zzorn/Mendel90/dibond/render/printed/x_carriage_parts.png

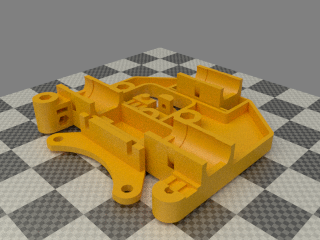
dibond/render/printed/x_carriage_parts.png
