zzorn/Mendel90/mendel/render/printed/wades_extruder.png

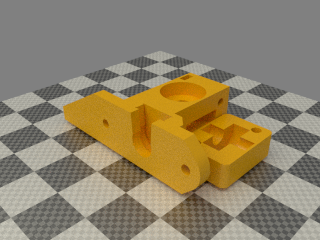
mendel/render/printed/wades_extruder.png
