zzorn/Mendel90/dibond/render/atx_long_bracket.png

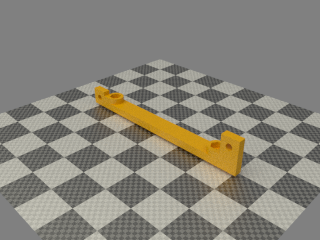
dibond/render/atx_long_bracket.png
