zzorn/Mendel90/dibond/render/atx_short_bracket.png

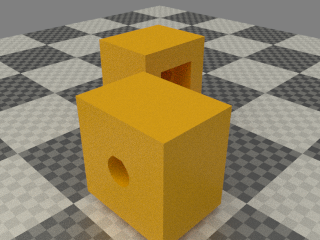
dibond/render/atx_short_bracket.png
