zzorn/Mendel90/dibond/render/d_motor_bracket.png

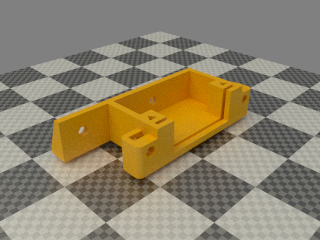
dibond/render/d_motor_bracket.png
