zzorn/Mendel90/dibond/render/d_motor_bracket_lid.png

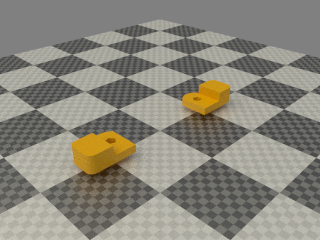
dibond/render/d_motor_bracket_lid.png
