zzorn/Mendel90/dibond/render/d_shell.png

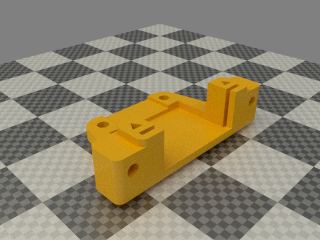
dibond/render/d_shell.png
