zzorn/Mendel90/dibond/render/d_shell_lid.png

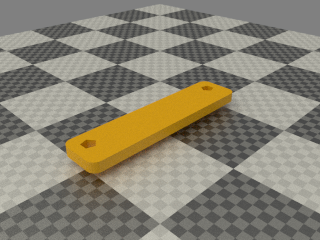
dibond/render/d_shell_lid.png
