zzorn/Mendel90/dibond/render/dust_filter.png

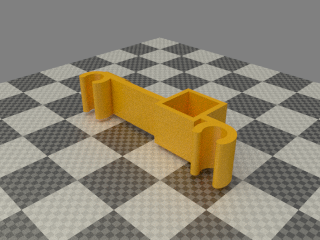
dibond/render/dust_filter.png
