zzorn/Mendel90/dibond/render/fan_guard.png

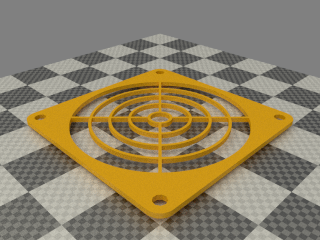
dibond/render/fan_guard.png
