zzorn/Mendel90/dibond/render/feed_tube_connector.png

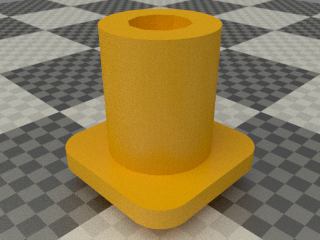
dibond/render/feed_tube_connector.png
