zzorn/Mendel90/dibond/render/fixing_block.png

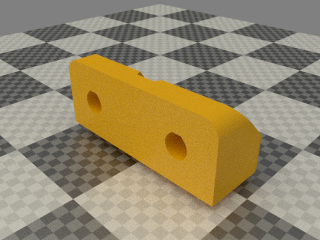
dibond/render/fixing_block.png
