zzorn/Mendel90/dibond/render/jhead_insertion_jig.png

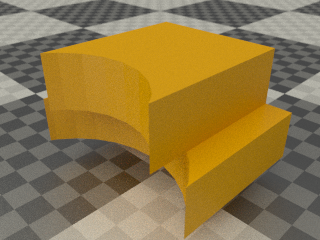
dibond/render/jhead_insertion_jig.png
