zzorn/Mendel90/dibond/render/pcb_spacer.png

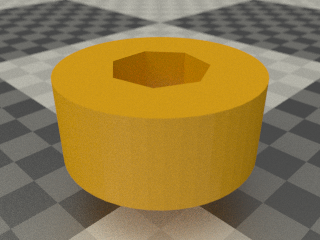
dibond/render/pcb_spacer.png
