zzorn/Mendel90/dibond/render/ribbon_clamp_14_33.png

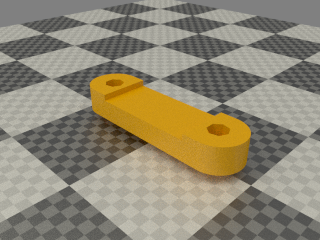
dibond/render/ribbon_clamp_14_33.png
