zzorn/Mendel90/dibond/render/ribbon_clamp_14_33NB.png

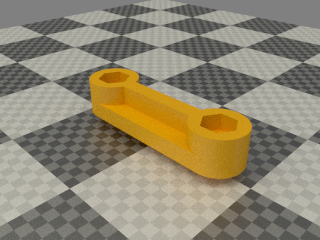
dibond/render/ribbon_clamp_14_33NB.png
