zzorn/Mendel90/dibond/render/ribbon_clamp_20_33.png

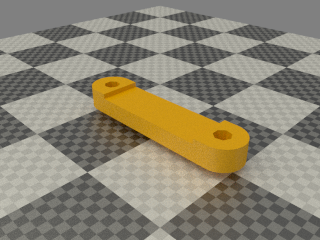
dibond/render/ribbon_clamp_20_33.png
