zzorn/Mendel90/dibond/render/ribbon_clamp_20_44N.png

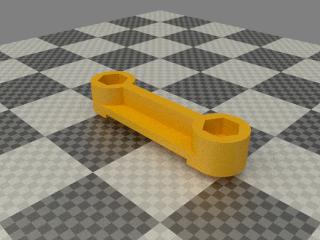
dibond/render/ribbon_clamp_20_44N.png
