zzorn/Mendel90/dibond/render/ribbon_clamp_26_44N.png

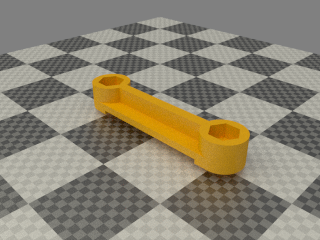
dibond/render/ribbon_clamp_26_44N.png
