zzorn/Mendel90/dibond/render/spool_bracket_female.png

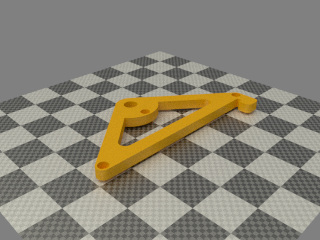
dibond/render/spool_bracket_female.png
