zzorn/Mendel90/dibond/render/spool_bracket_male.png

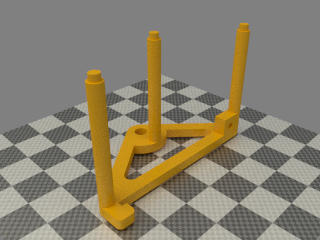
dibond/render/spool_bracket_male.png
