zzorn/Mendel90/dibond/render/tube_cap.png

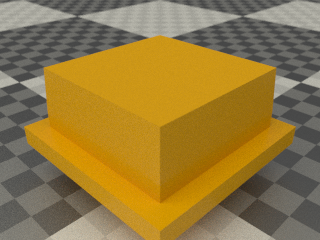
dibond/render/tube_cap.png
