zzorn/Mendel90/dibond/render/tube_jig.png

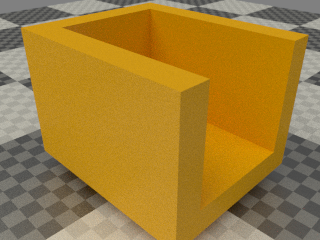
dibond/render/tube_jig.png
