zzorn/Mendel90/dibond/render/wades_big_gear.png

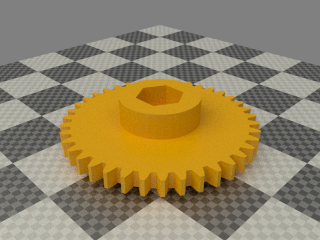
dibond/render/wades_big_gear.png
