zzorn/Mendel90/dibond/render/wades_block.png

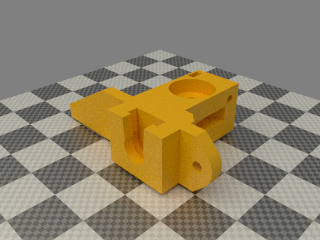
dibond/render/wades_block.png
