zzorn/Mendel90/dibond/render/wades_gear_spacer.png

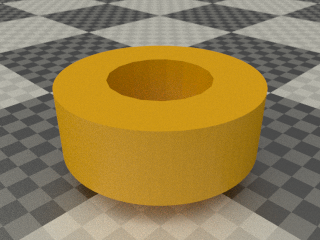
dibond/render/wades_gear_spacer.png
