zzorn/Mendel90/dibond/render/wades_idler_block.png

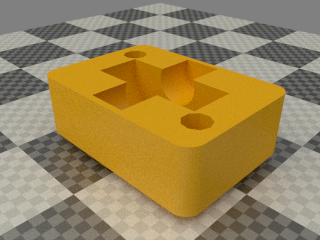
dibond/render/wades_idler_block.png
