zzorn/Mendel90/dibond/render/wades_small_gear.png

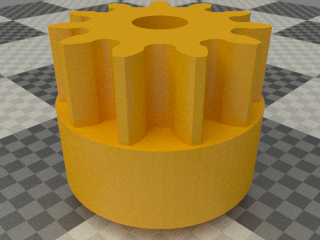
dibond/render/wades_small_gear.png
