zzorn/Mendel90/dibond/render/x_belt_clamp.png

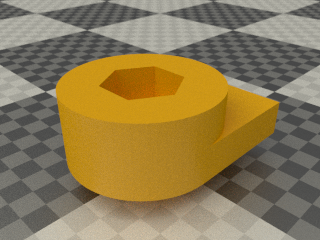
dibond/render/x_belt_clamp.png
