zzorn/Mendel90/dibond/render/x_belt_grip.png

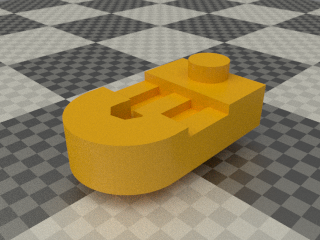
dibond/render/x_belt_grip.png
