zzorn/Mendel90/dibond/render/x_belt_tensioner.png

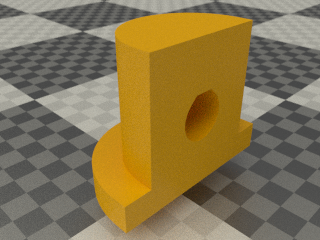
dibond/render/x_belt_tensioner.png
