zzorn/Mendel90/dibond/render/x_carriage_fan_bracket.png

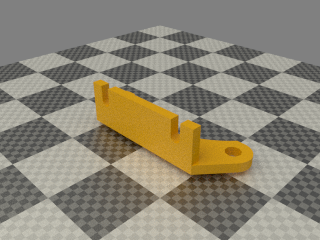
dibond/render/x_carriage_fan_bracket.png
