zzorn/Mendel90/dibond/render/x_carriage_fan_duct.png

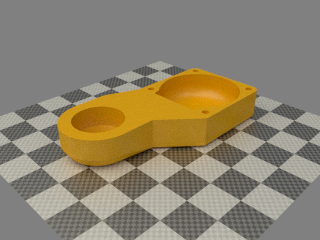
dibond/render/x_carriage_fan_duct.png
