zzorn/Mendel90/dibond/render/x_idler_bracket.png

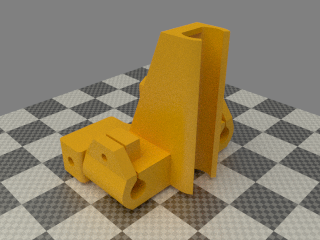
dibond/render/x_idler_bracket.png
