zzorn/Mendel90/dibond/render/x_motor_bracket.png

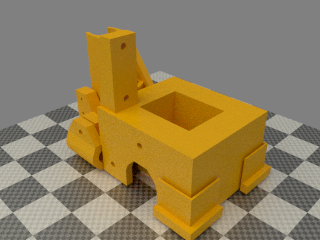
dibond/render/x_motor_bracket.png
