zzorn/Mendel90/dibond/render/y_bar_clamp.png

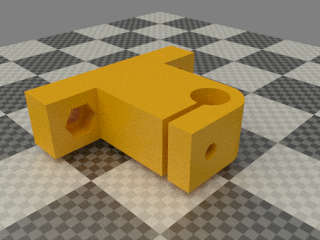
dibond/render/y_bar_clamp.png
