zzorn/Mendel90/dibond/render/y_bar_clamp_switch.png

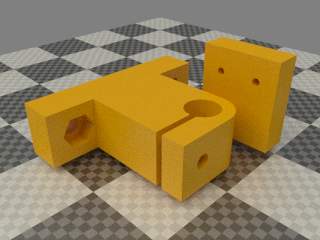
dibond/render/y_bar_clamp_switch.png
