zzorn/Mendel90/dibond/render/y_bearing_mount.png

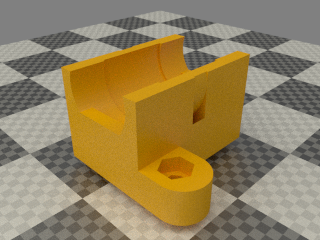
dibond/render/y_bearing_mount.png
