zzorn/Mendel90/dibond/render/y_belt_anchor.png

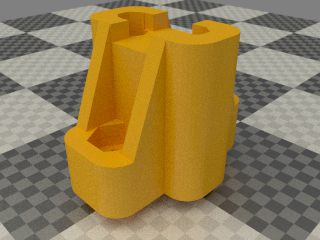
dibond/render/y_belt_anchor.png
