zzorn/Mendel90/dibond/render/y_belt_clip.png

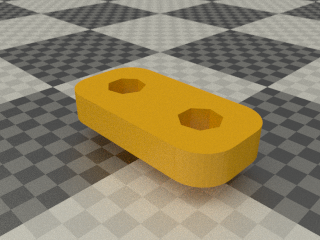
dibond/render/y_belt_clip.png
