zzorn/Mendel90/dibond/render/y_idler_bracket.png

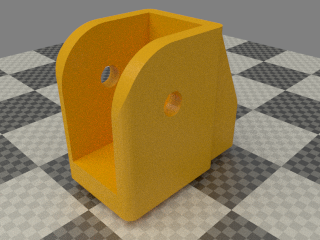
dibond/render/y_idler_bracket.png
