zzorn/Mendel90/dibond/render/y_motor_bracket.png

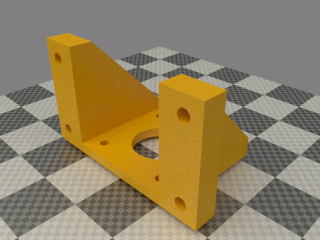
dibond/render/y_motor_bracket.png
