zzorn/Mendel90/dibond/render/z_coupling.png

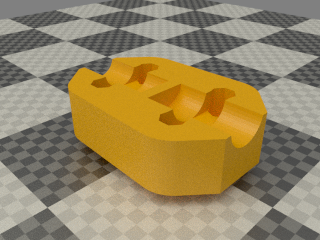
dibond/render/z_coupling.png
