zzorn/Mendel90/dibond/render/z_motor_bracket_lhs.png

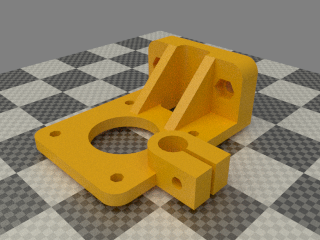
dibond/render/z_motor_bracket_lhs.png
