zzorn/Mendel90/dibond/render/z_motor_bracket_rhs.png

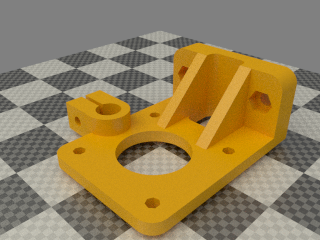
dibond/render/z_motor_bracket_rhs.png
