zzorn/Mendel90/dibond/render/z_screw_pointer.png

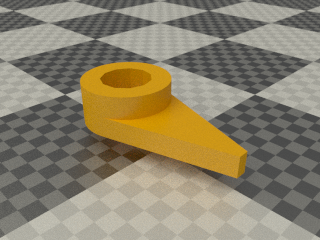
dibond/render/z_screw_pointer.png
