zzorn/Mendel90/mendel/render/atx_short_bracket.png

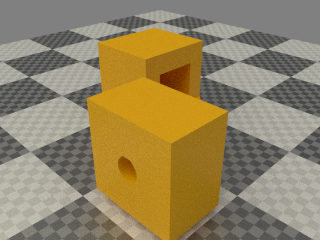
mendel/render/atx_short_bracket.png
