zzorn/Mendel90/mendel/render/pulley.png

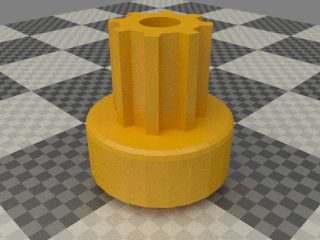
mendel/render/pulley.png
