zzorn/Mendel90/mendel/render/spool_bracket_female.png

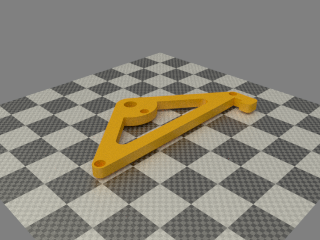
mendel/render/spool_bracket_female.png
