zzorn/Mendel90/mendel/render/spool_bracket_male.png

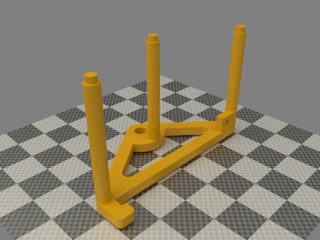
mendel/render/spool_bracket_male.png
