zzorn/Mendel90/mendel/render/y_bearing_mount.png

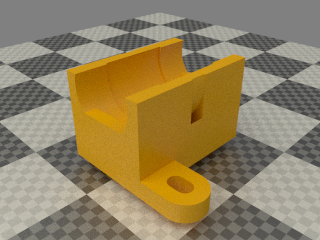
mendel/render/y_bearing_mount.png
