zzorn/Mendel90/mendel/render/y_idler_bracket.png

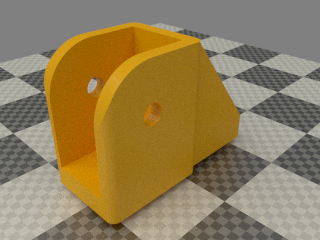
mendel/render/y_idler_bracket.png
