zzorn/Mendel90/sturdy/render/mains_inlet.png

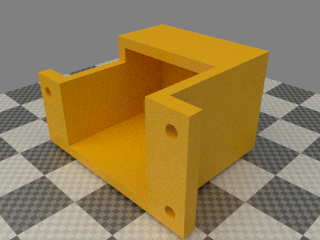
sturdy/render/mains_inlet.png
