zzorn/Mendel90/sturdy/render/spool_bracket_male.png

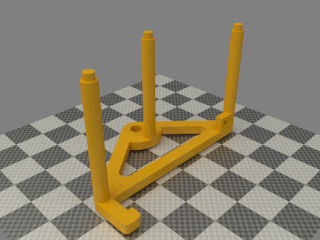
sturdy/render/spool_bracket_male.png
