zzorn/Mendel90/sturdy/render/x_carriage.png

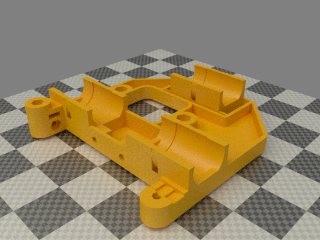
sturdy/render/x_carriage.png
