zzorn/Mendel90/sturdy/render/x_carriage_fan_duct.png

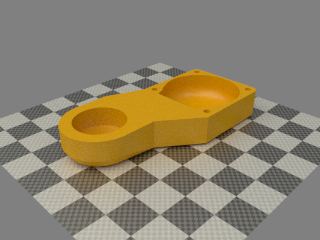
sturdy/render/x_carriage_fan_duct.png
