zzorn/Mendel90/sturdy/render/x_idler_bracket.png

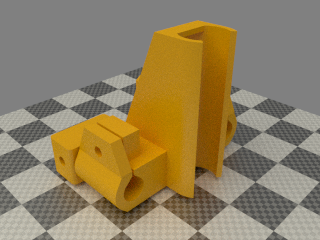
sturdy/render/x_idler_bracket.png
