zzorn/Mendel90/sturdy/render/y_bearing_mount.png

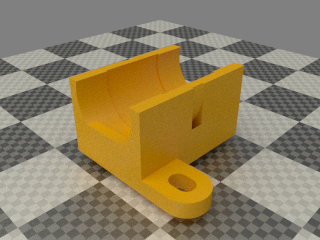
sturdy/render/y_bearing_mount.png
