zzorn/Mendel90/sturdy/render/z_bar_clamp.png

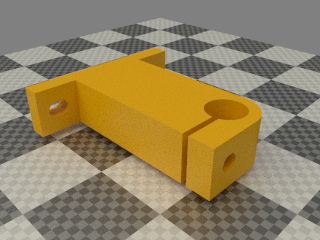
sturdy/render/z_bar_clamp.png
