zzorn/Mendel90/sturdy/render/z_motor_bracket_lhs.png

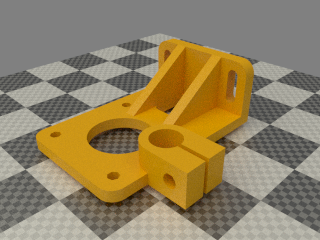
sturdy/render/z_motor_bracket_lhs.png
