zzorn/Mendel90/sturdy-a4/bom/bom.txt

Vitamins:
          E                                                      
          x                                                      
          t                                                      
          r                                                      
          u                                                      
          d                                                      
          e                                                      
          r                                                      
                                                                 
          c  E                          X                        
          o  x                                                   
          n  t                 S        c                        
    E     n  r                 p        a                        
    l     e  u                 o     X  r           Y            
    e     c  d           P     o        r                        
    c  E  t  e           r     l     c  i           c            
 B  t  x  i  r     H  M  i           a  a  X  X     a  Y  Y     Z
 e  r  t  o        o  a  n     h  X  r  g        Y  r        Z   
 d  o  r  n  m  F  t  c  t     o     r  e  i  m     r  i  m     m
    n  u     o  r     h        l  a  i     d  o  a  i  d  o  a  o
 f  i  d  p  t  a  e  i  b  P  d  x  a  f  l  t  x  a  l  t  x  t
 a  c  e  c  o  m  n  n  e  s  e  i  g  a  e  o  i  g  e  o  i  o
 n  s  r  b  r  e  d  e  d  u  r  s  e  n  r  r  s  e  r  r  s  r
  |  |  |  |  |  |  |  |  | 1|  |  |  |  |  |  |  |  |  |  |  |  |  1 THS15 Aluminium clad resistor 10R
  |  |  |  |  |  |  |  |  | 1|  |  |  |  |  |  |  |  |  |  |  |  |  1 THS15 Aluminium clad resistor 4R7
  |  |  |  |  |  |  |  | 6|  |  |  |  |  |  |  |  |  |  |  |  |  |  6 Aluminium foil tape 50mm x 220mm x 0.05mm
  |  |  |  |  |  |  |  |  | 1|  |  |  |  |  |  |  |  |  |  |  |  |  1 PSU e.g. ATX500
  |  | 3|  |  |  |  |  |  |  | 4|  |  |  |  |  |  |  |  |  |  |  |  7 Ball bearing 608 8mm x 22mm x 7mm
  |  |  |  |  |  |  |  |  |  |  |  |  |  | 2|  |  |  | 2|  |  |  |  4 Ball bearing 624 4mm x 13mm x 5mm
  |  |  |  |  |  |  |  | 4|  |  |  |  |  |  |  |  |  |  |  |  |  |  4 19mm bulldog clip
  |  |  |  |  |  |  |  | 1|  |  |  |  |  |  |  |  |  |  |  |  |  |  1 PCB bed 287mm x 200mm
  |  |  |  |  |  |  |  |  |  |  | 1|  |  |  |  |  |  |  |  |  |  |  1 Belt T5 x 6mm x 1055mm (PU & Kevlar)
  |  |  |  |  |  |  |  |  |  |  |  |  |  |  |  | 1|  |  |  |  |  |  1 Belt T5 x 6mm x 660mm (PU & Kevlar)
  |  |  |  |  |  |  |  | 1|  |  |  |  |  |  |  |  |  |  |  |  |  |  1 Corrugated cardboard 273mm x 210mm x 6mm
  |  |  |  |  |  |  |  | 4|  |  |  | 2|  |  |  |  |  |  |  |  |  |  6 M3 cap screw x 10mm
  | 4|  |  |  |  |  |  |  |  |  |  |  |  |  | 4|  | 8|  |  |  |  | 16 M3 cap screw x 16mm
  |  |  |  |  |  |  |  |  |  |  |  | 1|  |  | 2|  |  |  |  |  | 8| 11 M3 cap screw x 20mm
  |  |  |  |  |  |  |  |  |  |  |  | 2|  |  |  |  |  |  |  |  |  |  2 M3 cap screw x 25mm
  |  |  |  | 2|  |  |  |  |  |  |  |  |  |  |  |  |  |  |  |  |  |  2 M3 cap screw x 45mm
  |  |  |  |  |  |  |  |  |  |  |  |  |  |  |  |  | 6|  |  |  |  |  6 M4 cap screw x 16mm
  |  |  |  |  |  |  |  |  |  |  |  |  |  |  |  | 4| 2|  |  | 2| 2| 10 M4 cap screw x 20mm
 4|  |  |  |  |  |  |  |  |  |  |  |  |  |  |  |  |  |  |  |  |  |  4 M4 cap screw x 25mm
  |  |  |  |  |  |  |  |  |  |  |  |  | 4|  |  |  |  | 1|  |  |  |  5 M4 cap screw x 30mm
  |  |  |  |  |  |  |  |  |  |  |  |  |  | 1|  |  |  |  |  |  |  |  1 M4 cap screw x 45mm
  |  |  |  |  |  |  |  |  |  | 4|  |  |  |  |  |  |  |  |  |  |  |  4 M8 cap screw x 30mm
  |  |  |  |  |  |  |  |  |  |  |  |  |  |  |  |  | 1|  |  |  |  |  1 Dibond sheet 297mm x 210mm x 3mm
  |  |  |  | 1|  |  |  |  |  |  |  |  |  |  |  |  |  |  |  |  |  |  1 15 way D PCB mount plug
  |  |  |  |  |  |  |  |  |  |  |  |  |  |  | 1|  |  |  |  |  |  |  1 15 way D IDC socket
  |  |  |  |  |  |  |  |  |  |  |  |  | 1|  |  |  |  |  |  |  |  |  1 Fan 60mm x 15mm
  |  |  |  |  |  |  |  |  |  | 1|  |  |  |  |  |  |  |  |  |  |  |  1 Foam sponge 20mm x 20mm x 20mm
  |  |  |  |  |  |  |  |  |  |  |  |  |  |  | 1|  |  |  | 1|  |  |  2 M3 grub screw x 3mm
  |  |  |  | 1|  |  |  |  |  |  |  |  |  |  |  |  |  |  |  |  |  |  1 M3 grub screw x 6mm
  |  |  |  |  |  |  |  | 1|  |  |  |  |  |  |  |  |  |  |  |  |  |  1 Glass sheet 287mm x 188mm x 2mm
  |  |  |  |  |  | 1|  |  |  |  |  |  |  |  |  |  |  |  |  |  |  |  1 JHead MK4 hot end
  |  |  |  |  |  |  |  | 4|  |  |  |  |  |  |  |  |  |  |  |  |  |  4 Hex male / female pillar M3 x 20mm
  |  | 3|  |  |  |  |  |  |  |  |  |  |  |  |  |  |  |  |  |  |  |  3 M3 hex screw x 10mm
  |  |  |  |  |  |  |  |  |  |  |  |  |  |  | 2|  |  |  |  |  |  |  2 M3 hex screw x 16mm
  |  |  |  |  |  |  |  |  |  |  |  |  |  | 2| 2|  |  |  |  |  |  |  4 M4 hex screw x 16mm
  |  | 2|  |  |  |  |  |  |  |  |  |  |  |  |  |  |  |  |  |  |  |  2 M4 hex screw x 20mm
  |  | 2|  |  |  |  |  |  |  |  |  |  |  |  |  |  |  |  |  |  |  |  2 M4 hex screw x 50mm
  |  | 1|  |  |  |  |  |  |  |  |  |  |  |  |  |  |  |  |  |  |  |  1 M8 hex screw x 60mm, hobbed at 25
  |  |  |  |  |  |  |  |  |  |  |  | 3|  | 2| 2|  | 3|  |  |  |  | 10 LM10UU linear bearing
  |  |  |  |  | 2|  |  |  |  |  |  |  |  |  |  |  |  |  |  |  |  |  2 MDF sheet 153mm x 435mm x 12mm
  |  |  |  |  | 1|  |  |  |  |  |  |  |  |  |  |  |  |  |  |  |  |  1 MDF sheet 562mm x 419mm x 12mm
  |  |  |  |  | 1|  |  |  |  |  |  |  |  |  |  |  |  |  |  |  |  |  1 MDF sheet 562mm x 435mm x 12mm
  |  |  |  | 1|  |  |  |  |  |  |  |  |  |  | 1|  |  |  | 1|  | 2|  5 NEMA17 x 47.5mm stepper motor
  |  |  |  |  |  |  |  |  |  |  |  |  |  |  |  |  |  |  |  | 2|  |  2 Brass nut M8
  |  |  |  | 3|  |  |  |  |  |  |  | 1|  |  |  |  |  |  |  |  |  |  4 Nut M3
  |  | 2|  |  |  |  |  |  |  |  |  |  |  |  |  |  |  |  |  |  |  |  2 Nut M4
  |  | 2|  |  |  |  |  |  |  |  |  |  |  |  |  |  |  |  |  |  |  |  2 Nut M8
  |  |  |  |  |  |  |  |  |  |  |  | 4|  |  | 6|  | 8|  |  |  | 8| 26 Nyloc nut M3
 4|  |  |  |  |  |  |  |  |  |  |  |  | 4| 3| 2| 4| 8| 1|  | 2| 2| 30 Nyloc nut M4
  |  |  |  |  |  |  |  |  |  | 4|  |  |  |  |  |  |  |  |  |  |  |  4 Nyloc nut M8
  |  |  |  |  |  |  |  |  |  |  |  |  |  |  | 2|  |  |  |  |  |  |  2 Nitrile O-ring 2.5mm x 1.6mm
  |  |  | 1|  |  |  |  |  |  |  |  |  |  |  |  |  |  |  |  |  |  |  1 Extruder connection PCB
  |  |  |  |  |  |  |  |  |  | 1|  |  |  |  |  |  |  |  |  |  |  |  1 PLA sample 0.3mm ~20m
  |  |  |  |  |  |  |  |  |  |  |  |  |  |  | 1|  |  |  |  |  |  |  1 Polypropylene strip 484mm x 18mm x 0.5mm
  |  |  |  |  |  |  |  |  |  |  |  |  |  |  | 1|  |  |  |  |  |  |  1 Polypropylene strip 552mm x 25mm x 0.5mm
  |  |  |  |  |  |  |  | 1|  |  |  |  |  |  |  |  |  |  |  |  |  |  1 Polypropylene strip 273mm x 33mm x 0.5mm
  |  |  |  |  |  |  |  |  |  |  |  |  |  |  | 3|  |  |  | 4|  | 8| 15 M3 pan screw x 8mm
  |  |  |  |  |  |  |  |  | 2|  |  |  |  |  |  |  |  |  |  |  |  |  2 6-32 pan screw x 9.5mm
  |  |  |  | 2|  |  |  |  |  |  |  |  |  |  | 4| 2|  |  |  | 2|  | 10 No2 pan wood screw x 13mm
  |  |  |  |  |  |  |  |  | 4|  |  |  |  |  |  |  |  |  |  |  |  |  4 No2 pan wood screw x undefmm
  |  |  |  |  |39|  |  |  | 3| 2|  |  |  |  |  | 8|  | 1| 4| 4| 4| 65 No6 pan wood screw x 16mm
  |  |  |  |  |  |  |  |  |  |  |  |  |  |  | 1|  |  |  | 1|  |  |  2 T5 pulley 10 teeth
  |  |  |  |  |  |  |  |  |  |  |  |  |  |  | 1|  |  |  |  |  |  |  1 Ribbon cable 20 way 1398mm
  |  |  |  |  |  |  |  | 1|  |  |  |  |  |  |  |  |  |  |  |  |  |  1 Ribbon cable 26 way 383mm
  |  |  |  |  |  |  |  |  |  |  |  |  |  |  |  | 1|  |  |  |  |  |  1 Smooth rod 10mm x 280mm
  |  |  |  |  |  |  |  |  |  |  |  |  |  |  |  |  |  |  |  | 2|  |  2 Smooth rod 10mm x 386mm
  |  |  |  |  |  |  |  |  |  |  |  |  |  |  |  | 1|  |  |  |  |  |  1 Smooth rod 10mm x 415mm
  |  |  |  |  |  |  |  |  |  |  | 2|  |  |  |  |  |  |  |  |  |  |  2 Smooth rod 10mm x 476mm
  |  | 1|  |  |  |  |  |  |  |  |  |  |  |  |  |  |  |  |  |  |  |  1 Smooth rod 8mm x 22mm
  | 1|  |  |  |  |  |  |  |  |  |  |  |  |  |  |  |  |  |  |  |  |  1 Electronics e.g. Sanguinolou
  |  |  |  |  |  |  |  |  |  |  |  |  |  |  | 1| 1|  |  |  | 1|  |  3 Microswitch
  |  | 2|  |  |  |  |  |  |  |  |  |  |  |  |  |  |  |  |  |  |  |  2 Spring 7mm OD, 1mm gauge x 10mm long
  |  |  |  |  |  |  |  |  |  |  |  |  |  |  |  |  |  |  |  | 2|  |  2 Threaded rod M8 x 323mm
  |  |  |  |  |  |  |  |  | 1|  |  |  |  |  |  |  |  |  |  |  |  |  1 Heatshrink sleeving ID 10mm x 15mm
  |  |  |  |  |  | 2|  |  |  |  |  |  |  |  |  |  |  |  |  |  |  |  2 PTFE sleeving OD 1.2mm ID 0.71mm x 62mm
  |  |  |  |  |  | 2|  | 2|  |  |  |  |  |  |  |  |  |  |  |  |  |  4 Heatshrink sleeving ID 1.6mm x 15mm
  |  |  |  |  |  | 2|  |  |  |  |  |  |  |  |  |  |  |  |  |  |  |  2 PTFE sleeving OD 2.6mm ID 2mm x 45mm
  | 2|  |  |  |  | 2|  | 2| 3|  |  |  |  |  | 4|  |  |  |  |  |  | 13 Heatshrink sleeving ID 2.4mm x 15mm
  |  |  |  |  |  |  |  |  | 5|  |  |  |  |  |  |  |  |  |  |  |  |  5 Heatshrink sleeving ID 3.2mm x 15mm
  |  |  |  |  |  |  |  |  |  | 1|  |  |  |  |  |  |  |  |  |  |  |  1 PTFE tubing OD 4.6mm ID 3.84mm x 750mm
  |  |  |  |  |  |  |  |  |  |  |  |  |  |  |  |  |  |  |  |  | 2|  2 PVC aquarium tubing OD 6mm ID 4mm x 16mm
  |  |  |  |  |  |  |  |  | 2|  |  |  |  |  |  |  |  |  |  |  |  |  2 Heatshrink sleeving ID 6.4mm x 15mm
  |  |  |  |  |  |  |  | 2|  |  |  |  |  |  |  |  |  |  |  |  |  |  2 Heatshrink sleeving ID 6.4mm x 30mm
  |  |  |  |  |  | 1|  |  |  |  |  |  |  |  |  |  |  |  |  |  |  |  1 Heatshrink sleeving ID 6.4mm x 60mm
  |  |  | 4|  |  |  |  |  |  |  |  |  |  |  |  |  |  |  |  |  |  |  4 3 way terminal block
  |  |  |  |  |  |  |  | 1|  |  |  |  |  |  |  |  |  |  |  |  |  |  1 Epcos B57861S104F40 100K 1% thermistor
  |  |  |  | 2|  |  |  |  |  |  |  |  |  |  | 4| 2|  |  |  | 2|  | 10 Washer M2.5 x 5.9mm x 0.5mm
  | 4| 3|  | 2|  |  |  | 4|  |  |  | 4|  |  |11|  | 8|  | 4|  |16| 56 Washer M3 x 7mm x 0.5mm
 4|  |  |  |  |39|  |  |  | 5| 2|  |  | 4| 4| 2|12|14| 5| 4| 6| 6|107 Washer M4 x 9mm x 0.8mm
  |  |  |  |  |  |  |  |  |  |  |  |  |  | 2|  |  |  | 2|  |  |  |  4 Washer M5 x 20mm x 1.4mm
  |  |  |  |  |  |  |  |  |  | 8|  |  |  |  |  |  |  |  |  |  |  |  8 Washer M8 x 17mm x 1.6mm
  |  |  |  |  |  |  |  |  |  | 4|  |  |  |  |  |  |  |  |  |  |  |  4 Washer M8 x 30mm x 1.5mm
  |  |  |  |  |  |  |  |  |  |  | 2|  |  |  |  |  |  |  |  |  |  |  2 Wingnut M4
  |  |  |  |  |  | 2|  |  |  |  |  |  |  |  |  |  |  |  |  |  |  |  2 Red wire 16/0.2 length 170mm
  |  |  |  |  |  |  |  | 1|  |  |  |  |  |  |  |  |  |  |  |  |  |  1 Black wire 32/0.2 length 635mm
  |  |  |  |  |  |  |  | 1|  |  |  |  |  |  |  |  |  |  |  |  |  |  1 Red wire 32/0.2 length 620mm
  | 4| 3|  |  |  |  |  |  |  |  |  |  |  |  | 3|  |  |  | 4|  | 8| 22 Star washer M3 x 0.5mm
  |  |  |  |  |39|  |  |  | 5| 2|  |  |  |  |  | 8|  | 1| 4| 4| 4| 67 Star washer M4 x 0.8mm
  |  | 1|  |  |  |  |  |  |  |  |  |  |  |  |  |  |  |  |  |  |  |  1 Star washer M8 x 1.6mm
  |  |  |  |  |  | 1|  |  | 2|  |  |  |  |  |  |  |  |  |  |  |  |  3 Ziptie 100mm min length
  |  |  |  |  |  |  |  |  |  |  |  | 3|  |  |  |  | 3|  |  |  |  |  6 Ziptie 105mm min length

Printed:
  |  |  |  |  |  |  |  |  | 1|  |  |  |  |  |  |  |  |  |  |  |  |  1 atx_long_bracket.stl
  |  |  |  |  |  |  |  |  | 1|  |  |  |  |  |  |  |  |  |  |  |  |  1 atx_short_bracket.stl
  |  |  |  |  | 2|  |  |  |  |  |  |  |  |  |  |  |  |  |  |  |  |  2 cable_clip_AB.stl
  |  |  |  |  | 2|  |  |  |  |  |  |  |  |  |  |  |  |  |  |  |  |  2 cable_clip_AD.stl
  |  |  |  |  | 1|  |  |  |  |  |  |  |  |  |  |  |  |  |  |  |  |  1 cable_clip_CA.stl
  |  |  |  | 1|  |  |  |  |  |  |  |  |  |  |  |  |  |  |  |  |  |  1 d_motor_bracket.stl
  |  |  |  | 1|  |  |  |  |  |  |  |  |  |  |  |  |  |  |  |  |  |  1 d_motor_bracket_lid.stl
  |  |  |  |  |  |  |  |  |  |  |  |  |  |  | 1|  |  |  |  |  |  |  1 d_shell.stl
  |  |  |  |  |  |  |  |  |  |  |  |  |  |  | 1|  |  |  |  |  |  |  1 d_shell_lid.stl
  |  |  |  |  |  |  |  |  |  | 1|  |  |  |  |  |  |  |  |  |  |  |  1 dust_filter.stl
 1|  |  |  |  |  |  |  |  |  |  |  |  |  |  |  |  |  |  |  |  |  |  1 fan_guard.stl
  |  |  |  |  |  |  |  |  |  | 1|  |  |  |  |  |  |  |  |  |  |  |  1 feed_tube_connector.stl
  |  |  |  |  |10|  |  |  |  |  |  |  |  |  |  |  |  |  |  |  |  | 10 fixing_block.stl
  |  | 1|  |  |  |  |  |  |  |  |  |  |  |  |  |  |  |  |  |  |  |  1 jhead_insertion_jig.stl
  | 4|  |  |  |  |  |  |  |  |  |  |  |  |  |  |  |  |  |  |  |  |  4 pcb_spacer.stl
  |  |  |  |  |  |  |  |  |  |  |  |  |  |  | 1|  |  |  |  |  |  |  1 ribbon_clamp_14_33.stl
  |  |  |  |  |  |  |  |  |  |  |  |  |  |  | 1|  |  |  |  |  |  |  1 ribbon_clamp_14_33NB.stl
  |  |  |  |  |  |  |  |  |  |  |  |  |  |  | 1|  |  |  |  |  |  |  1 ribbon_clamp_20_33.stl
  |  |  |  |  | 1|  |  |  |  |  |  |  |  |  |  |  |  |  |  |  |  |  1 ribbon_clamp_20_40.stl
  |  |  |  |  | 1|  |  |  |  |  |  |  |  |  |  |  |  |  |  |  |  |  1 ribbon_clamp_26_40.stl
  |  |  |  |  |  |  |  |  |  |  |  |  |  |  |  |  | 1|  |  |  |  |  1 ribbon_clamp_26_44.stl
  |  |  |  |  |  |  |  |  |  |  |  |  |  |  |  |  | 1|  |  |  |  |  1 ribbon_clamp_26_44N.stl
  |  |  |  |  |  |  |  |  |  | 2|  |  |  |  |  |  |  |  |  |  |  |  2 spool_bracket_female.stl
  |  |  |  |  |  |  |  |  |  | 2|  |  |  |  |  |  |  |  |  |  |  |  2 spool_bracket_male.stl
  |  | 1|  |  |  |  |  |  |  |  |  |  |  |  |  |  |  |  |  |  |  |  1 wades_big_gear.stl
  |  | 1|  |  |  |  |  |  |  |  |  |  |  |  |  |  |  |  |  |  |  |  1 wades_block.stl
  |  | 1|  |  |  |  |  |  |  |  |  |  |  |  |  |  |  |  |  |  |  |  1 wades_gear_spacer.stl
  |  | 1|  |  |  |  |  |  |  |  |  |  |  |  |  |  |  |  |  |  |  |  1 wades_idler_block.stl
  |  |  |  | 1|  |  |  |  |  |  |  |  |  |  |  |  |  |  |  |  |  |  1 wades_small_gear.stl
  |  |  |  |  |  |  |  |  |  |  |  | 1|  |  |  |  |  |  |  |  |  |  1 x_belt_clamp.stl
  |  |  |  |  |  |  |  |  |  |  |  | 1|  |  |  |  |  |  |  |  |  |  1 x_belt_grip.stl
  |  |  |  |  |  |  |  |  |  |  |  | 1|  |  |  |  |  |  |  |  |  |  1 x_belt_tensioner.stl
  |  |  |  |  |  |  |  |  |  |  |  | 1|  |  |  |  |  |  |  |  |  |  1 x_carriage.stl
  |  |  |  |  |  |  |  |  |  |  |  |  | 1|  |  |  |  |  |  |  |  |  1 x_carriage_fan_bracket.stl
  |  |  |  |  |  |  |  |  |  |  |  |  | 1|  |  |  |  |  |  |  |  |  1 x_carriage_fan_duct.stl
  |  |  |  |  |  |  |  |  |  |  |  |  |  | 1|  |  |  |  |  |  |  |  1 x_idler_bracket.stl
  |  |  |  |  |  |  |  |  |  |  |  |  |  |  | 1|  |  |  |  |  |  |  1 x_motor_bracket.stl
  |  |  |  |  |  |  |  |  |  |  |  |  |  |  |  | 3|  |  |  |  |  |  3 y_bar_clamp.stl
  |  |  |  |  |  |  |  |  |  |  |  |  |  |  |  | 1|  |  |  |  |  |  1 y_bar_clamp_switch.stl
  |  |  |  |  |  |  |  |  |  |  |  |  |  |  |  |  | 2|  |  |  |  |  2 y_bearing_mount.stl
  |  |  |  |  |  |  |  |  |  |  |  |  |  |  |  |  | 1|  |  |  |  |  1 y_bearing_mount_switch.stl
  |  |  |  |  |  |  |  |  |  |  |  |  |  |  |  |  | 1|  |  |  |  |  1 y_belt_anchor.stl
  |  |  |  |  |  |  |  |  |  |  |  |  |  |  |  |  | 1|  |  |  |  |  1 y_belt_anchor_toothed.stl
  |  |  |  |  |  |  |  |  |  |  |  |  |  |  |  |  | 1|  |  |  |  |  1 y_belt_clip.stl
  |  |  |  |  |  |  |  |  |  |  |  |  |  |  |  |  | 1|  |  |  |  |  1 y_belt_clip_toothed.stl
  |  |  |  |  |  |  |  |  |  |  |  |  |  |  |  |  |  | 1|  |  |  |  1 y_idler_bracket.stl
  |  |  |  |  |  |  |  |  |  |  |  |  |  |  |  |  |  |  | 1|  |  |  1 y_motor_bracket.stl
  |  |  |  |  |  |  |  |  |  |  |  |  |  |  |  |  |  |  |  | 1|  |  1 z_bar_clamp.stl
  |  |  |  |  |  |  |  |  |  |  |  |  |  |  |  |  |  |  |  | 1|  |  1 z_bar_clamp_switch.stl
  |  |  |  |  |  |  |  |  |  |  |  |  |  |  |  |  |  |  |  |  | 4|  4 z_coupling.stl
  |  |  |  |  |  |  |  |  |  |  |  |  |  |  |  |  |  |  |  |  | 1|  1 z_motor_bracket_lhs.stl
  |  |  |  |  |  |  |  |  |  |  |  |  |  |  |  |  |  |  |  |  | 1|  1 z_motor_bracket_rhs.stl
  |  |  |  |  |  |  |  |  |  |  |  |  |  |  |  |  |  |  |  | 2|  |  2 z_screw_pointer.stl

Sub-assemblies:
  1 bed_fan_assembly
  1 electronics_assembly
  1 extruder_assembly
  1 extruder_connection_pcb_assembly
  1 extruder_motor_assembly
  1 frame_assembly
  1 hot_end_assembly
  1 machine_assembly
  1 print_bed_assembly
  1 psu_assembly
  1 spool_holder_assembly
  1 x_axis_assembly
  1 x_carriage_assembly
  1 x_carriage_fan_assembly
  1 x_idler_assembly
  1 x_motor_assembly
  1 y_axis_assembly
  1 y_carriage_assembly
  1 y_idler_assembly
  1 y_motor_assembly
  1 z_axis_assembly
  2 z_motor_assemblies
