zzorn/Mendel90/sturdy/render/printed/x_carriage_parts.png

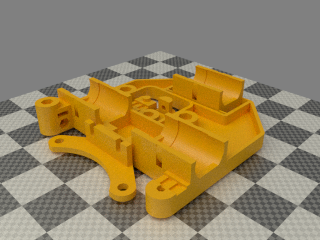
sturdy/render/printed/x_carriage_parts.png
