zzorn/Mendel90/sturdy/stls/mains_inlet.stl

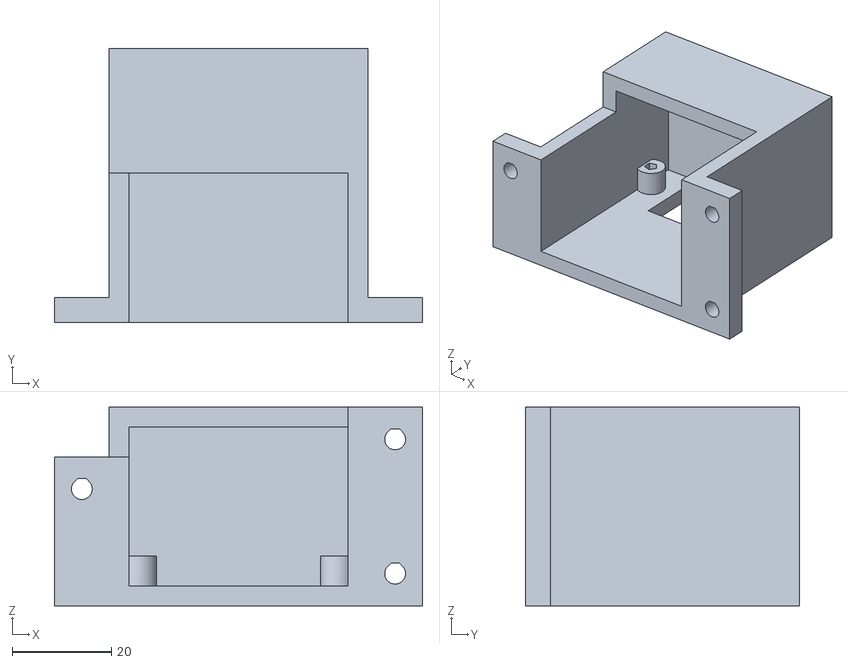
[picture p62: CAD file, 2012-12-09]
sturdy/stls/mains_inlet.stl
74.0 x 55.0 x 40.0
