zzorn/Mendel90/dibond/sheets/y_carriage.dxf

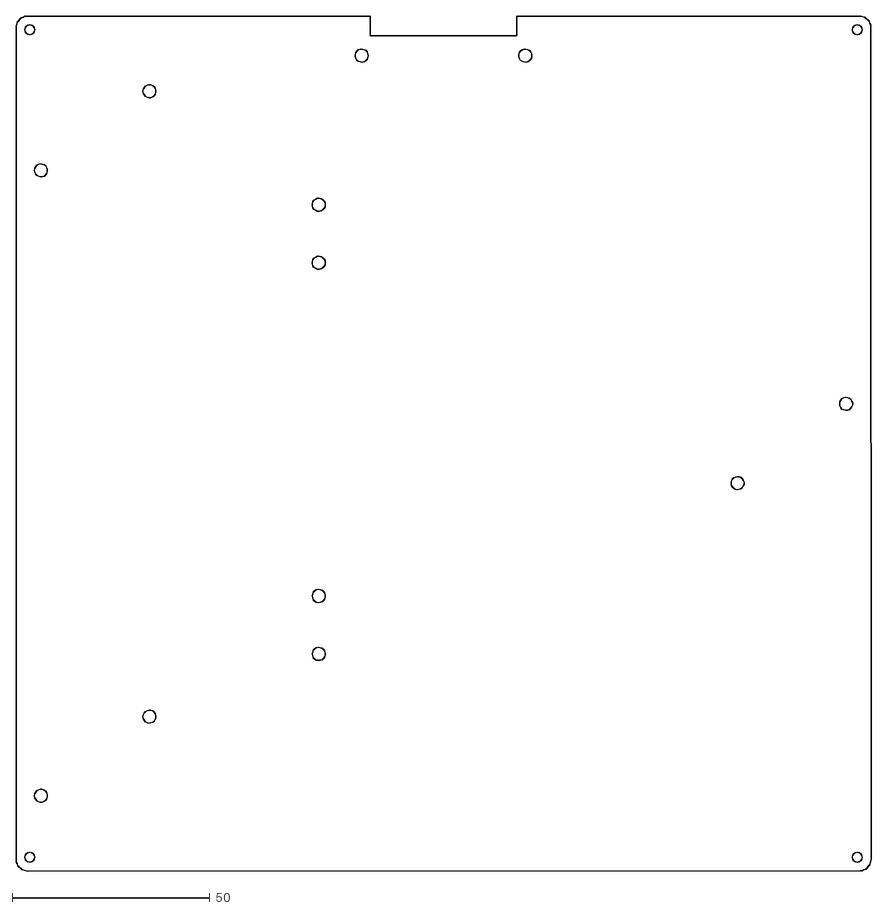
[picture p63: CAD file, 2012-12-09]
dibond/sheets/y_carriage.dxf
216.0 x 216.0
