zzorn/Mendel90/dibond/stls/printed/y_bearing_mounts.stl

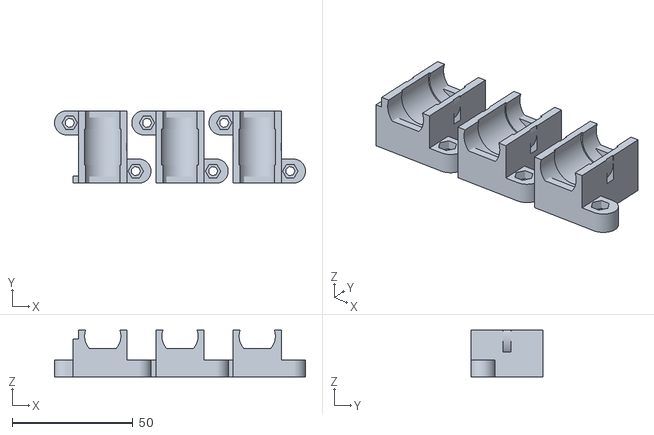
[picture p64: CAD file, 2012-12-09]
dibond/stls/printed/y_bearing_mounts.stl
104.0 x 30.0 x 19.3
