zzorn/Mendel90/dibond/stls/y_motor_bracket.stl

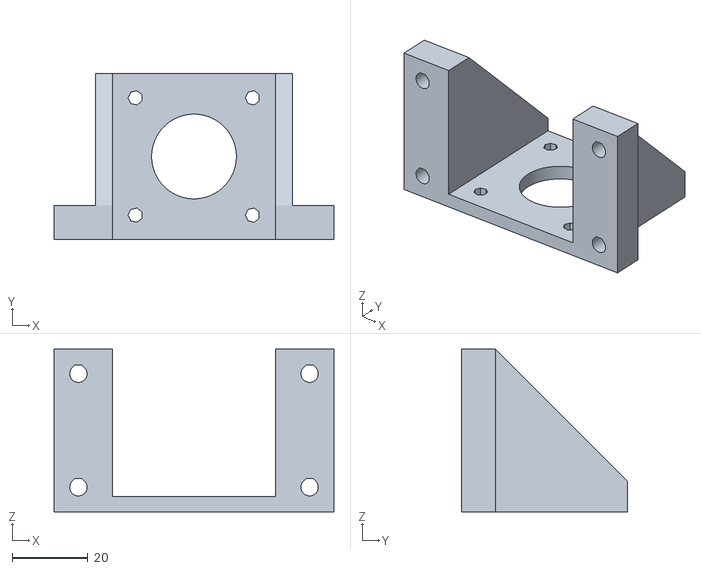
[picture p65: CAD file, 2012-12-09]
dibond/stls/y_motor_bracket.stl
74.0 x 44.0 x 43.0
