zzorn/Mendel90/mendel/sheets/frame_base.dxf

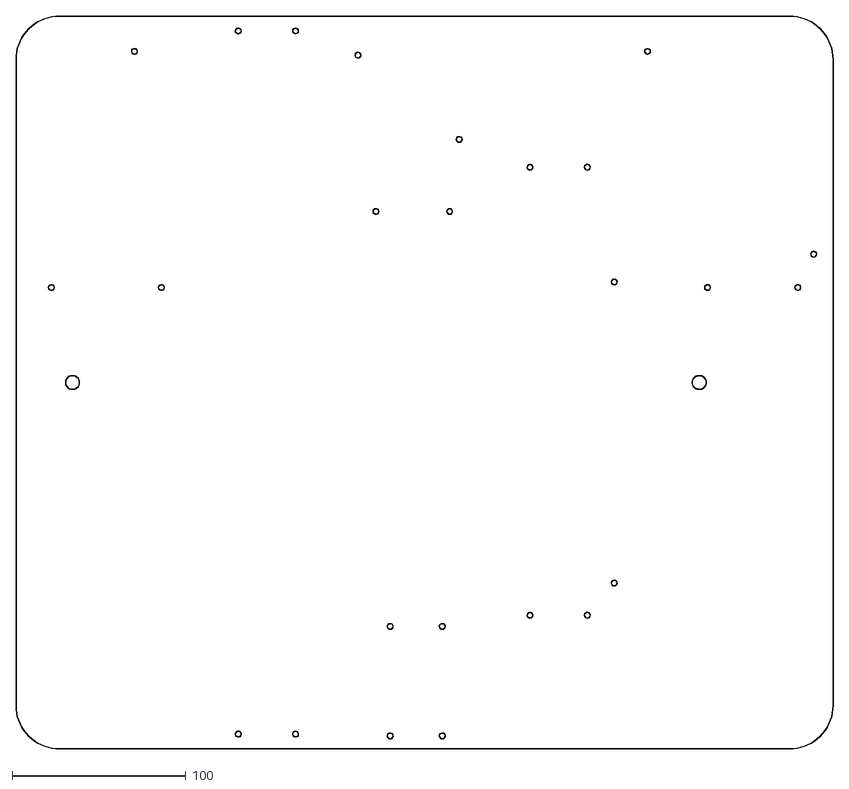
[picture p66: CAD file, 2012-12-09]
mendel/sheets/frame_base.dxf
470.5 x 422.0
