zzorn/Mendel90/mendel/stls/printed/x_carriage_parts.stl

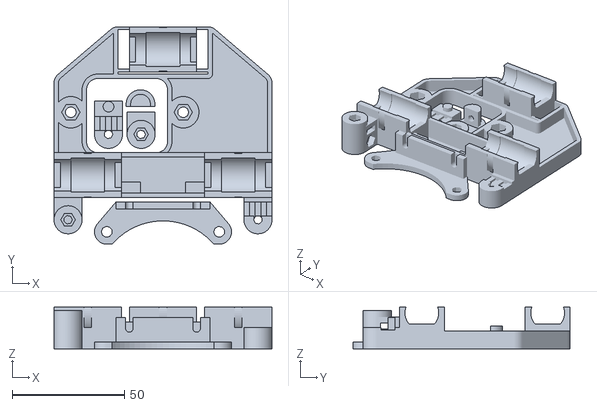
[picture p67: CAD file, 2012-12-09]
mendel/stls/printed/x_carriage_parts.stl
97.0 x 96.7 x 18.5
