zzorn/Mendel90/mendel/stls/ribbon_clamp_14_33NB.stl

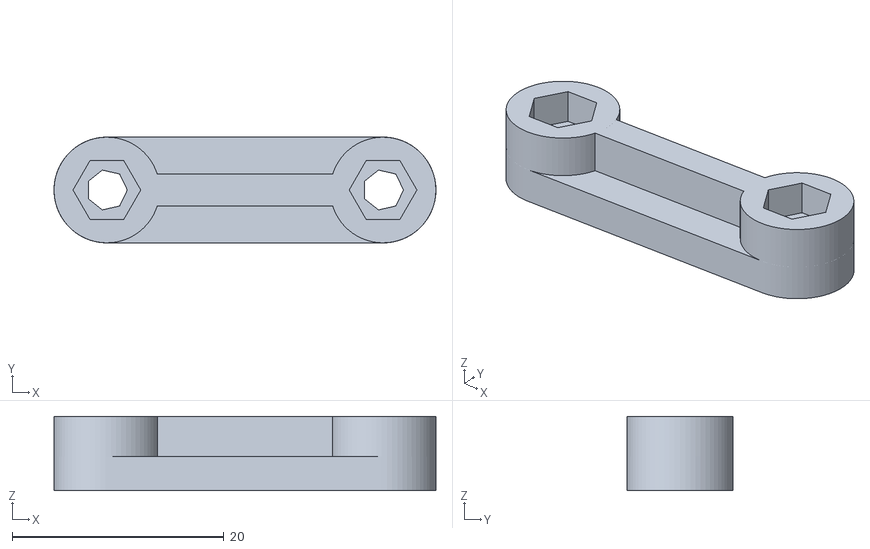
[picture p68: CAD file, 2012-12-09]
mendel/stls/ribbon_clamp_14_33NB.stl
36.1 x 10.00 x 7.01
