zzorn/Mendel90/sturdy-a4/sheets/y_carriage.dxf

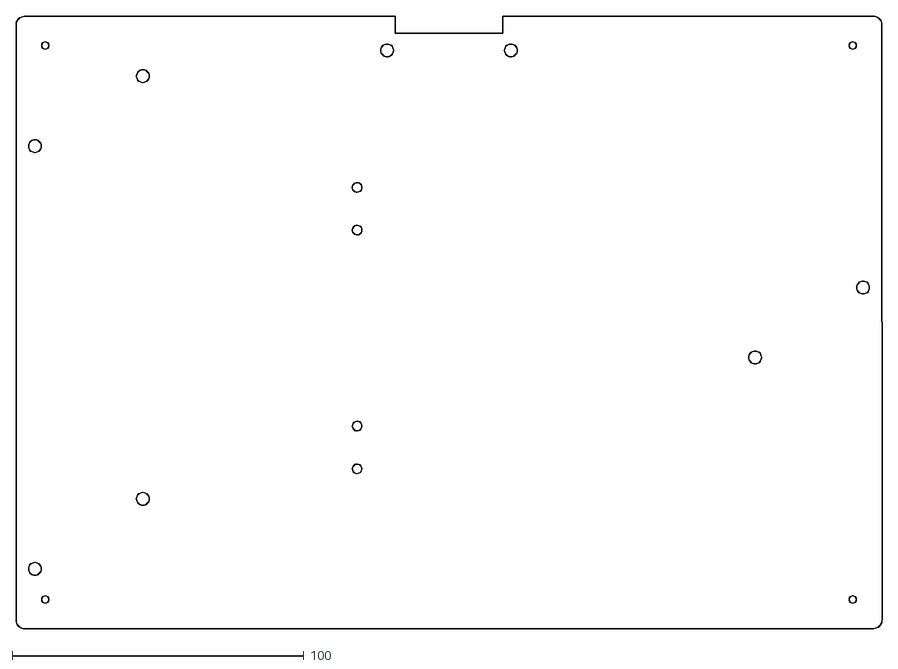
[picture p69: CAD file, 2012-12-09]
sturdy-a4/sheets/y_carriage.dxf
297.0 x 210.0
