zzorn/Mendel90/sturdy-a4/stls/printed/ribbon_clamps.stl

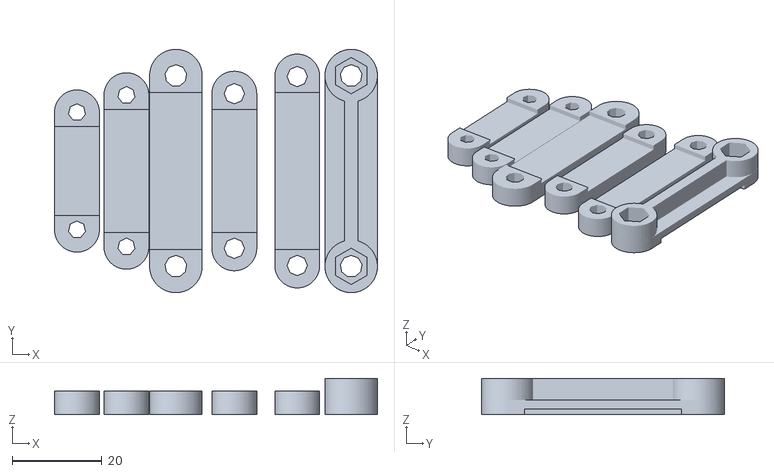
[picture p70: CAD file, 2012-12-09]
sturdy-a4/stls/printed/ribbon_clamps.stl
71.8 x 54.1 x 8.01
