zzorn/Mendel90/sturdy-a4/stls/ribbon_clamp_20_33.stl

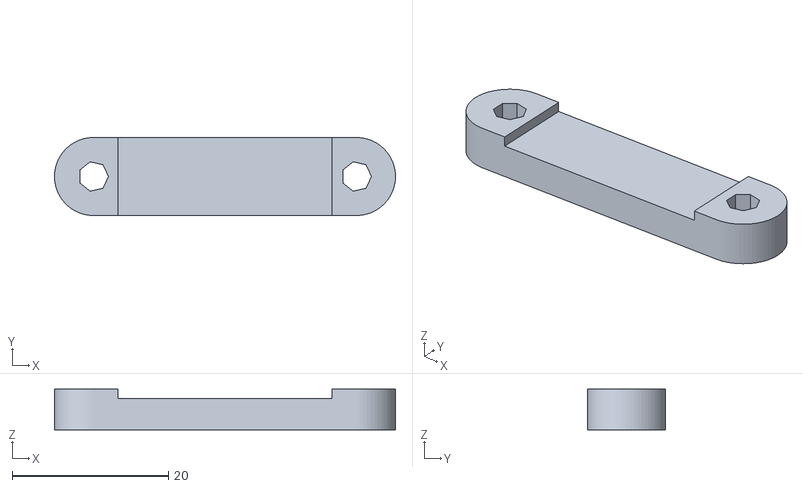
[picture p71: CAD file, 2012-12-09]
sturdy-a4/stls/ribbon_clamp_20_33.stl
43.7 x 10.00 x 5.20
