zzorn/Mendel90/sturdy/sheets/frame_gantry_and_y_carriage.dxf

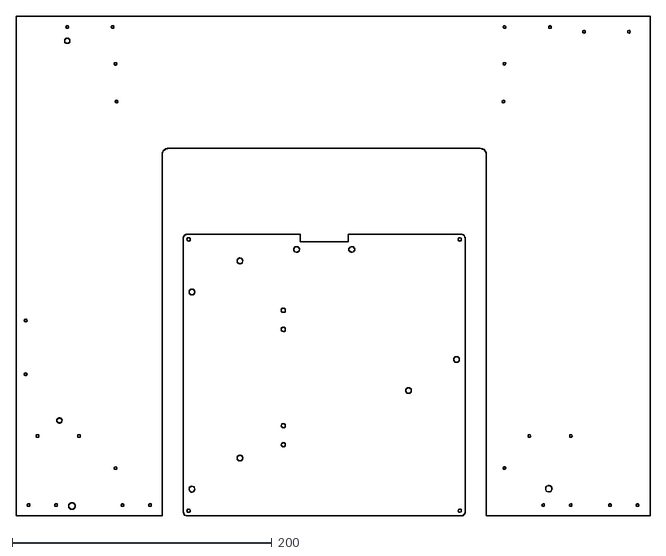
[picture p72: CAD file, 2012-12-09]
sturdy/sheets/frame_gantry_and_y_carriage.dxf
488.5 x 385.0
