zzorn/Mendel90/sturdy/stls/printed/atx_brackets.stl

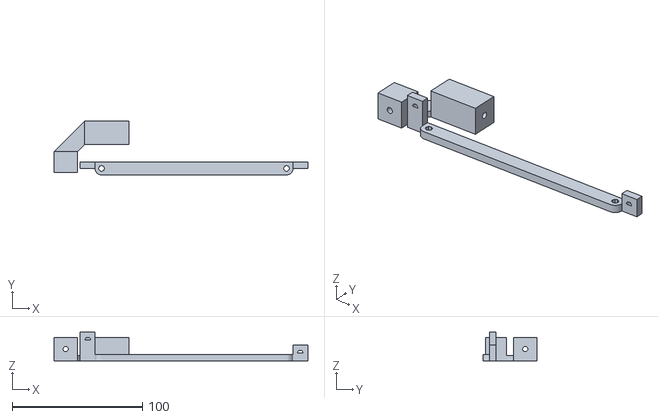
[picture p73: CAD file, 2012-12-09]
sturdy/stls/printed/atx_brackets.stl
195.0 x 41.4 x 22.0
