zzorn/Mendel90/sturdy/stls/x_motor_bracket.stl

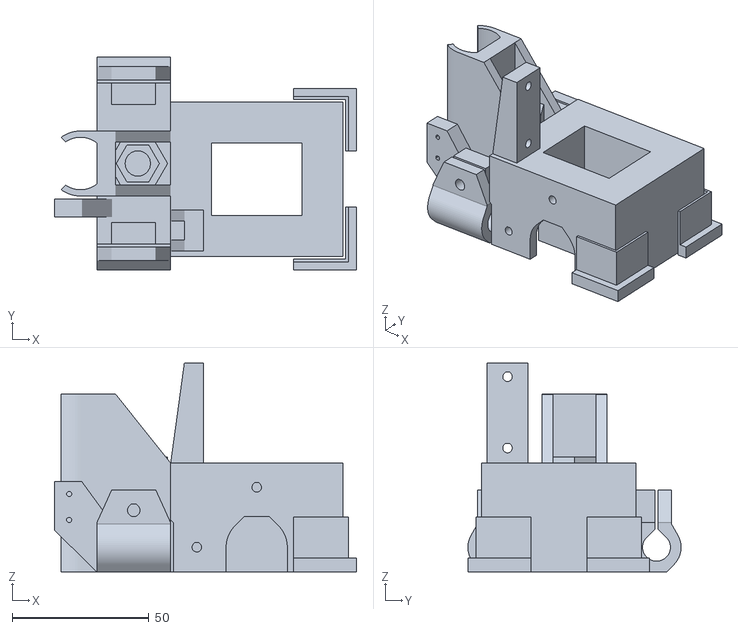
[picture p74: CAD file, 2012-12-09]
sturdy/stls/x_motor_bracket.stl
110.5 x 78.0 x 76.4
