zzorn/Mendel90/dibond/sheets/y_heatshield.dxf

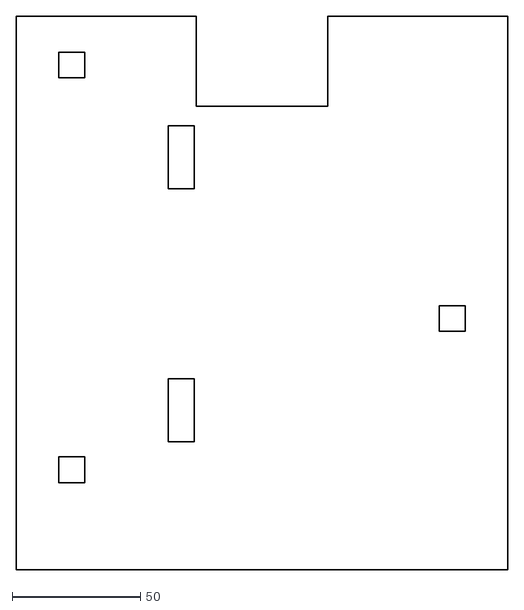
[picture p75: CAD file, 2012-12-09]
dibond/sheets/y_heatshield.dxf
192.0 x 216.0
