zzorn/Mendel90/dibond/stls/printed/d_motor_brackets.stl

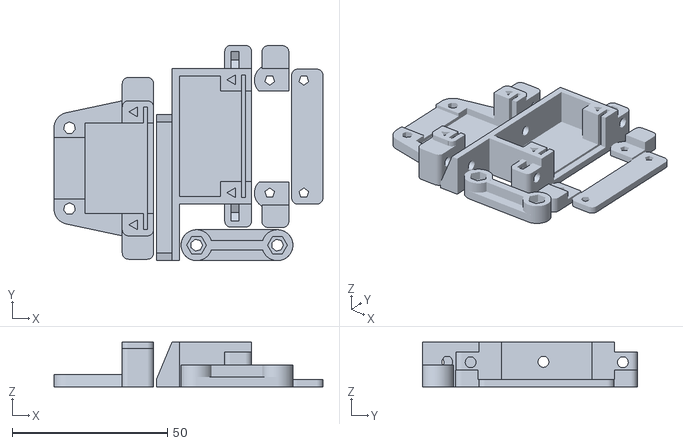
[picture p76: CAD file, 2012-12-09]
dibond/stls/printed/d_motor_brackets.stl
86.7 x 69.4 x 14.4
