zzorn/Mendel90/dibond/stls/spool_bracket_female.stl

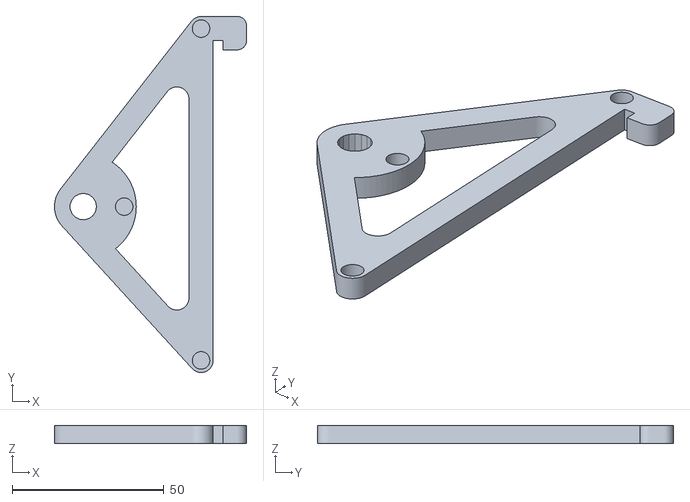
[picture p77: CAD file, 2012-12-09]
dibond/stls/spool_bracket_female.stl
63.4 x 117.5 x 6.00
