zzorn/Mendel90/mendel/sheets/frame_gantry.dxf

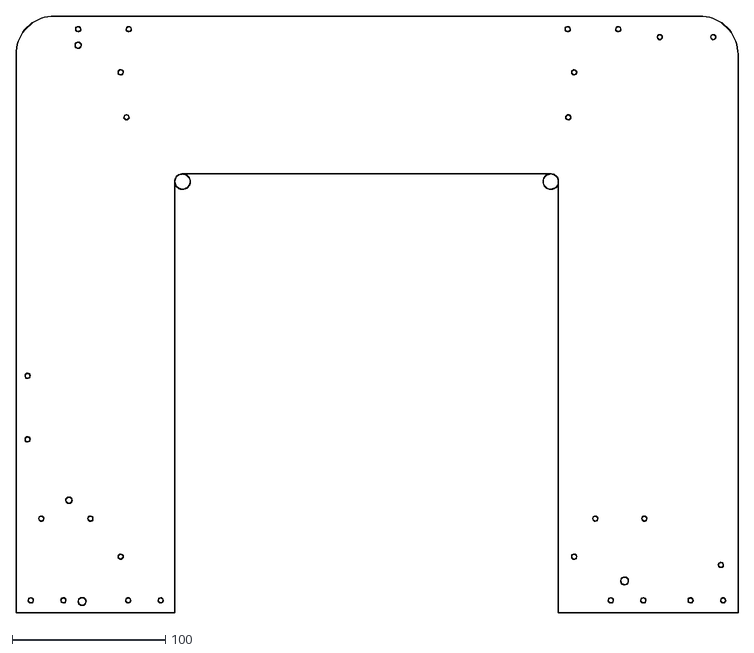
[picture p78: CAD file, 2012-12-09]
mendel/sheets/frame_gantry.dxf
470.5 x 389.0
