zzorn/Mendel90/mendel/stls/d_shell.stl

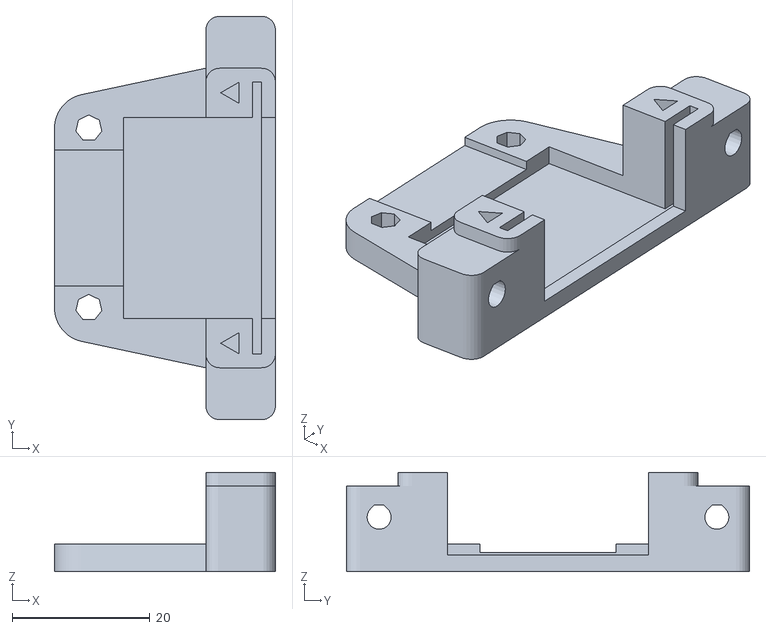
[picture p79: CAD file, 2012-12-09]
mendel/stls/d_shell.stl
32.1 x 58.6 x 14.4
