zzorn/Mendel90/mendel/stls/printed/spool_holder_brackets.stl

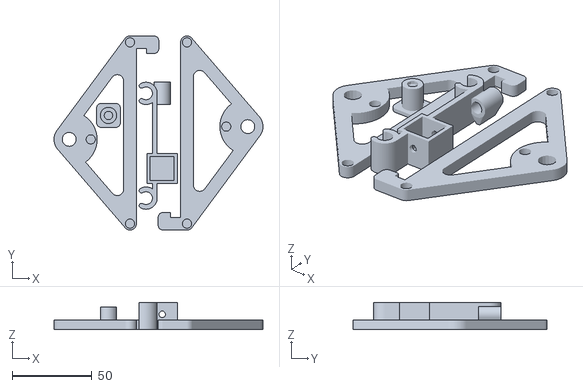
[picture p80: CAD file, 2012-12-09]
mendel/stls/printed/spool_holder_brackets.stl
130.8 x 121.5 x 17.0
