zzorn/Mendel90/sturdy-a4/sheets/y_heatshield.dxf

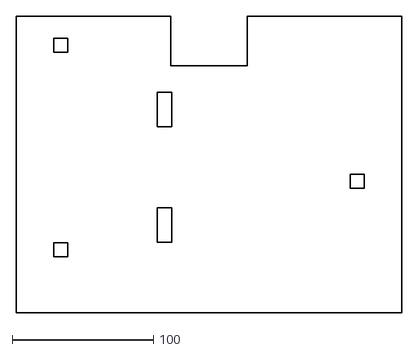
[picture p81: CAD file, 2012-12-09]
sturdy-a4/sheets/y_heatshield.dxf
273.0 x 210.0
