zzorn/Mendel90/sturdy-a4/stls/printed/cal.stl

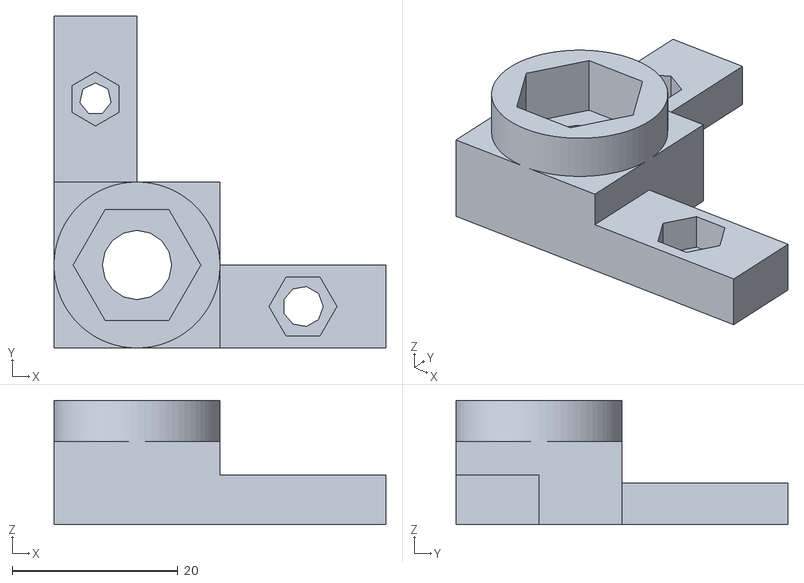
[picture p82: CAD file, 2012-12-09]
sturdy-a4/stls/printed/cal.stl
40.0 x 40.0 x 15.0
