zzorn/Mendel90/sturdy-a4/stls/ribbon_clamp_26_44N.stl

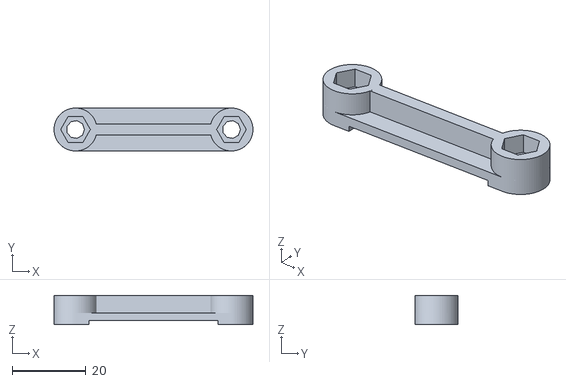
[picture p83: CAD file, 2012-12-09]
sturdy-a4/stls/ribbon_clamp_26_44N.stl
54.1 x 11.7 x 8.01
