zzorn/Mendel90/sturdy/sheets/frame_gantry.dxf

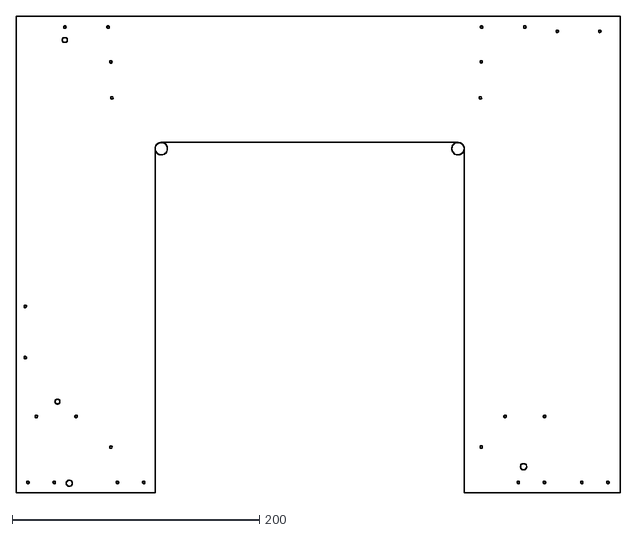
[picture p84: CAD file, 2012-12-09]
sturdy/sheets/frame_gantry.dxf
488.5 x 385.0
