zzorn/Mendel90/sturdy/stls/feed_tube_connector.stl

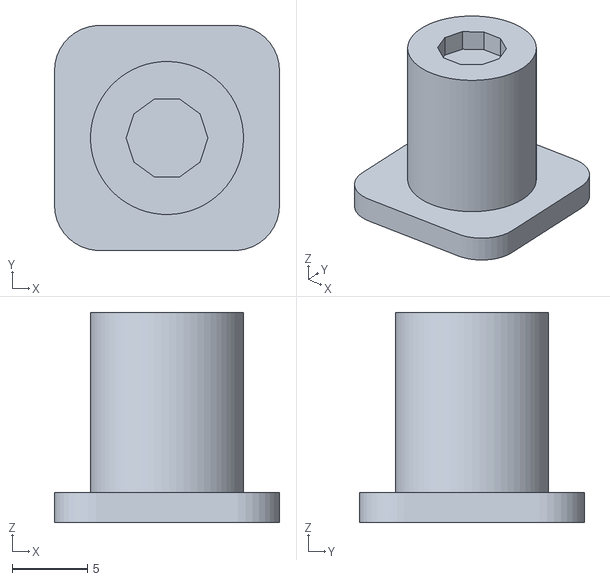
[picture p85: CAD file, 2012-12-09]
sturdy/stls/feed_tube_connector.stl
15.0 x 15.0 x 14.0
