zzorn/Mendel90/dibond/sheets/frame_right.dxf

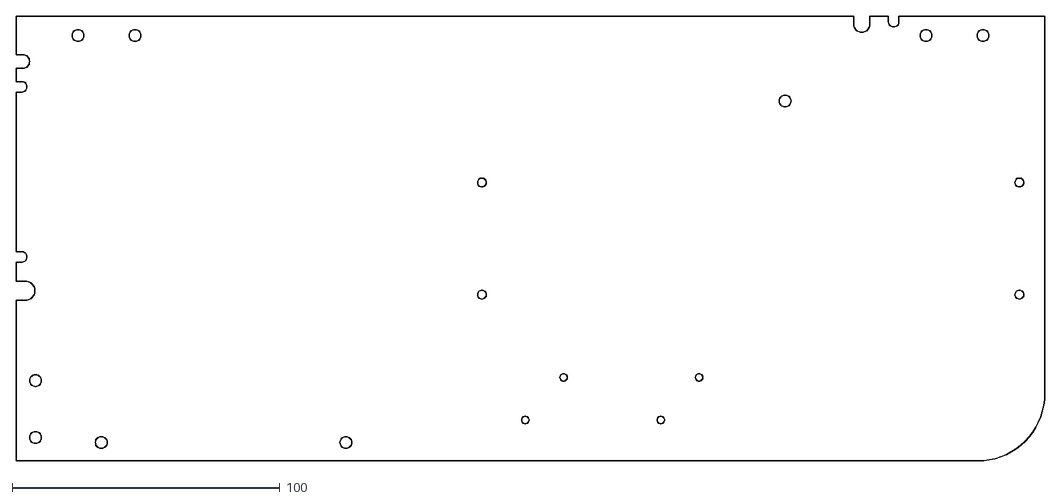
[picture p86: CAD file, 2012-12-09]
dibond/sheets/frame_right.dxf
384.0 x 166.0
