zzorn/Mendel90/dibond/stls/ribbon_clamp_26_33.stl

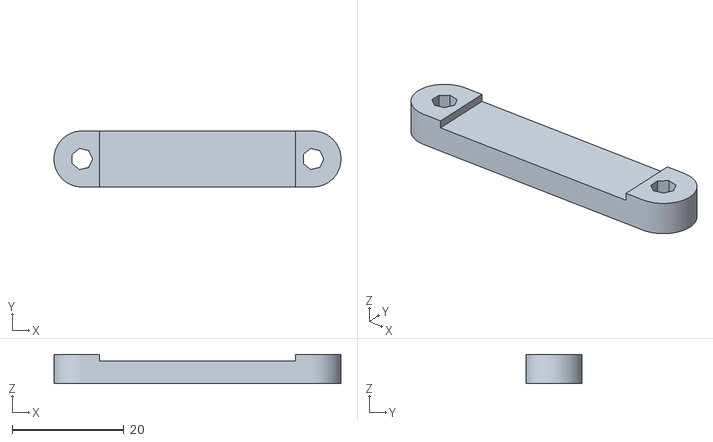
[picture p87: CAD file, 2012-12-09]
dibond/stls/ribbon_clamp_26_33.stl
51.3 x 10.00 x 5.20
