zzorn/Mendel90/mendel/sheets/frame_left.dxf

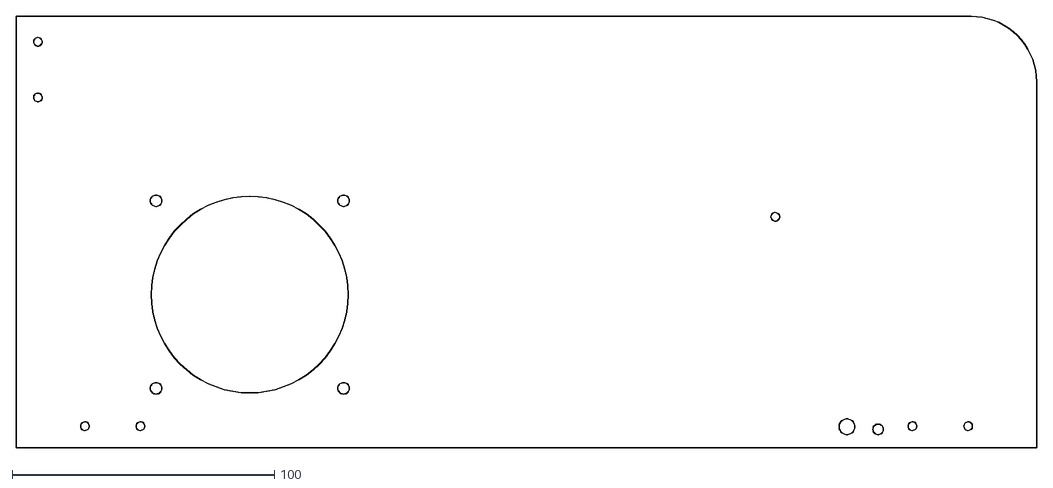
[picture p88: CAD file, 2012-12-09]
mendel/sheets/frame_left.dxf
389.0 x 164.5
