zzorn/Mendel90/mendel/stls/printed/z_motor_brackets.stl

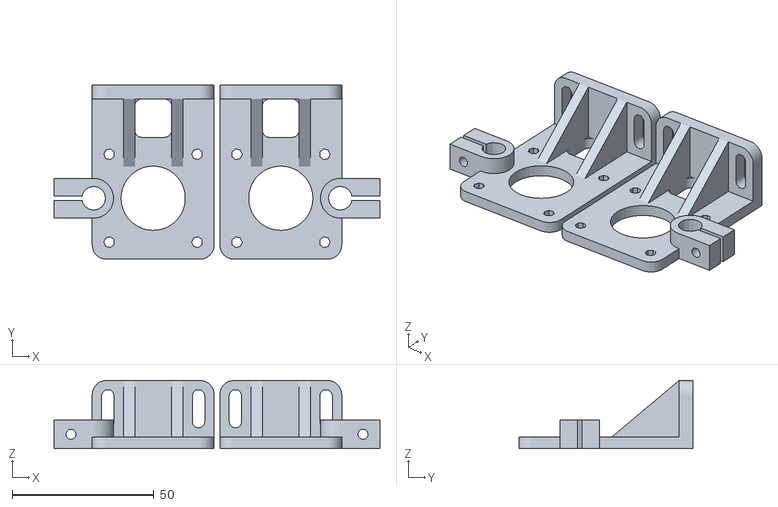
[picture p89: CAD file, 2012-12-09]
mendel/stls/printed/z_motor_brackets.stl
115.0 x 61.5 x 24.0
