zzorn/Mendel90/sturdy-a4/sheets/frame_stays.dxf

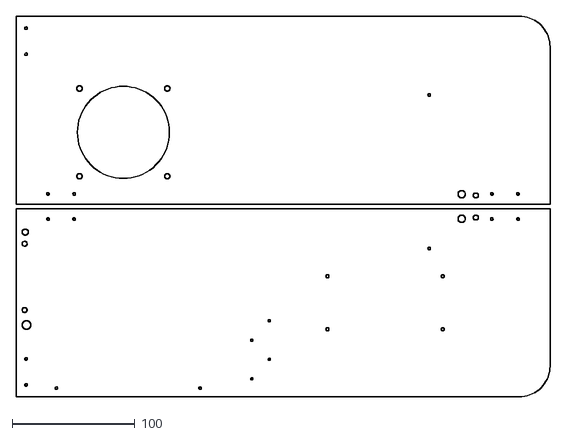
[picture p91: CAD file, 2012-12-09]
sturdy-a4/sheets/frame_stays.dxf
435.0 x 310.0
