zzorn/Mendel90/sturdy-a4/stls/printed/wades_extruder.stl

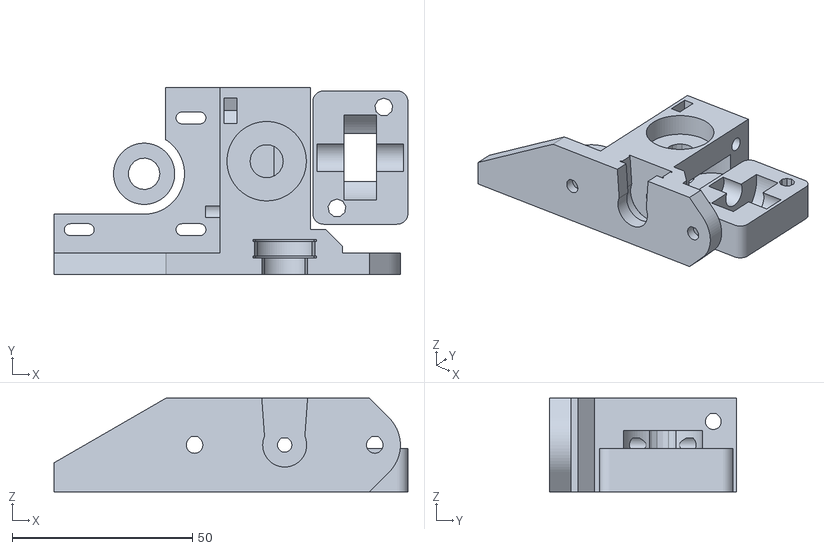
[picture p92: CAD file, 2012-12-09]
sturdy-a4/stls/printed/wades_extruder.stl
98.2 x 52.0 x 26.0
