zzorn/Mendel90/sturdy/sheets/frame_base.dxf

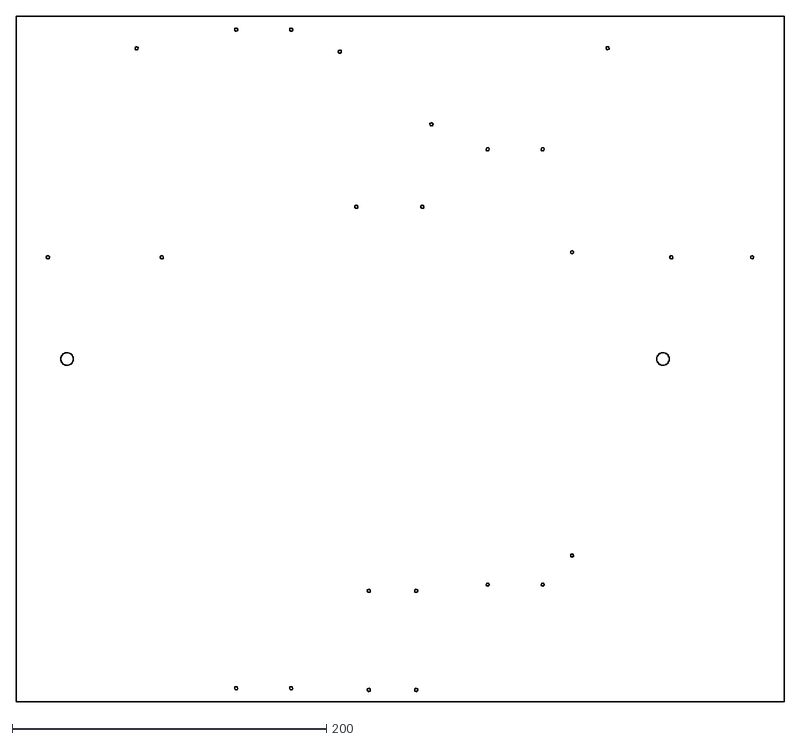
[picture p93: CAD file, 2012-12-09]
sturdy/sheets/frame_base.dxf
488.5 x 436.0
