zzorn/Mendel90/sturdy/stls/printed/jhead_insertion_jig.stl

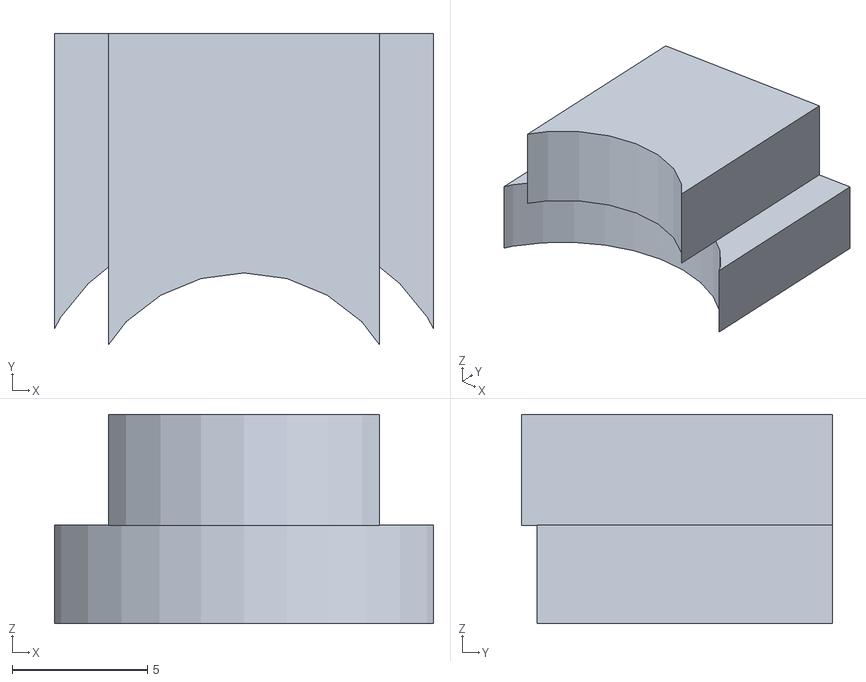
[picture p94: CAD file, 2012-12-09]
sturdy/stls/printed/jhead_insertion_jig.stl
14.0 x 11.5 x 7.73
