zzorn/Mendel90/sturdy/stls/x_belt_grip.stl

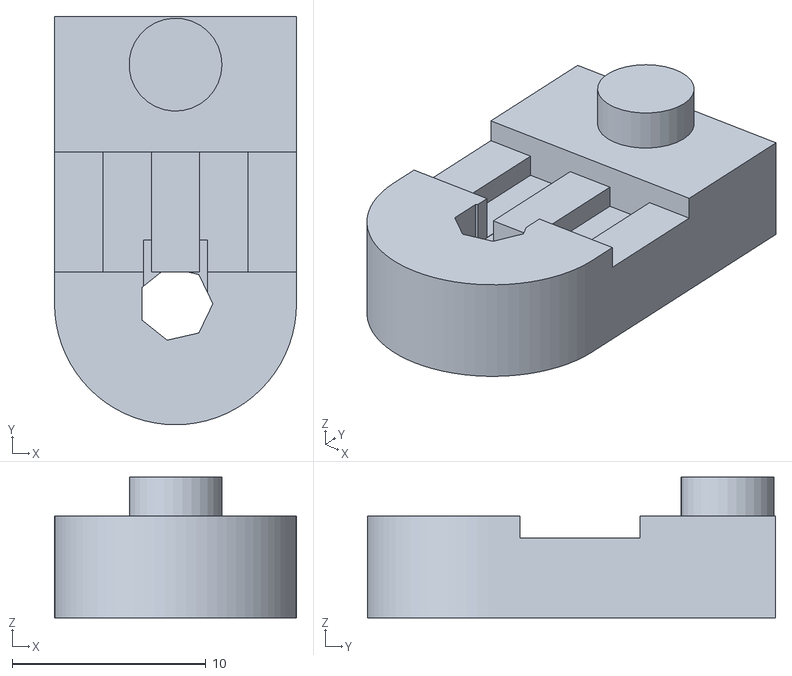
[picture p95: CAD file, 2012-12-09]
sturdy/stls/x_belt_grip.stl
12.5 x 21.1 x 7.26
