zzorn/Mendel90/dibond/sheets/frame_gantry_and_y_carriage.dxf

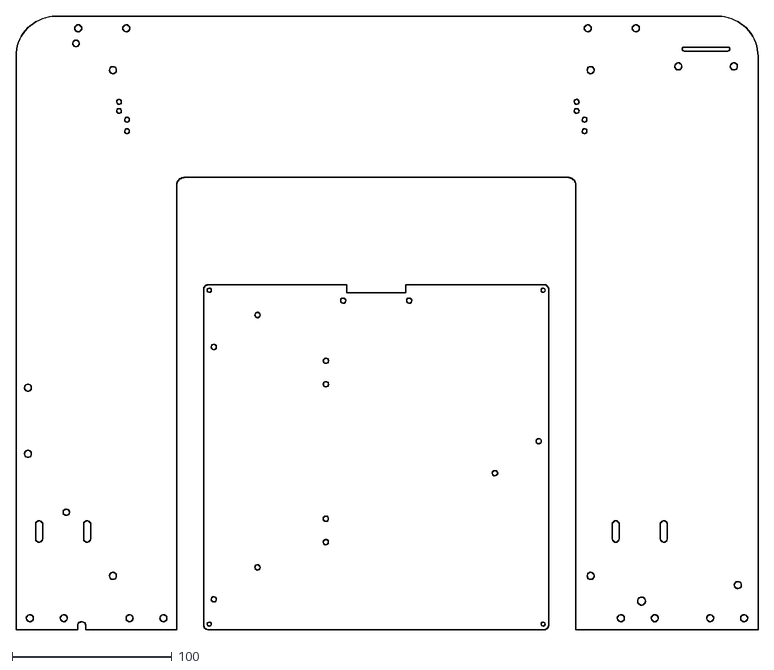
[picture p96: CAD file, 2012-12-09]
dibond/sheets/frame_gantry_and_y_carriage.dxf
464.5 x 384.0
