zzorn/Mendel90/dibond/stls/printed/atx_brackets.stl

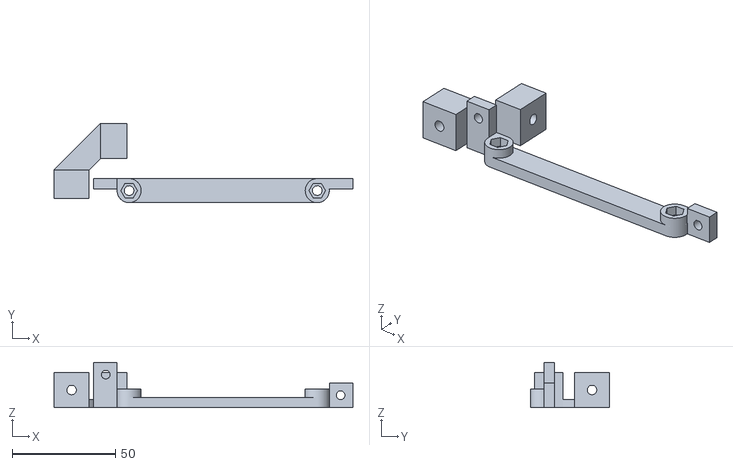
[picture p97: CAD file, 2012-12-09]
dibond/stls/printed/atx_brackets.stl
145.1 x 38.5 x 22.0
