zzorn/Mendel90/dibond/stls/y_bearing_mount.stl

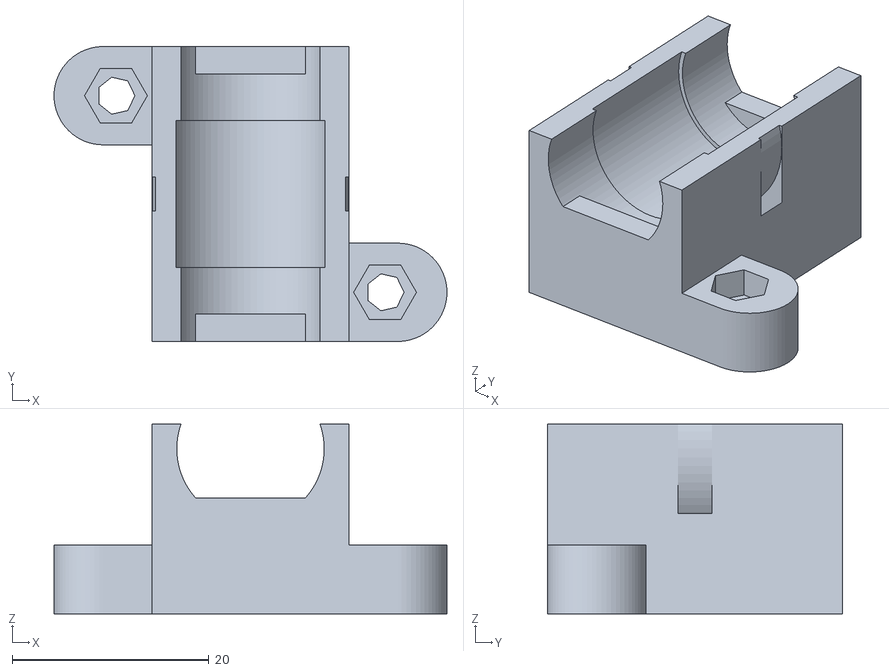
[picture p98: CAD file, 2012-12-09]
dibond/stls/y_bearing_mount.stl
40.0 x 30.0 x 19.3
