zzorn/Mendel90/mendel/sheets/y_heatshield.dxf

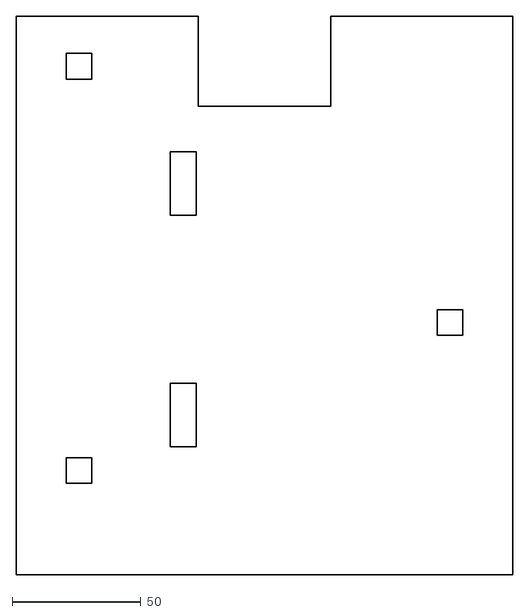
[picture p99: CAD file, 2012-12-09]
mendel/sheets/y_heatshield.dxf
193.0 x 217.0
