zzorn/Mendel90/mendel/stls/printed/x_idler_bracket.stl

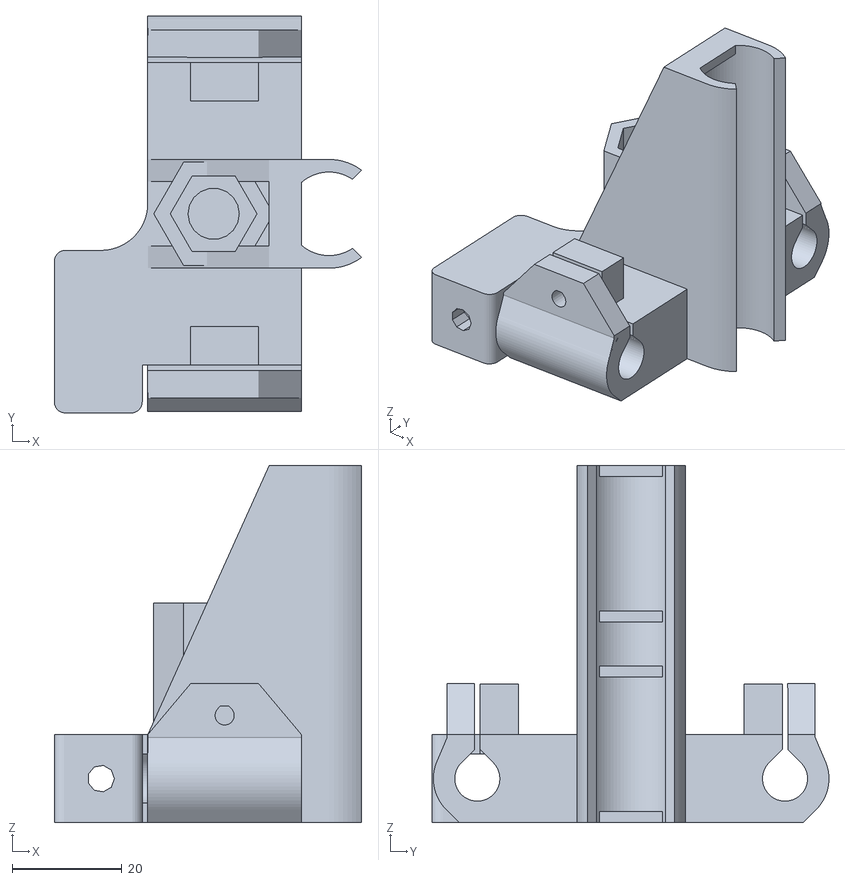
[picture p100: CAD file, 2012-12-09]
mendel/stls/printed/x_idler_bracket.stl
55.9 x 72.2 x 65.0
