zzorn/Mendel90/sturdy-a4/sheets/frame_gantry_and_y_carriage.dxf

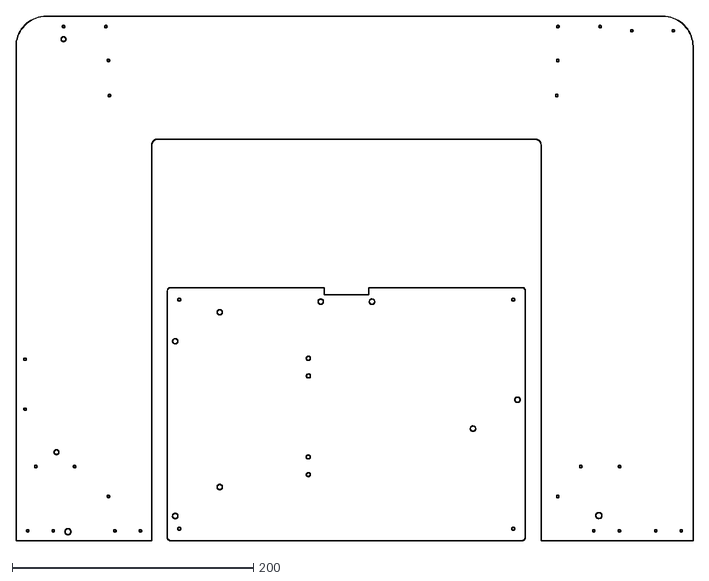
[picture p101: CAD file, 2012-12-09]
sturdy-a4/sheets/frame_gantry_and_y_carriage.dxf
561.5 x 435.0
