zzorn/Mendel90/sturdy-a4/stls/printed/y_bearing_mounts.stl

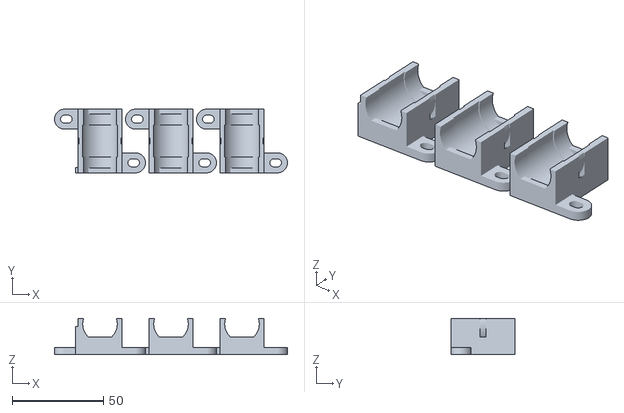
[picture p102: CAD file, 2012-12-09]
sturdy-a4/stls/printed/y_bearing_mounts.stl
128.0 x 35.0 x 20.0
