zzorn/Mendel90/sturdy-a4/stls/y_bar_clamp.stl

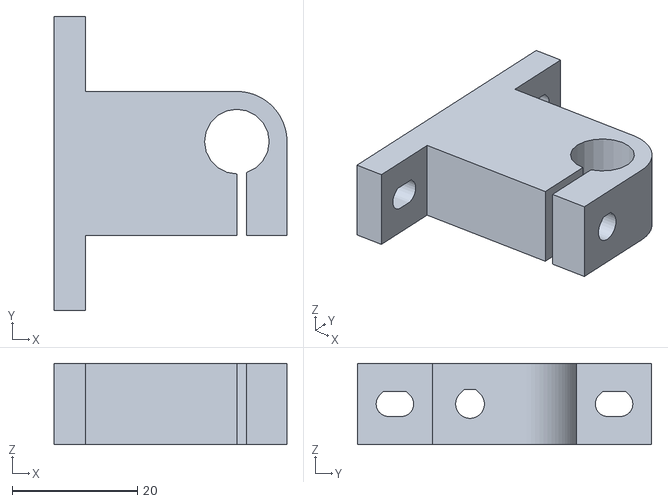
[picture p103: CAD file, 2012-12-09]
sturdy-a4/stls/y_bar_clamp.stl
37.2 x 47.0 x 13.0
