zzorn/Mendel90/sturdy/sheets/y_heatshield.dxf

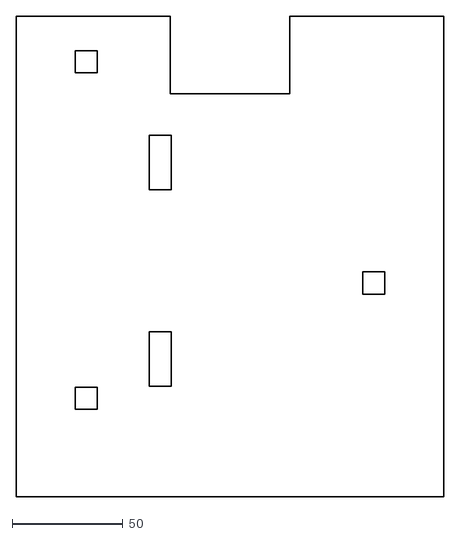
[picture p104: CAD file, 2012-12-09]
sturdy/sheets/y_heatshield.dxf
193.0 x 217.0
