zzorn/Mendel90/sturdy/stls/printed/pcb_spacer.stl

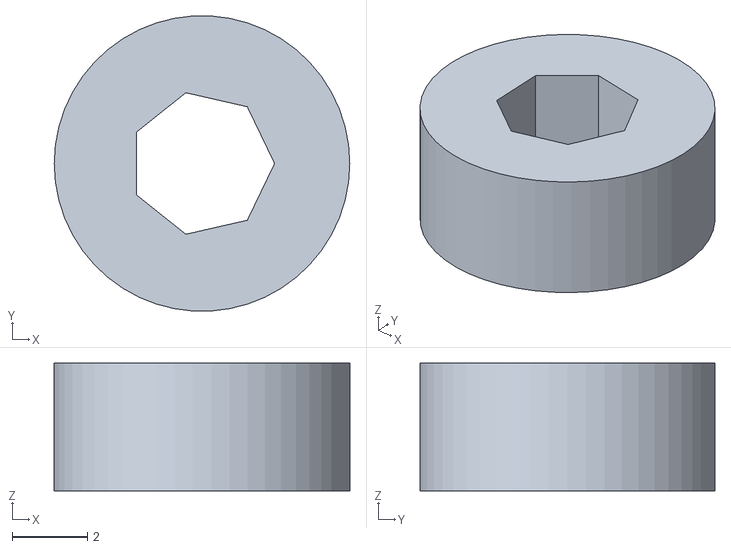
[picture p105: CAD file, 2012-12-09]
sturdy/stls/printed/pcb_spacer.stl
7.86 x 7.85 x 3.40
