zzorn/Mendel90/sturdy/stls/pulley.stl

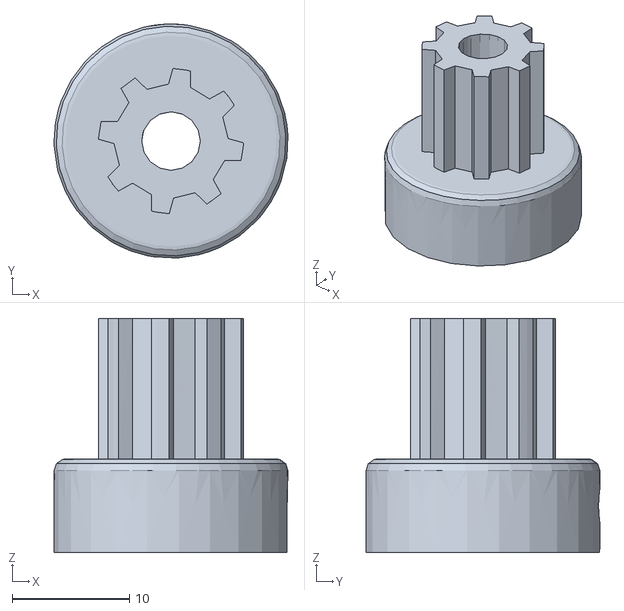
[picture p106: CAD file, 2012-12-09]
sturdy/stls/pulley.stl
20.0 x 20.0 x 20.0
