zzorn/Mendel90/dibond/sheets/frame_stays.dxf

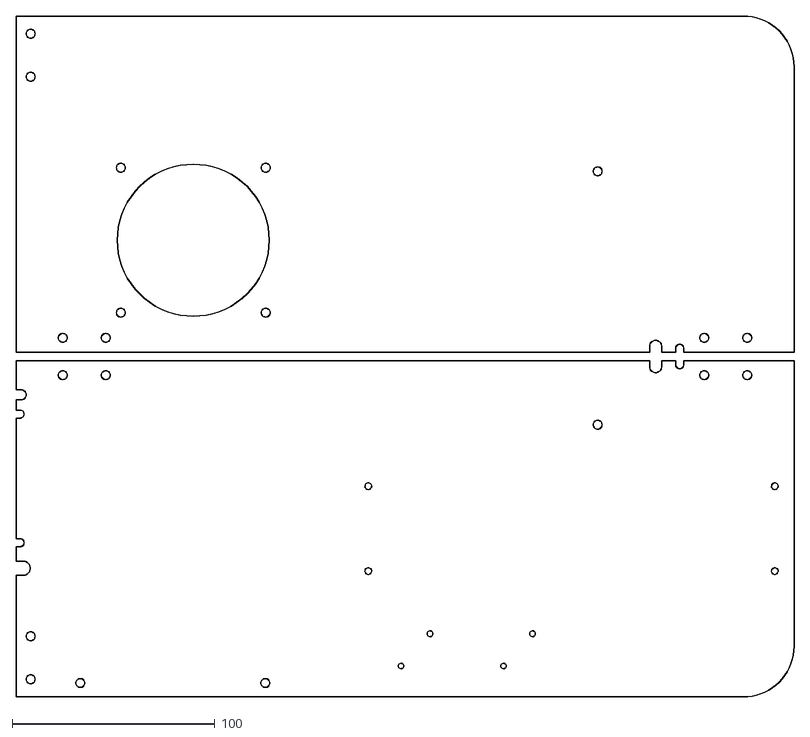
[picture p107: CAD file, 2012-12-09]
dibond/sheets/frame_stays.dxf
384.0 x 336.0
