zzorn/Mendel90/dibond/stls/printed/ribbon_clamps.stl

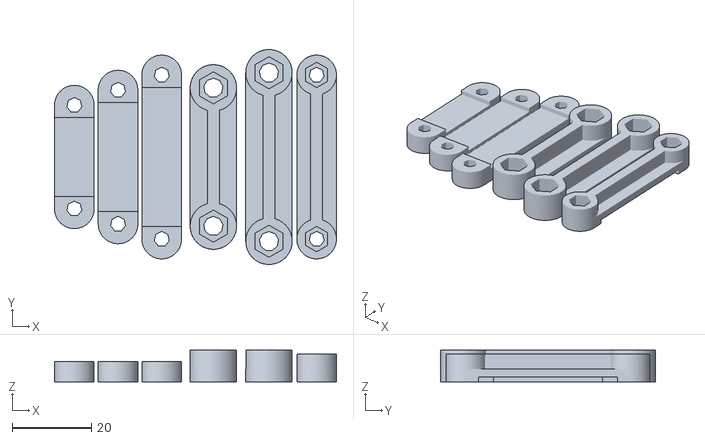
[picture p108: CAD file, 2012-12-09]
dibond/stls/printed/ribbon_clamps.stl
71.0 x 54.1 x 8.01
