zzorn/Mendel90/dibond/stls/spool_bracket_male.stl

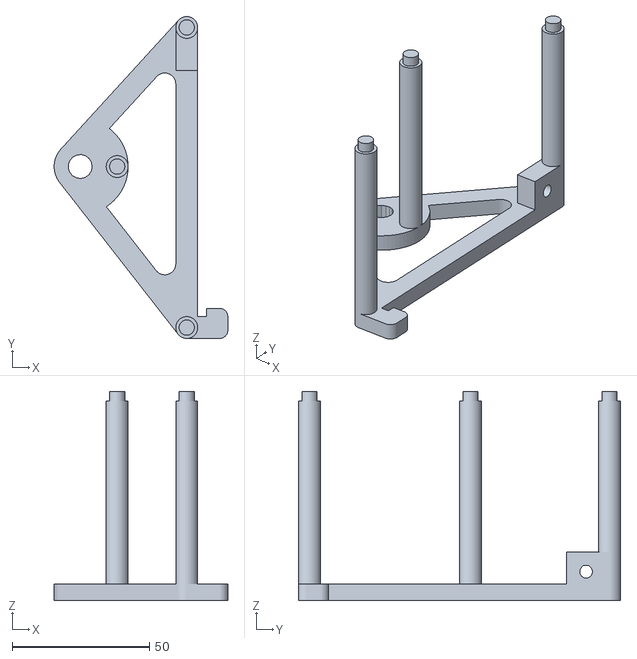
[picture p109: CAD file, 2012-12-09]
dibond/stls/spool_bracket_male.stl
63.4 x 117.5 x 76.4
