zzorn/Mendel90/mendel/sheets/frame_stays.dxf

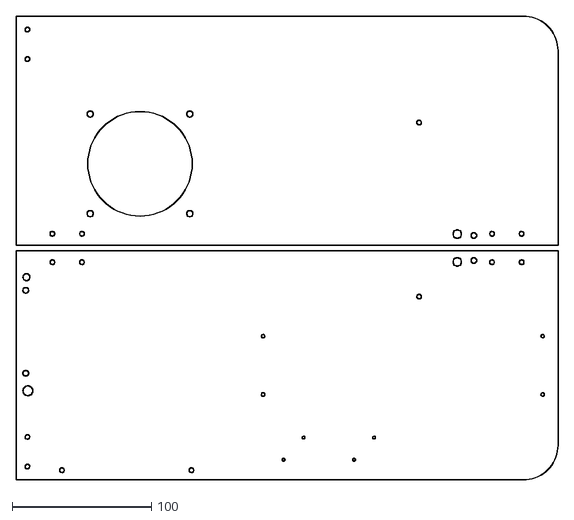
[picture p110: CAD file, 2012-12-09]
mendel/sheets/frame_stays.dxf
389.0 x 333.0
