zzorn/Mendel90/mendel/stls/atx_short_bracket.stl

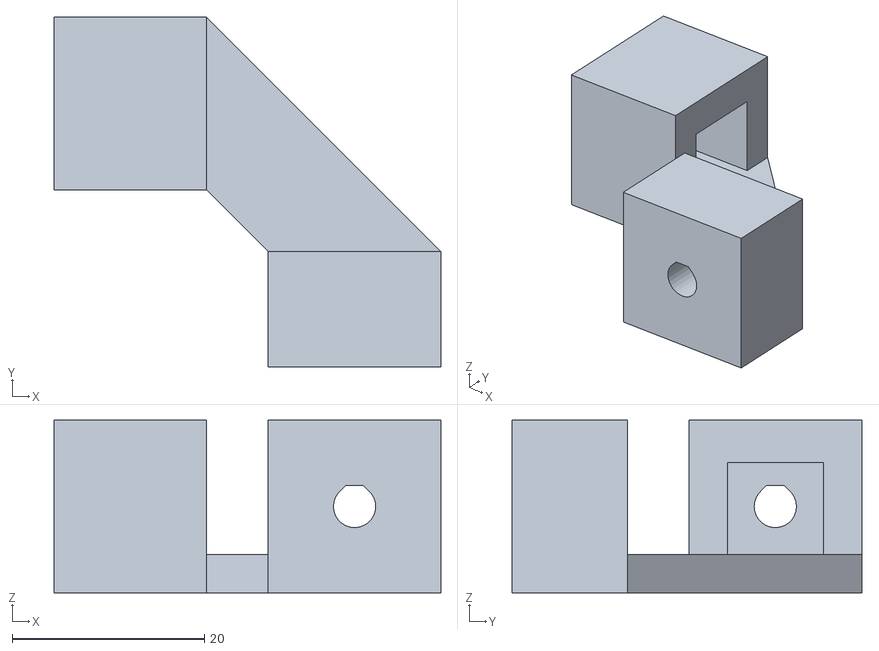
[picture p111: CAD file, 2012-12-09]
mendel/stls/atx_short_bracket.stl
40.3 x 36.4 x 18.0
