zzorn/Mendel90/mendel/stls/printed/y_idler_bracket.stl

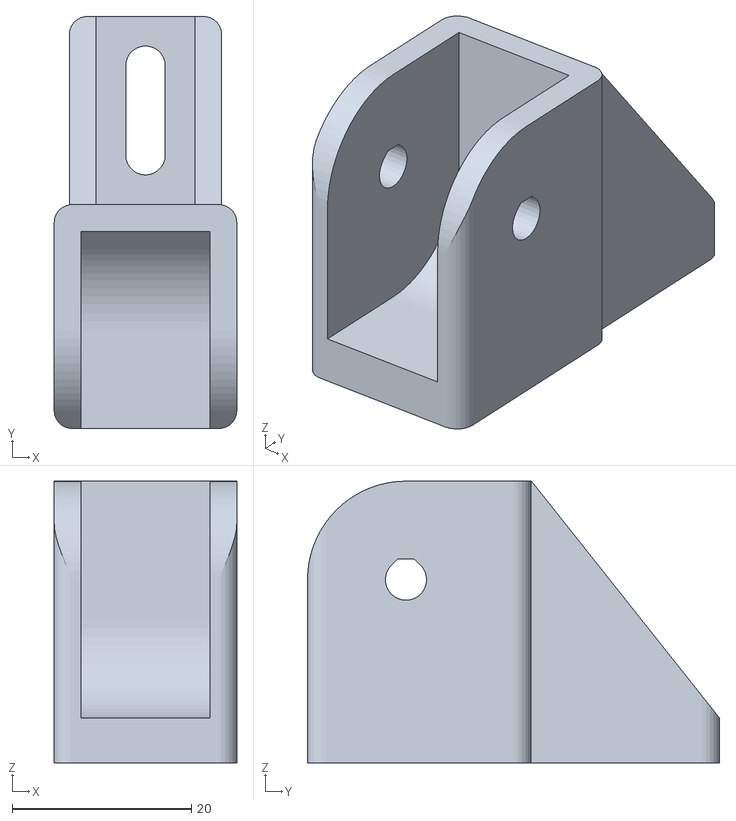
[picture p112: CAD file, 2012-12-09]
mendel/stls/printed/y_idler_bracket.stl
20.4 x 46.0 x 31.4
