zzorn/Mendel90/sturdy-a4/sheets/frame_gantry.dxf

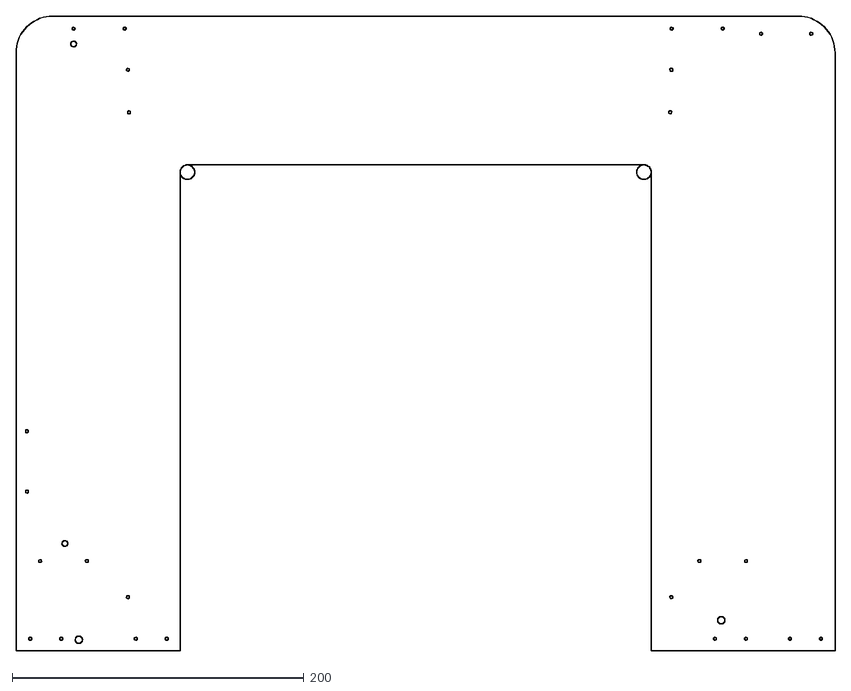
[picture p113: CAD file, 2012-12-09]
sturdy-a4/sheets/frame_gantry.dxf
561.5 x 435.0
