zzorn/Mendel90/sturdy-a4/stls/z_motor_bracket_rhs.stl

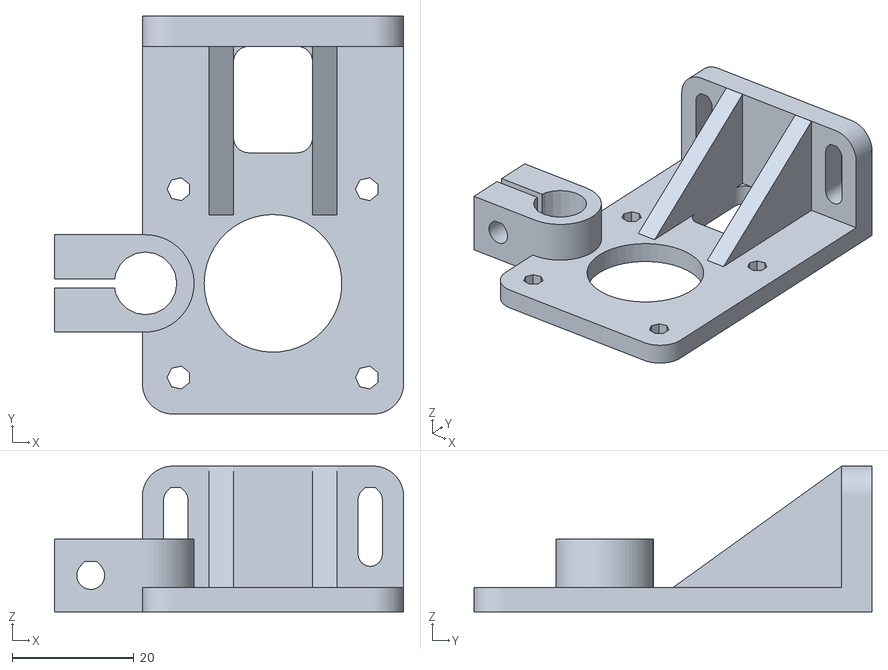
[picture p114: CAD file, 2012-12-09]
sturdy-a4/stls/z_motor_bracket_rhs.stl
57.5 x 65.5 x 24.0
