zzorn/Mendel90/sturdy/sheets/y_carriage.dxf

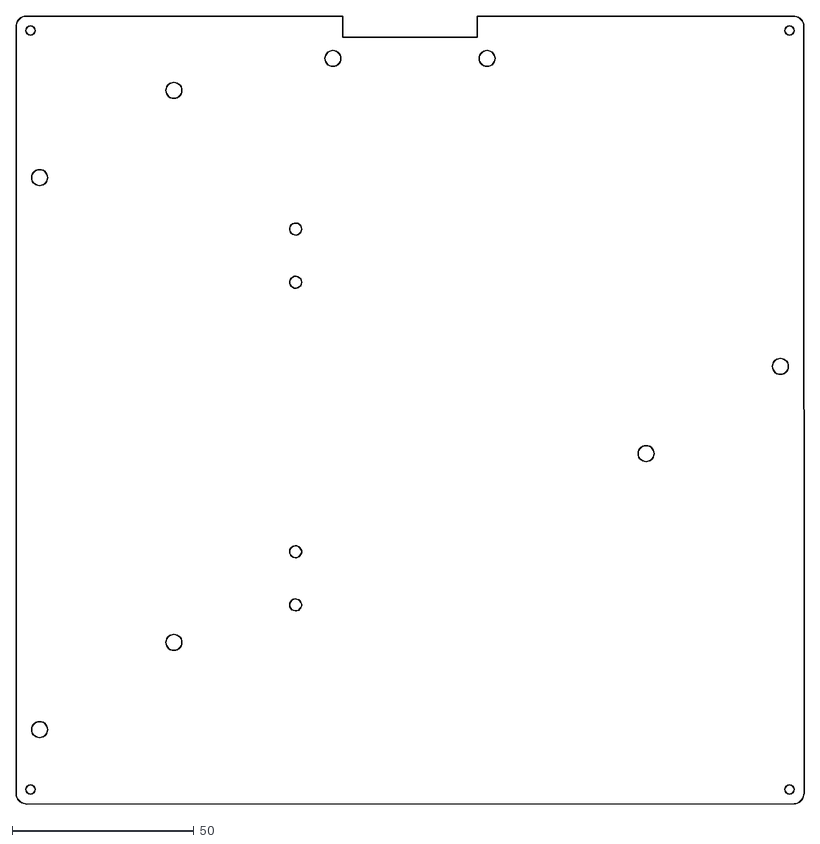
[picture p115: CAD file, 2012-12-09]
sturdy/sheets/y_carriage.dxf
217.0 x 217.0
