zzorn/Mendel90/sturdy/stls/printed/x_carriage_fan_duct.stl

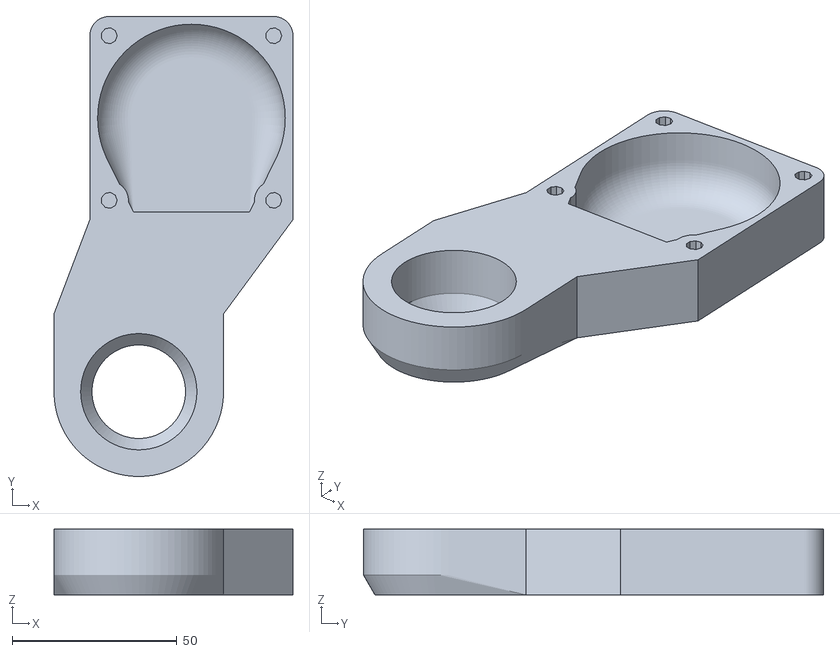
[picture p116: CAD file, 2012-12-09]
sturdy/stls/printed/x_carriage_fan_duct.stl
72.6 x 139.7 x 20.0
