zzorn/Mendel90/dibond/sheets/frame_left.dxf

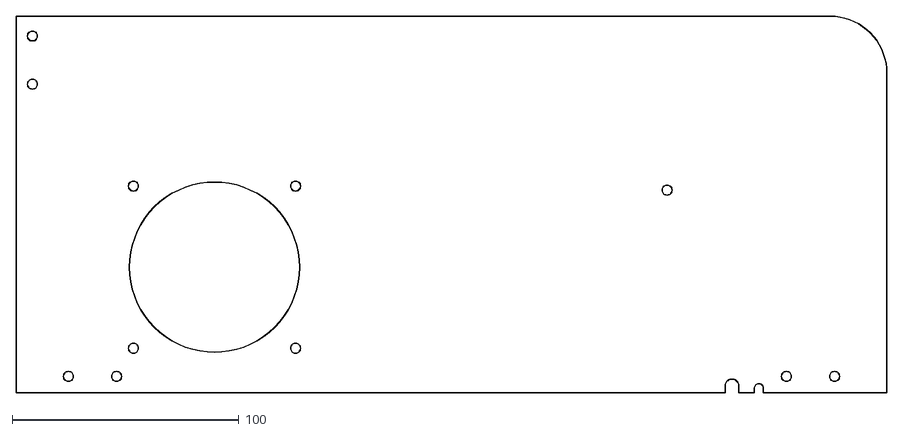
[picture p118: CAD file, 2012-12-09]
dibond/sheets/frame_left.dxf
384.0 x 166.0
