zzorn/Mendel90/dibond/stls/printed/x_carriage_fan_duct.stl

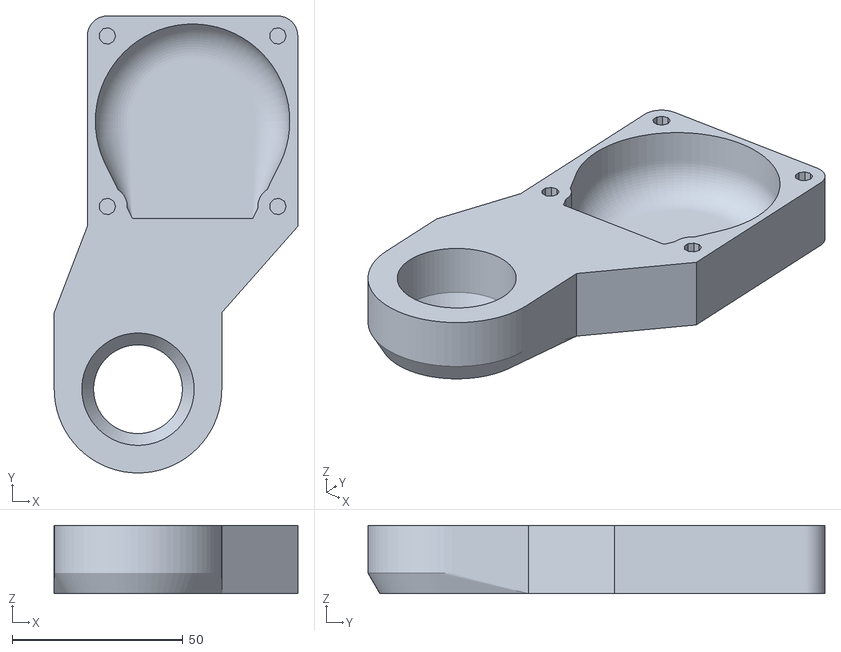
[picture p119: CAD file, 2012-12-09]
dibond/stls/printed/x_carriage_fan_duct.stl
71.4 x 134.0 x 20.0
