zzorn/Mendel90/dibond/stls/z_motor_bracket_rhs.stl

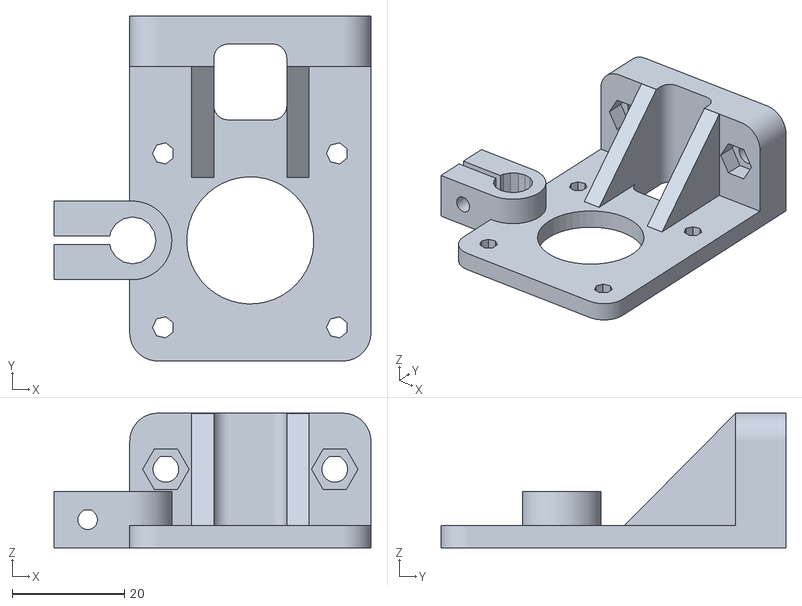
[picture p120: CAD file, 2012-12-09]
dibond/stls/z_motor_bracket_rhs.stl
56.5 x 61.5 x 24.0
