zzorn/Mendel90/mendel/sheets/frame_right.dxf

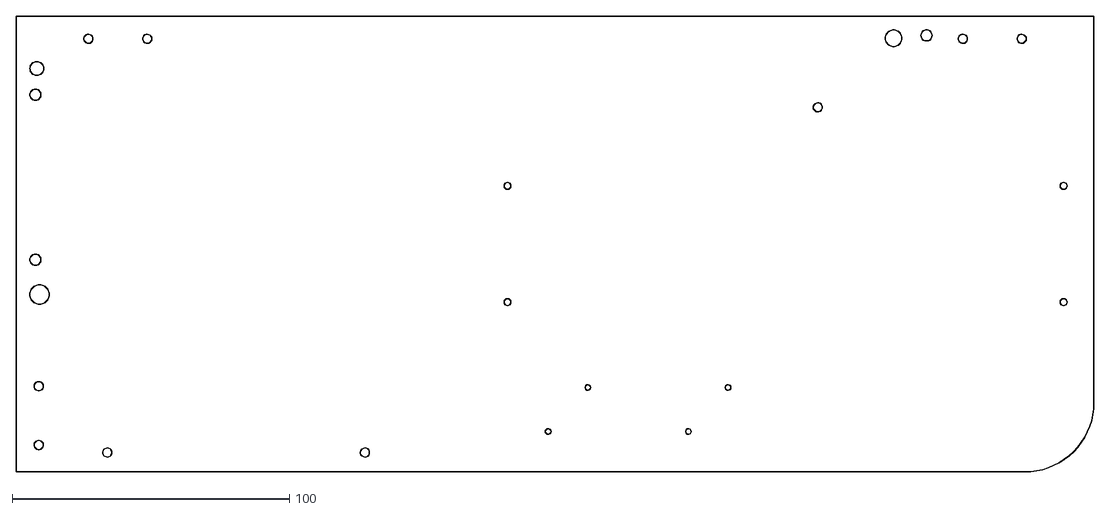
[picture p121: CAD file, 2012-12-09]
mendel/sheets/frame_right.dxf
389.0 x 164.5
