zzorn/Mendel90/mendel/stls/printed/fixing_blocks.stl

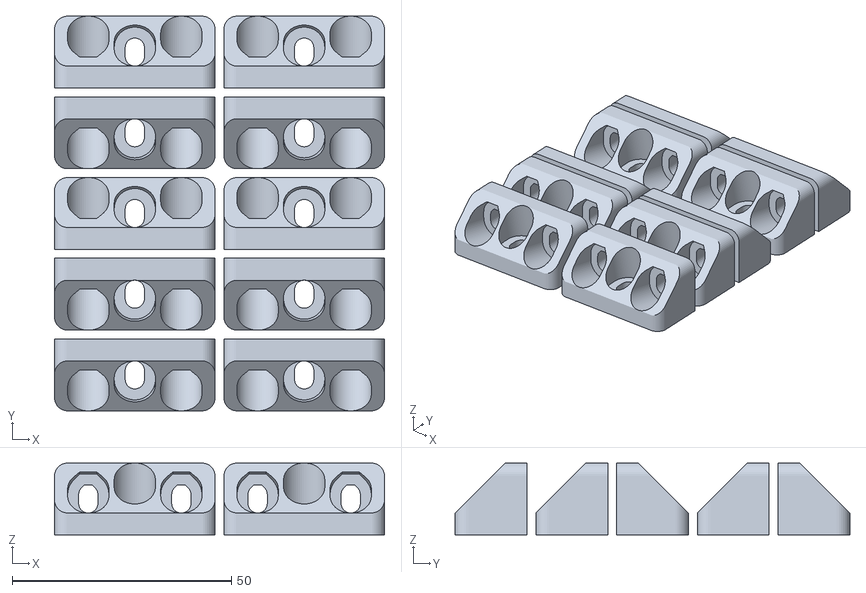
[picture p122: CAD file, 2012-12-09]
mendel/stls/printed/fixing_blocks.stl
75.2 x 90.0 x 16.4
