zzorn/Mendel90/mendel/stls/y_belt_anchor.stl

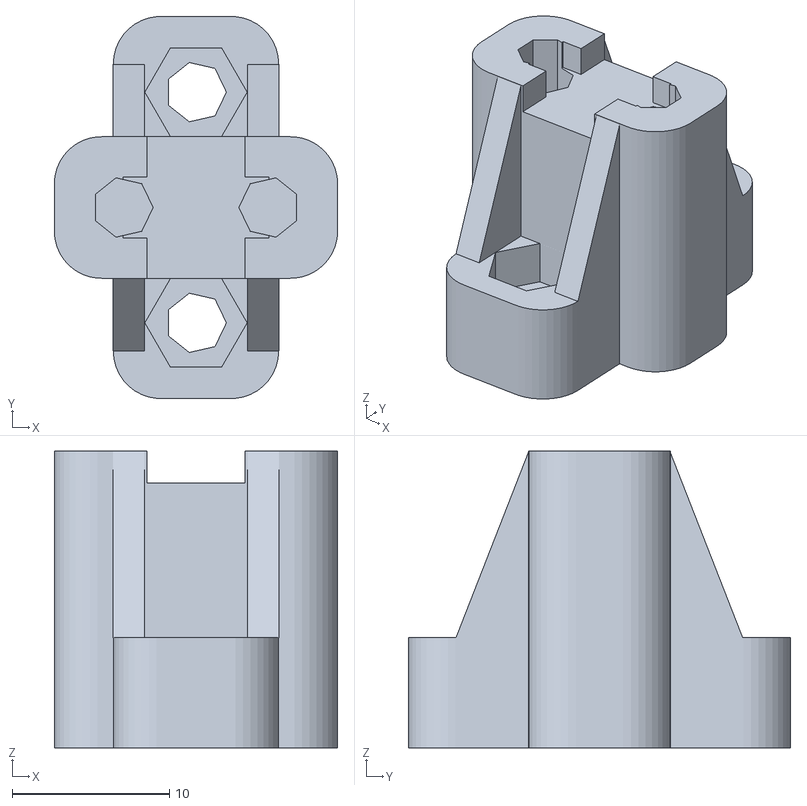
[picture p123: CAD file, 2012-12-09]
mendel/stls/y_belt_anchor.stl
18.0 x 24.3 x 18.9
