zzorn/Mendel90/sturdy-a4/sheets/frame_right.dxf

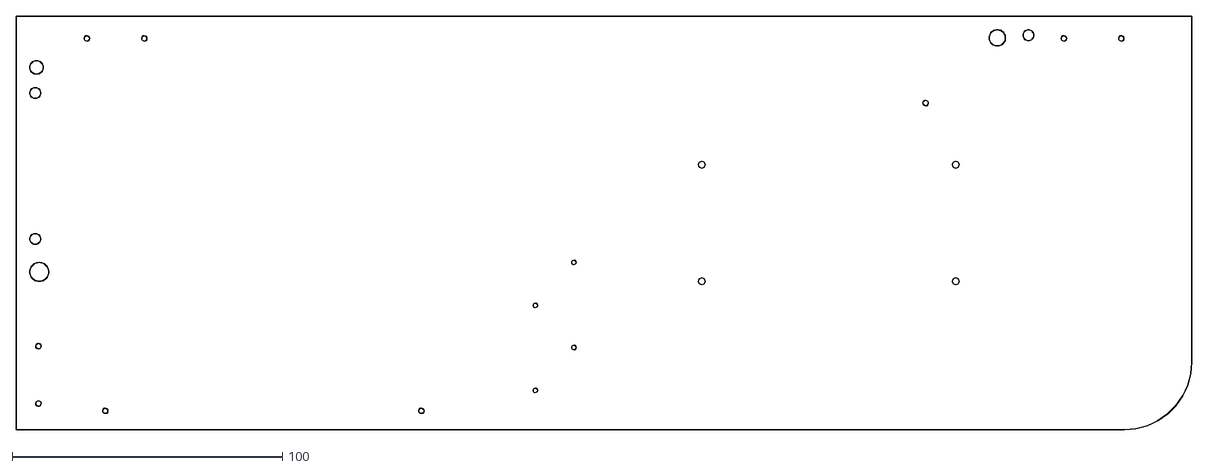
[picture p124: CAD file, 2012-12-09]
sturdy-a4/sheets/frame_right.dxf
435.0 x 153.0
