zzorn/Mendel90/sturdy/sheets/frame_left.dxf

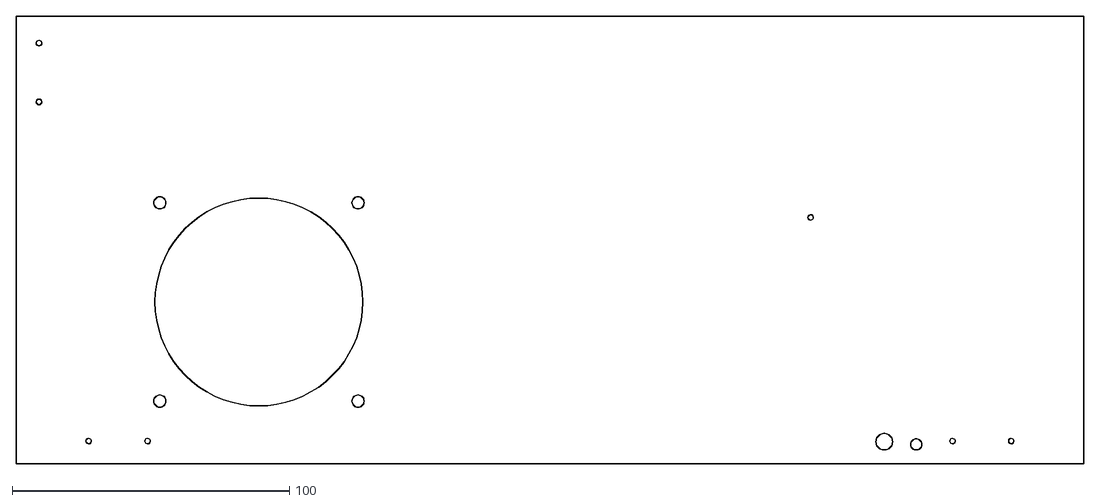
[picture p125: CAD file, 2012-12-09]
sturdy/sheets/frame_left.dxf
385.0 x 161.5
