zzorn/Mendel90/dibond/sheets/frame_gantry.dxf

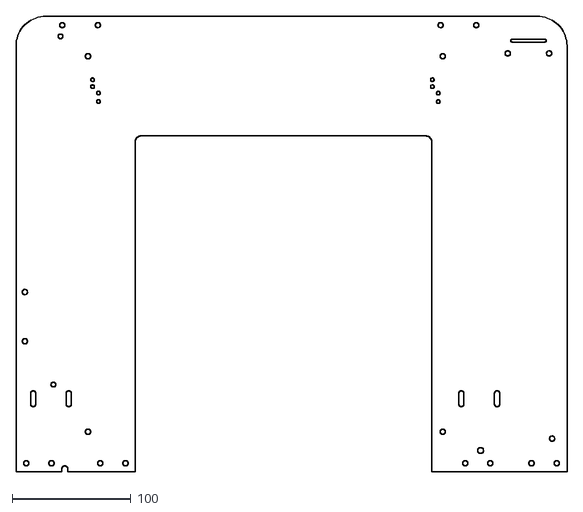
[picture p126: CAD file, 2012-12-09]
dibond/sheets/frame_gantry.dxf
464.5 x 384.0
