zzorn/Mendel90/dibond/stls/printed/tube_cap.stl

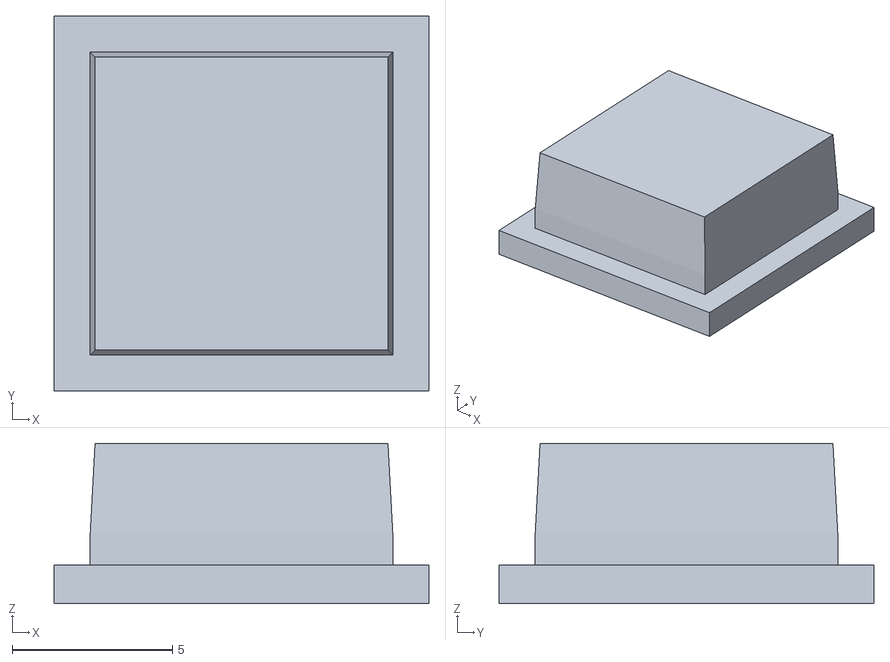
[picture p127: CAD file, 2012-12-09]
dibond/stls/printed/tube_cap.stl
11.7 x 11.7 x 5.00
