zzorn/Mendel90/dibond/stls/x_idler_bracket.stl

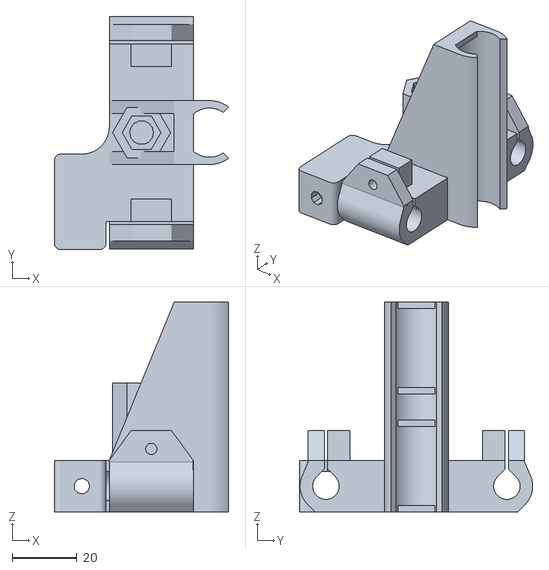
[picture p128: CAD file, 2012-12-09]
dibond/stls/x_idler_bracket.stl
53.9 x 72.2 x 65.0
