zzorn/Mendel90/mendel/sheets/frame_gantry_and_y_carriage.dxf

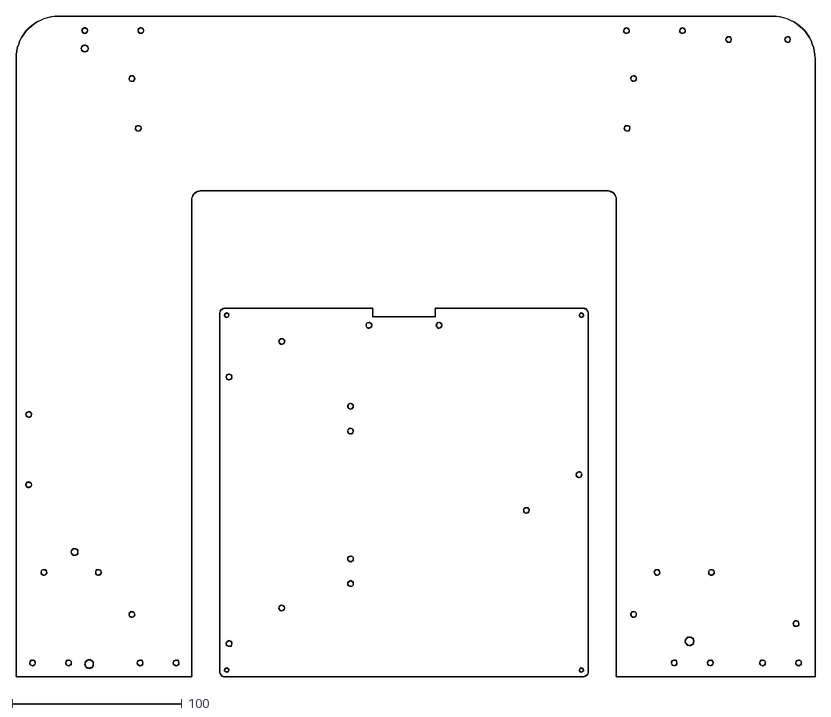
[picture p129: CAD file, 2012-12-09]
mendel/sheets/frame_gantry_and_y_carriage.dxf
470.5 x 389.0
