zzorn/Mendel90/mendel/stls/printed/fan_guard.stl

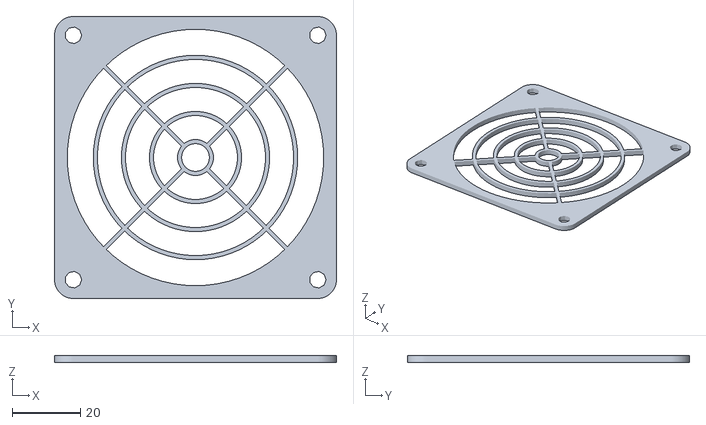
[picture p130: CAD file, 2012-12-09]
mendel/stls/printed/fan_guard.stl
82.5 x 82.5 x 2.00
