zzorn/Mendel90/sturdy-a4/sheets/frame_left.dxf

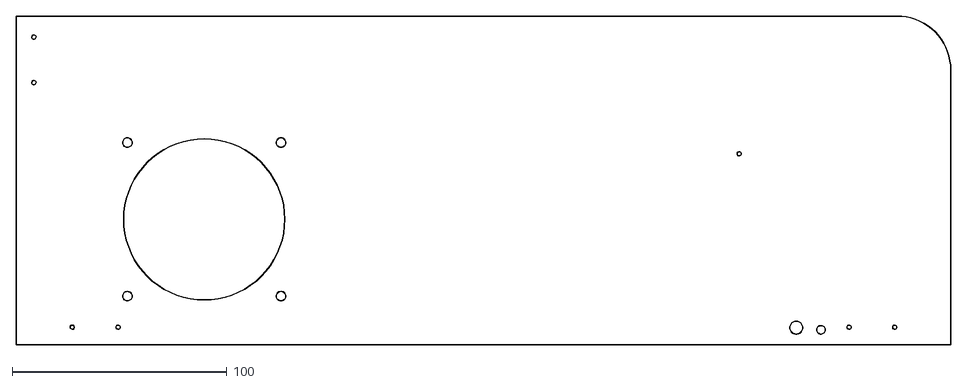
[picture p131: CAD file, 2012-12-09]
sturdy-a4/sheets/frame_left.dxf
435.0 x 153.0
