zzorn/Mendel90/sturdy-a4/stls/printed/x_idler_bracket.stl

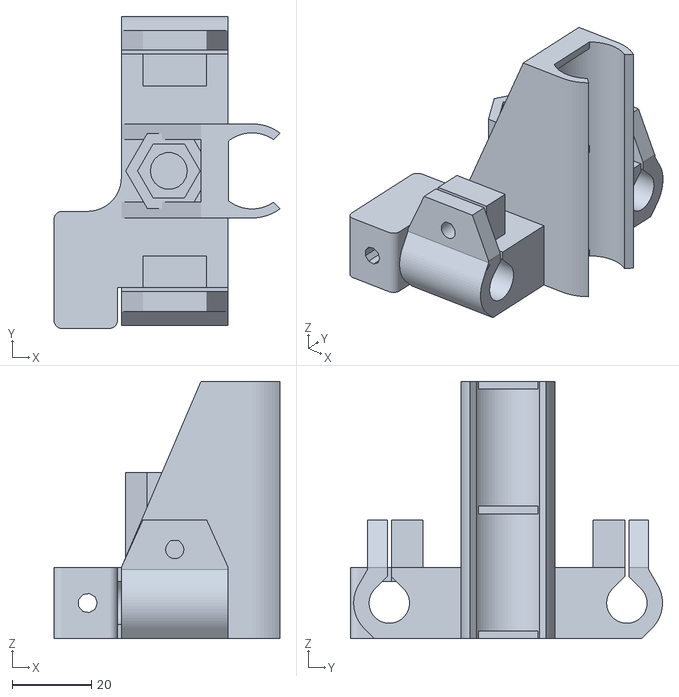
[picture p132: CAD file, 2012-12-09]
sturdy-a4/stls/printed/x_idler_bracket.stl
57.1 x 78.8 x 65.0
