zzorn/Mendel90/sturdy/sheets/frame_right.dxf

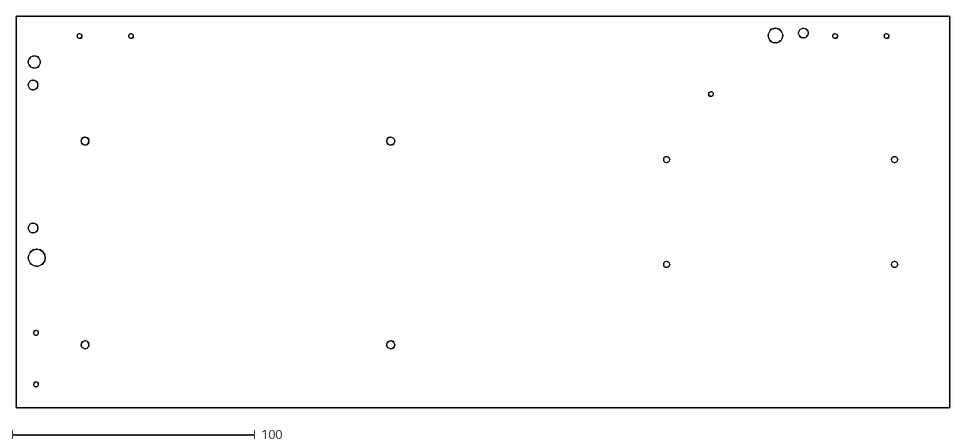
[picture p133: CAD file, 2012-12-09]
sturdy/sheets/frame_right.dxf
385.0 x 161.5
