zzorn/Mendel90/sturdy/stls/y_idler_bracket.stl

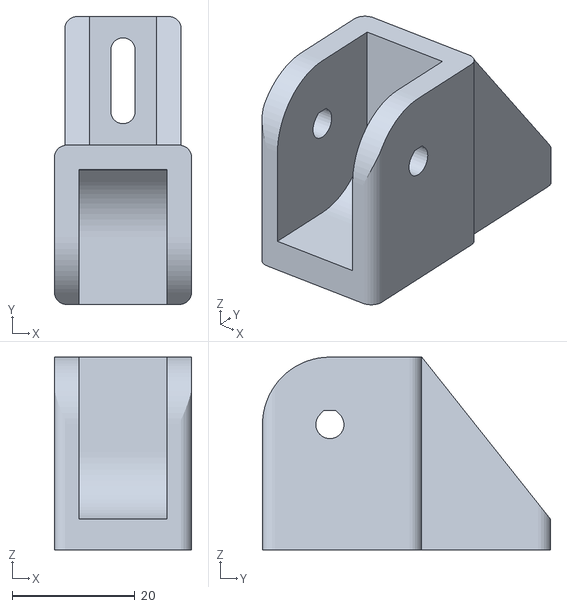
[picture p134: CAD file, 2012-12-09]
sturdy/stls/y_idler_bracket.stl
22.4 x 47.0 x 31.4
