zzorn/Mendel90/dibond/sheets/frame_base.dxf

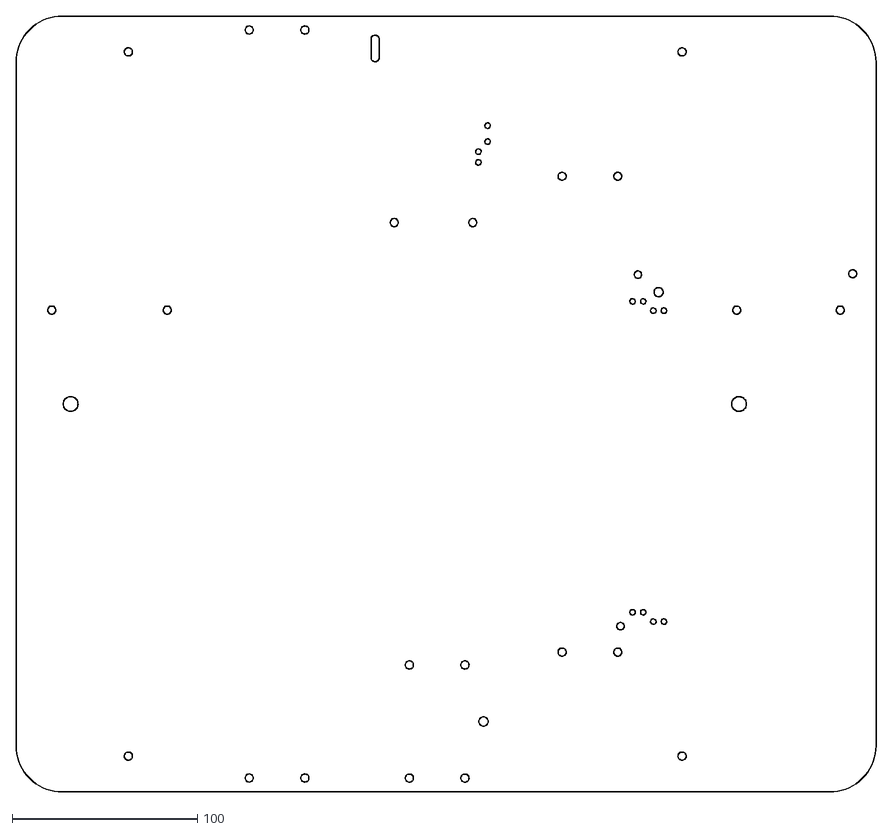
[picture p135: CAD file, 2012-12-09]
dibond/sheets/frame_base.dxf
464.5 x 419.0
