zzorn/Mendel90/dibond/stls/printed/wades_small_gear.stl

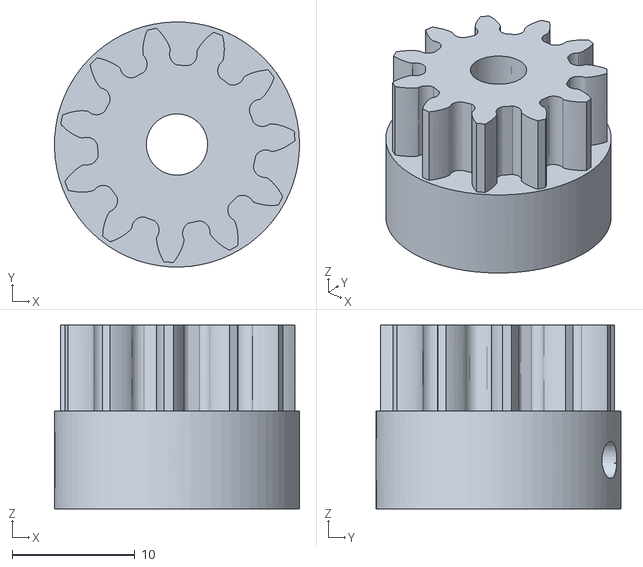
[picture p136: CAD file, 2012-12-09]
dibond/stls/printed/wades_small_gear.stl
20.0 x 20.0 x 15.0
