zzorn/Mendel90/mendel/sheets/y_carriage.dxf

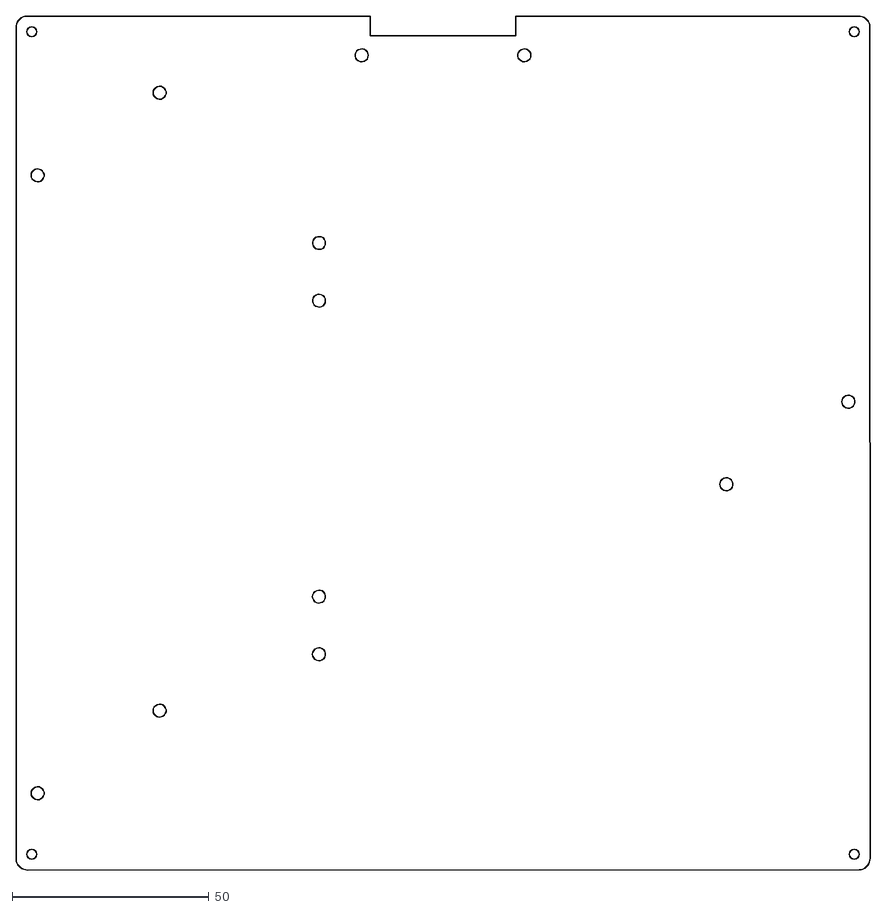
[picture p137: CAD file, 2012-12-09]
mendel/sheets/y_carriage.dxf
217.0 x 217.0
