zzorn/Mendel90/mendel/stls/printed/x_motor_bracket.stl

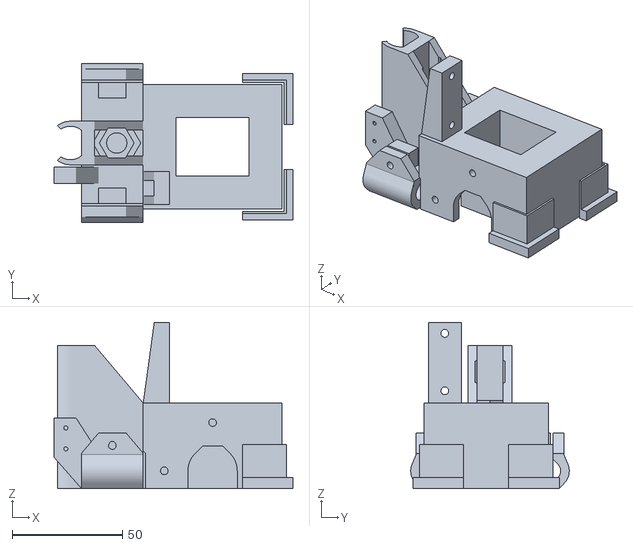
[picture p138: CAD file, 2012-12-09]
mendel/stls/printed/x_motor_bracket.stl
108.5 x 72.0 x 75.4
