zzorn/Mendel90/sturdy-a4/sheets/frame_base.dxf

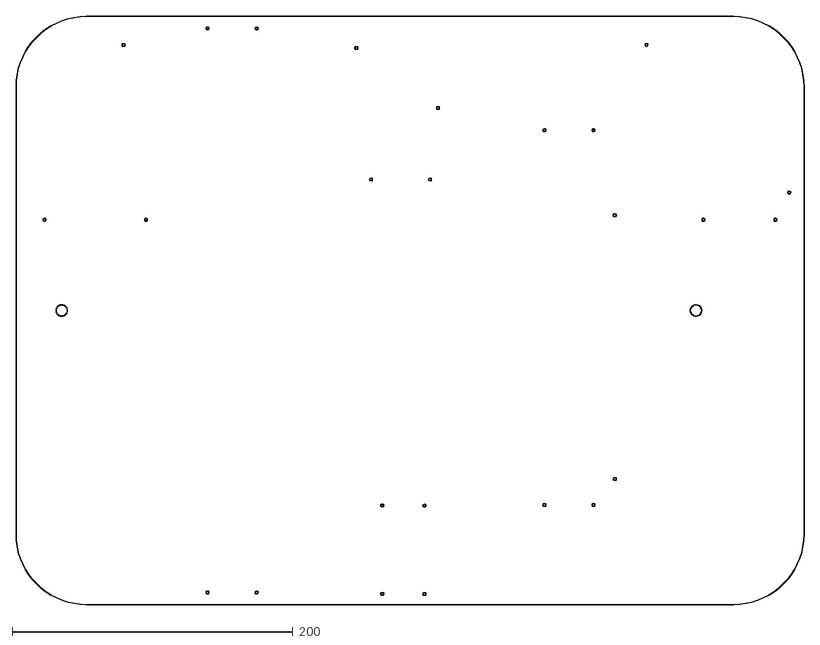
[picture p140: CAD file, 2012-12-09]
sturdy-a4/sheets/frame_base.dxf
561.5 x 419.0
