zzorn/Mendel90/sturdy/sheets/frame_stays.dxf

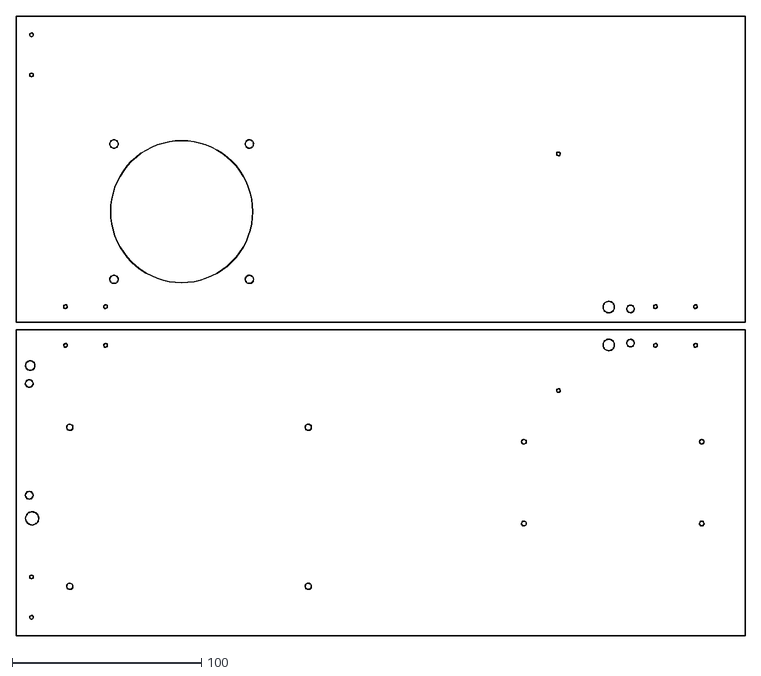
[picture p141: CAD file, 2012-12-09]
sturdy/sheets/frame_stays.dxf
385.0 x 327.0
