zzorn/Mendel90/dibond/stls/printed/fixing_blocks.stl

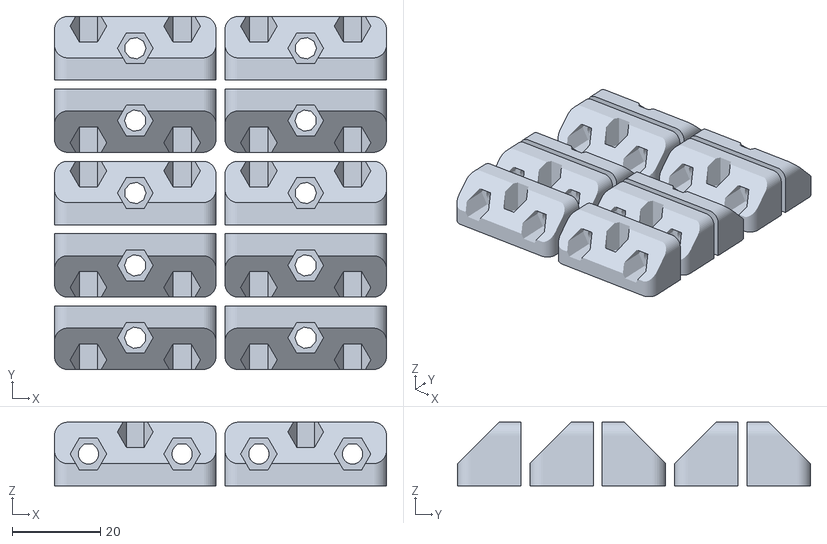
[picture p142: CAD file, 2012-12-09]
dibond/stls/printed/fixing_blocks.stl
75.2 x 80.0 x 14.4
