zzorn/Mendel90/dibond/stls/y_idler_bracket.stl

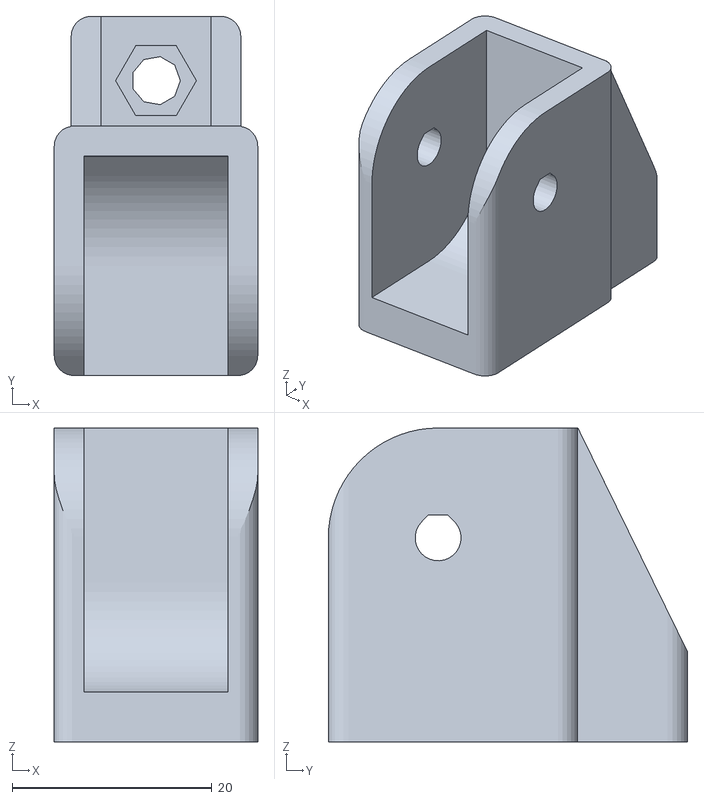
[picture p143: CAD file, 2012-12-09]
dibond/stls/y_idler_bracket.stl
20.4 x 36.0 x 31.4
