zzorn/Mendel90/mendel/stls/fixing_block.stl

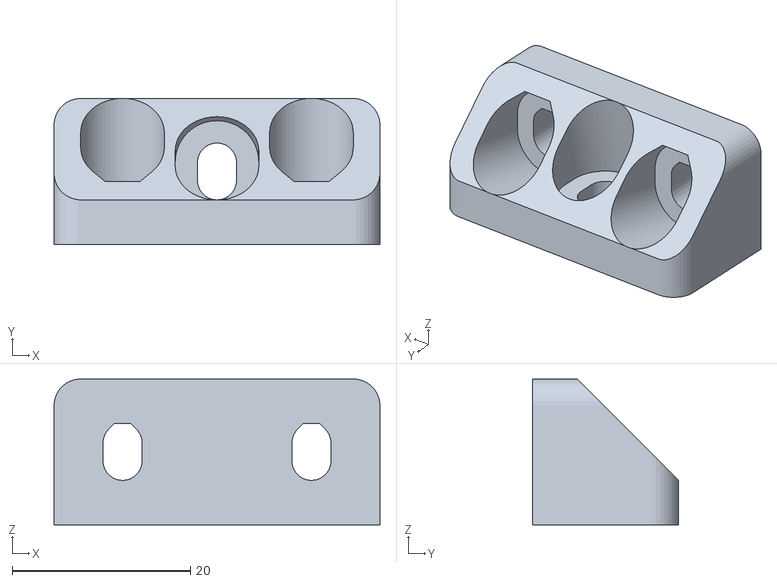
[picture p144: CAD file, 2012-12-09]
mendel/stls/fixing_block.stl
36.6 x 16.4 x 16.4
