zzorn/Mendel90/sturdy-a4/stls/z_coupling.stl

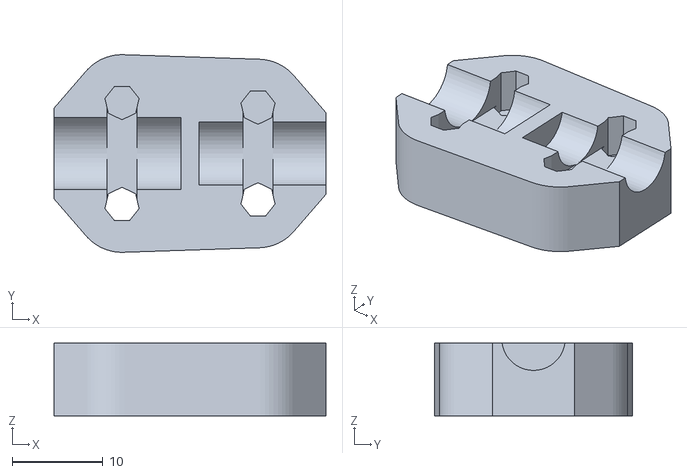
[picture p145: CAD file, 2012-12-09]
sturdy-a4/stls/z_coupling.stl
30.0 x 21.8 x 8.00
