zzorn/Mendel90/sturdy/stls/x_belt_tensioner.stl

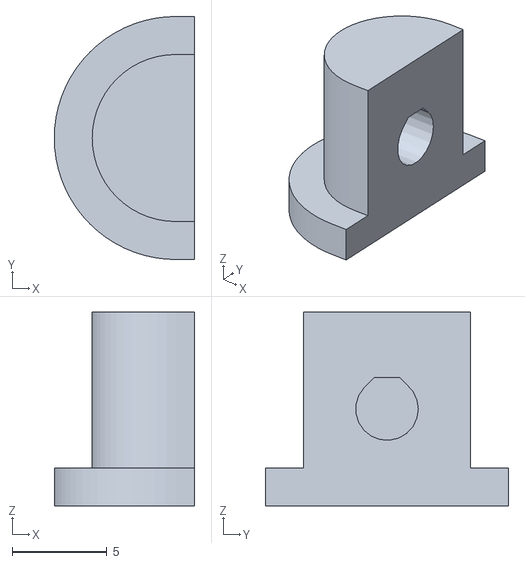
[picture p146: CAD file, 2012-12-09]
sturdy/stls/x_belt_tensioner.stl
7.40 x 12.8 x 10.2
