zzorn/Mendel90/dibond/stls/printed/wades_extruder.stl

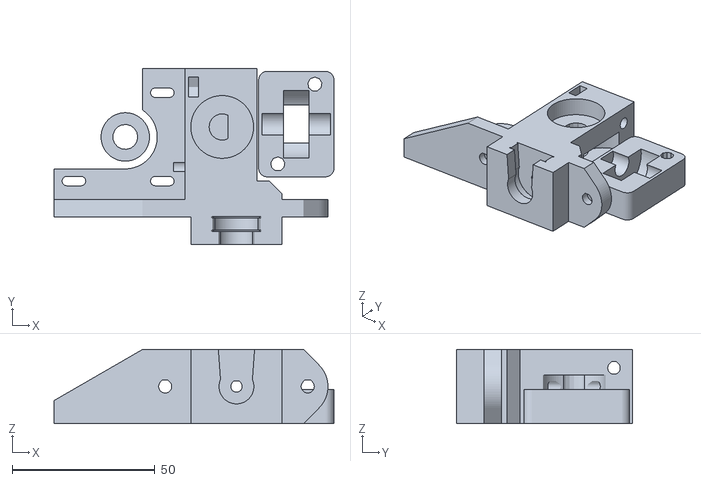
[picture p147: CAD file, 2012-12-09]
dibond/stls/printed/wades_extruder.stl
98.2 x 61.7 x 26.0
