zzorn/Mendel90/mendel/stls/ribbon_clamp_20_44.stl

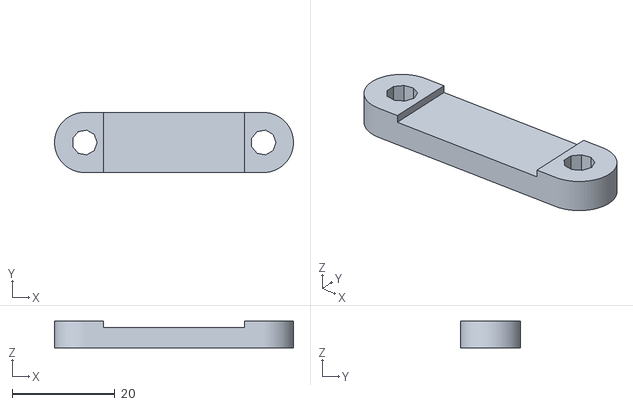
[picture p148: CAD file, 2012-12-09]
mendel/stls/ribbon_clamp_20_44.stl
46.5 x 11.7 x 5.20
