zzorn/Mendel90/sturdy-a4/stls/printed/spool_holder_brackets.stl

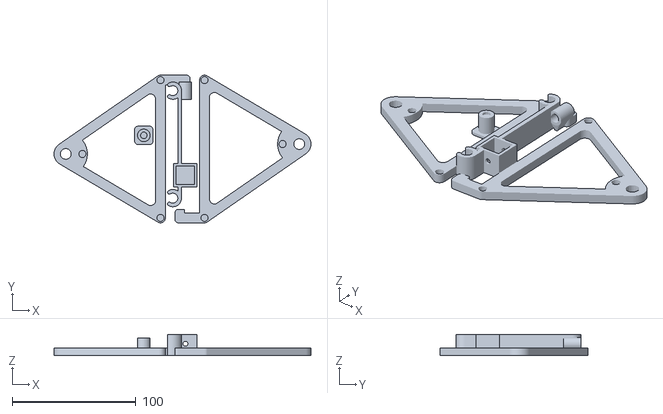
[picture p149: CAD file, 2012-12-09]
sturdy-a4/stls/printed/spool_holder_brackets.stl
207.9 x 119.5 x 17.0
