zzorn/Mendel90/sturdy/stls/y_belt_clip_toothed.stl

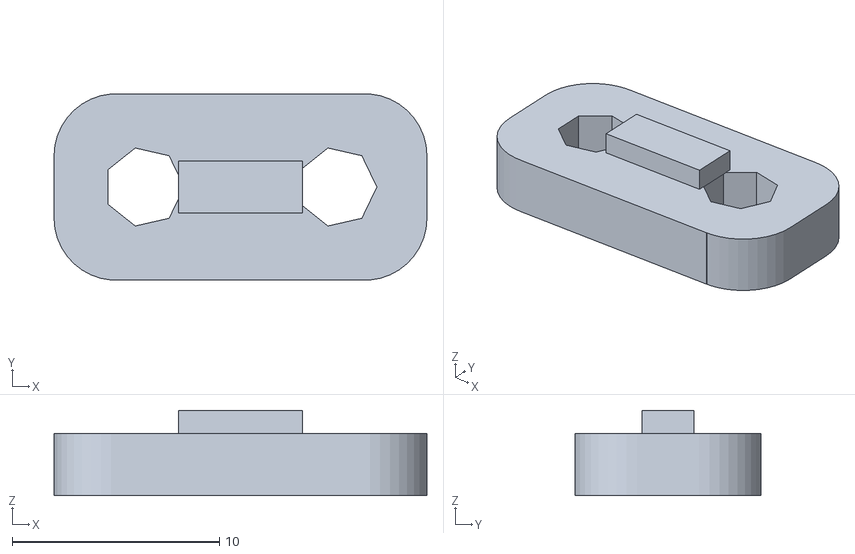
[picture p150: CAD file, 2012-12-09]
sturdy/stls/y_belt_clip_toothed.stl
18.0 x 9.00 x 4.12
