zzorn/Mendel90/mendel/stls/printed/ribbon_clamps.stl

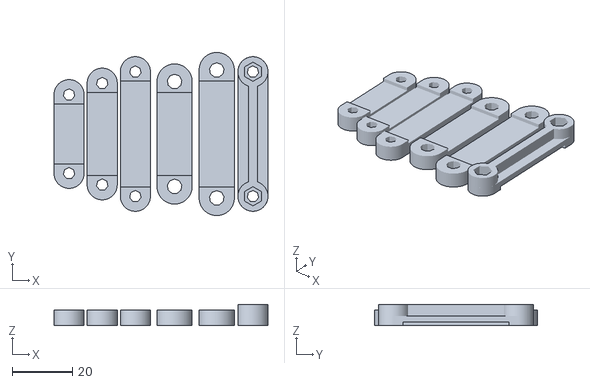
[picture p151: CAD file, 2012-12-09]
mendel/stls/printed/ribbon_clamps.stl
71.0 x 54.1 x 7.01
