zzorn/Mendel90/mendel/stls/y_bearing_mount_switch.stl

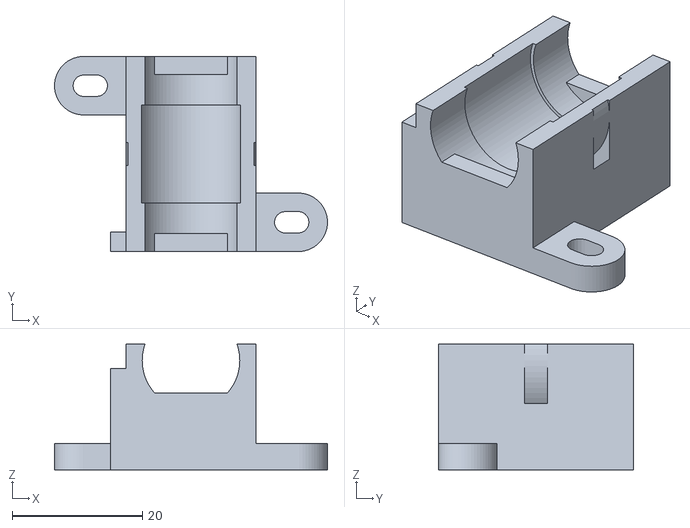
[picture p152: CAD file, 2012-12-09]
mendel/stls/y_bearing_mount_switch.stl
42.0 x 30.0 x 19.3
