zzorn/Mendel90/sturdy-a4/stls/printed/bar_clamps.stl

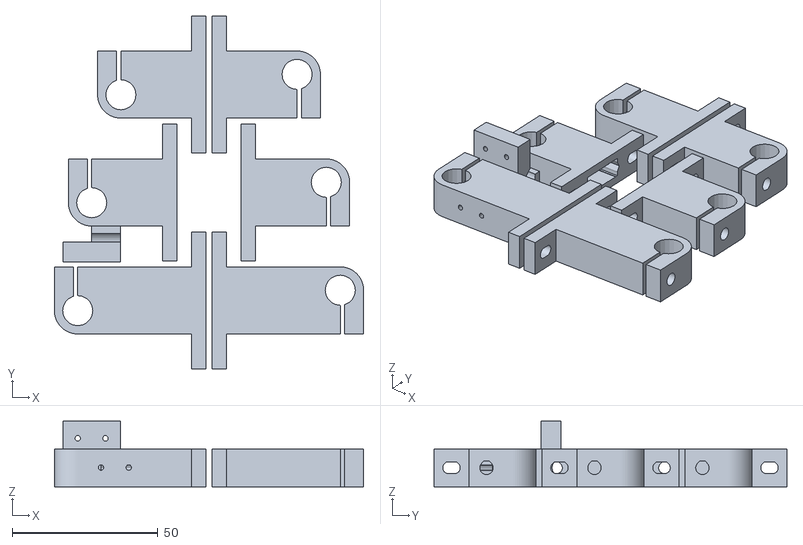
[picture p153: CAD file, 2012-12-09]
sturdy-a4/stls/printed/bar_clamps.stl
106.0 x 121.0 x 22.5
