zzorn/Mendel90/sturdy-a4/stls/y_bearing_mount_switch.stl

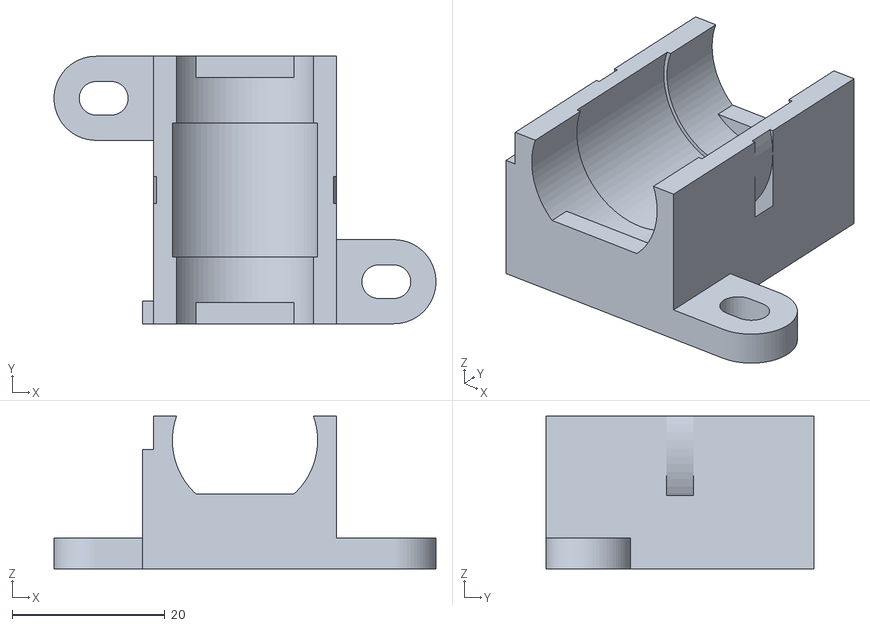
[picture p154: CAD file, 2012-12-09]
sturdy-a4/stls/y_bearing_mount_switch.stl
50.0 x 35.0 x 20.0
