zzorn/Mendel90/dibond/stls/atx_short_bracket.stl

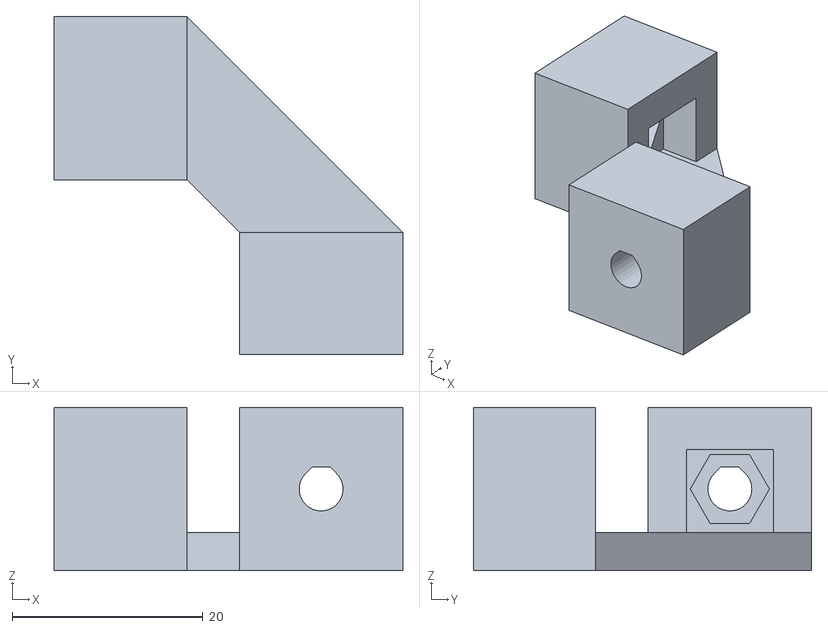
[picture p155: CAD file, 2012-12-09]
dibond/stls/atx_short_bracket.stl
36.5 x 35.4 x 17.1
