zzorn/Mendel90/dibond/stls/printed/z_coupling.stl

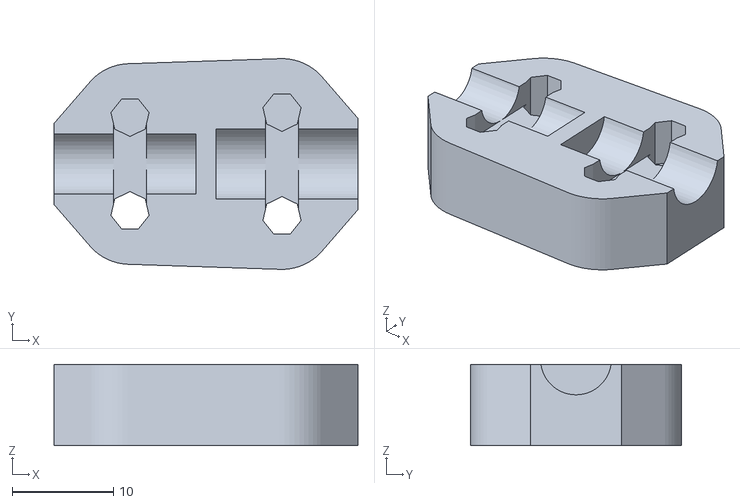
[picture p156: CAD file, 2012-12-09]
dibond/stls/printed/z_coupling.stl
30.0 x 20.8 x 8.00
