zzorn/Mendel90/mendel/stls/printed/y_motor_bracket.stl

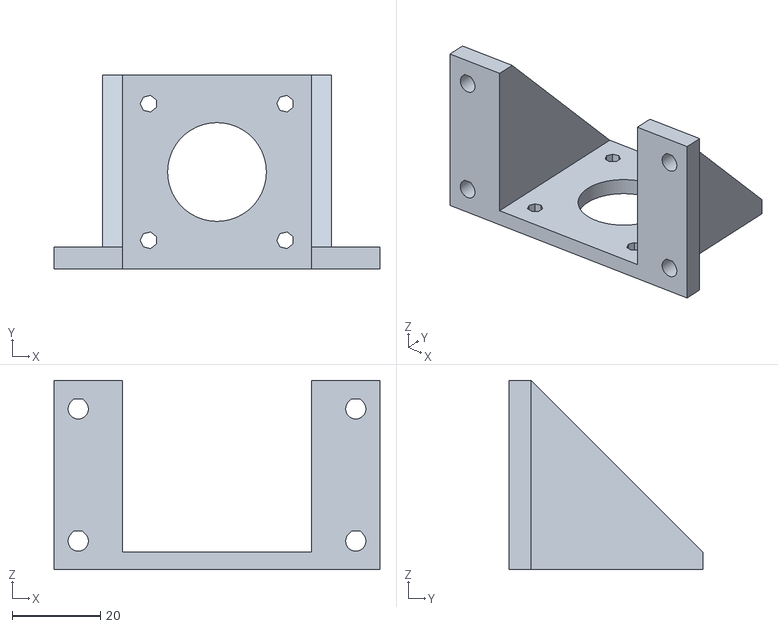
[picture p157: CAD file, 2012-12-09]
mendel/stls/printed/y_motor_bracket.stl
74.0 x 44.0 x 43.0
