zzorn/Mendel90/mendel/stls/ribbon_clamp_14_33.stl

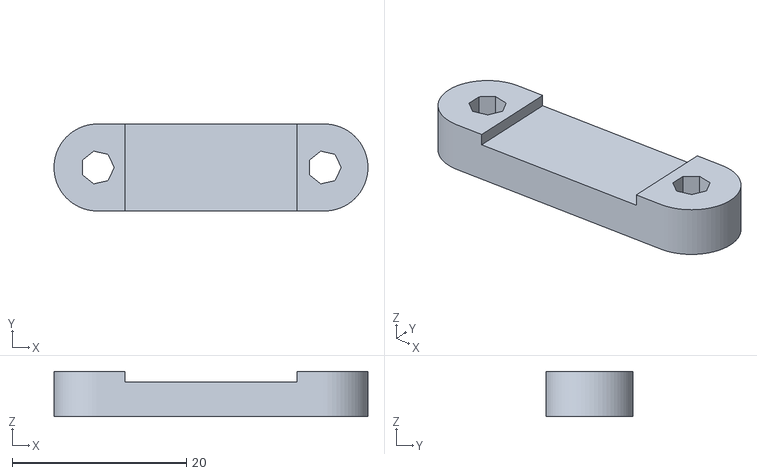
[picture p158: CAD file, 2012-12-09]
mendel/stls/ribbon_clamp_14_33.stl
36.1 x 10.00 x 5.20
