zzorn/Mendel90/sturdy/stls/printed/y_belt_anchors.stl

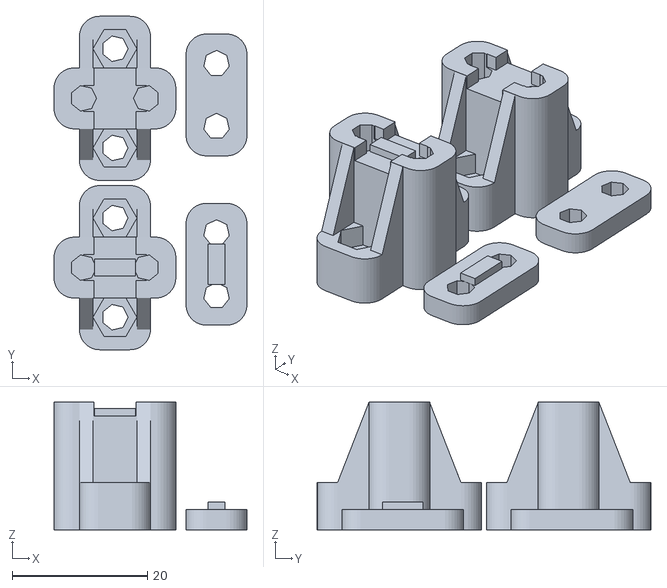
[picture p159: CAD file, 2012-12-09]
sturdy/stls/printed/y_belt_anchors.stl
28.5 x 49.3 x 18.9
