zzorn/Mendel90/mendel/stls/printed/y_bearing_mounts.stl

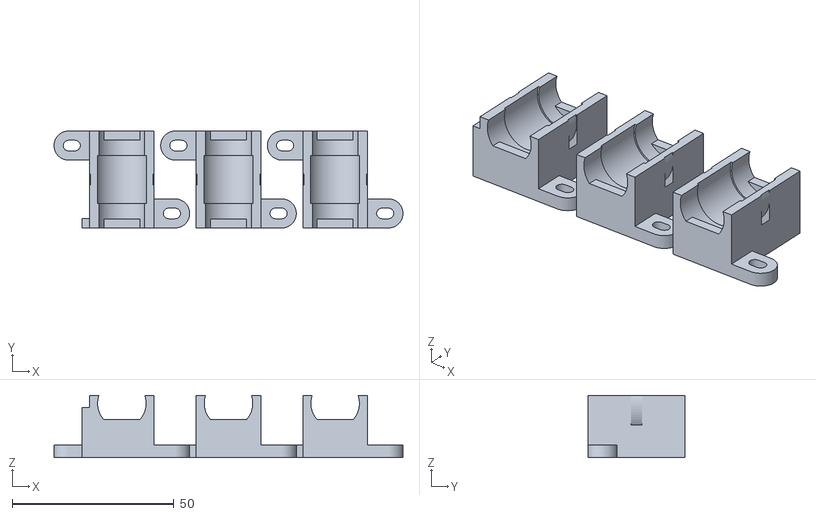
[picture p160: CAD file, 2012-12-09]
mendel/stls/printed/y_bearing_mounts.stl
108.0 x 30.0 x 19.3
