zzorn/Mendel90/mendel/stls/x_carriage_fan_bracket.stl

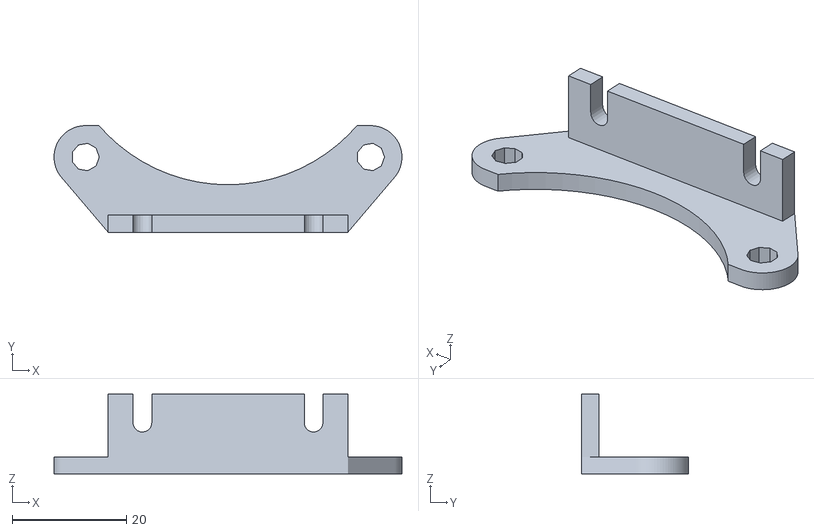
[picture p161: CAD file, 2012-12-09]
mendel/stls/x_carriage_fan_bracket.stl
61.0 x 18.7 x 14.0
