zzorn/Mendel90/sturdy-a4/stls/printed/spool_holder_tall_brackets.stl

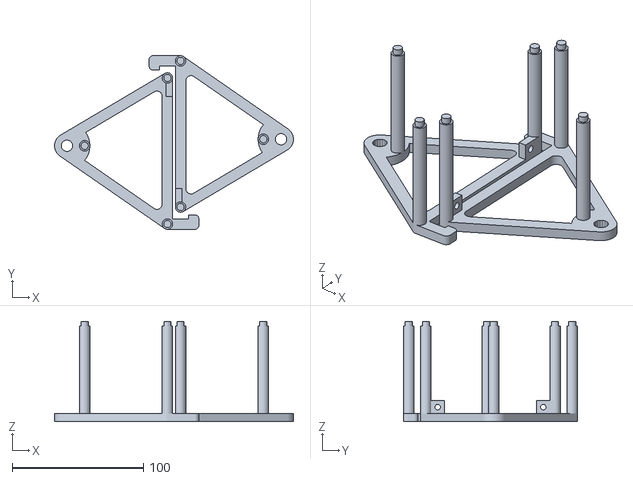
[picture p162: CAD file, 2012-12-09]
sturdy-a4/stls/printed/spool_holder_tall_brackets.stl
182.3 x 132.5 x 76.4
