zzorn/Mendel90/sturdy-a4/stls/y_bearing_mount.stl

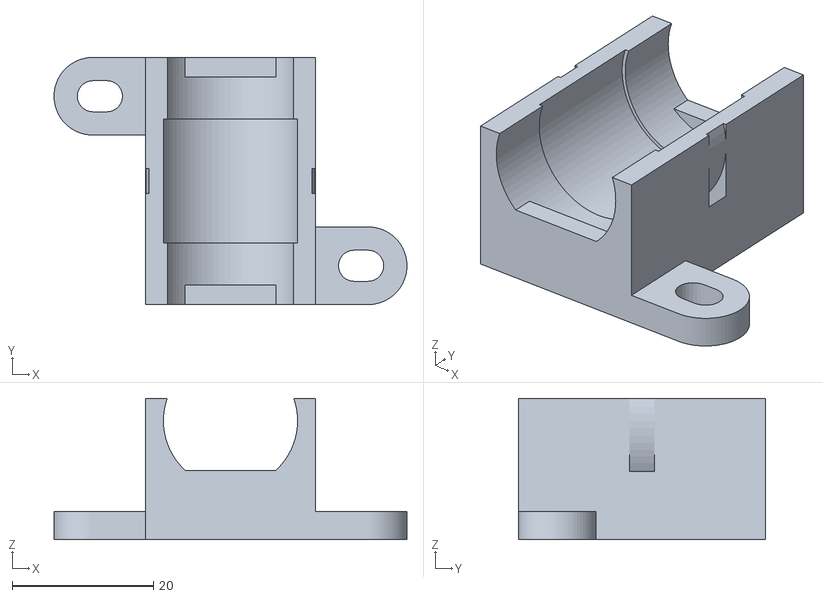
[picture p163: CAD file, 2012-12-09]
sturdy-a4/stls/y_bearing_mount.stl
50.0 x 35.0 x 20.0
