zzorn/Mendel90/sturdy/stls/printed/z_motor_brackets.stl

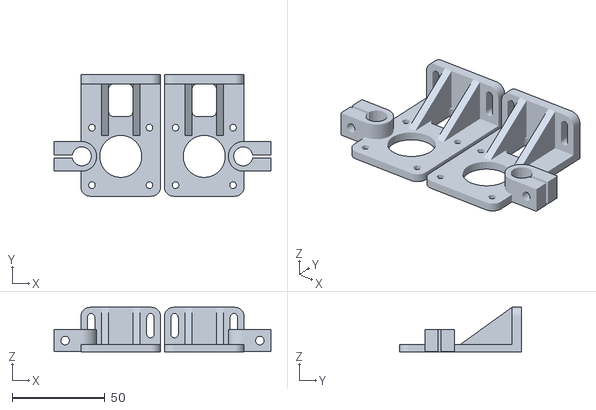
[picture p164: CAD file, 2012-12-09]
sturdy/stls/printed/z_motor_brackets.stl
117.0 x 65.5 x 24.0
