zzorn/Mendel90/sturdy/stls/spool_bracket_male.stl

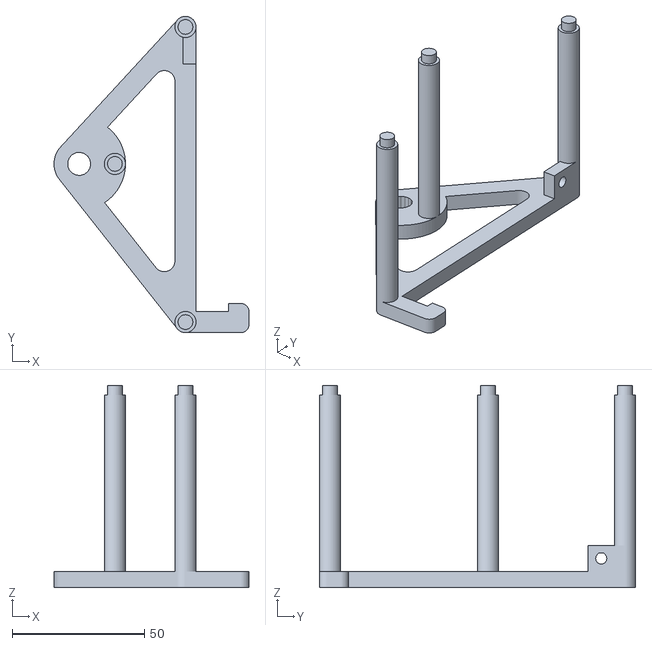
[picture p165: CAD file, 2012-12-09]
sturdy/stls/spool_bracket_male.stl
73.7 x 119.5 x 76.4
