zzorn/Mendel90/dibond/stls/printed/spool_holder_brackets.stl

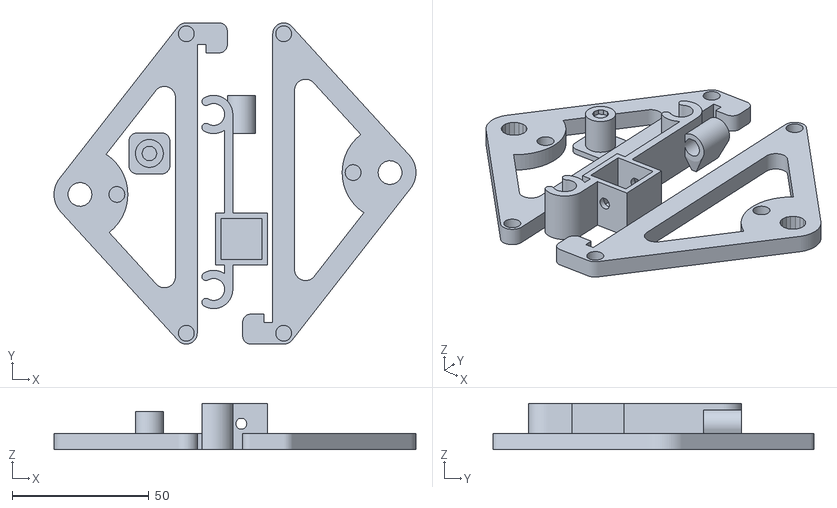
[picture p166: CAD file, 2012-12-09]
dibond/stls/printed/spool_holder_brackets.stl
132.4 x 117.5 x 17.0
