zzorn/Mendel90/dibond/stls/y_bearing_mount_switch.stl

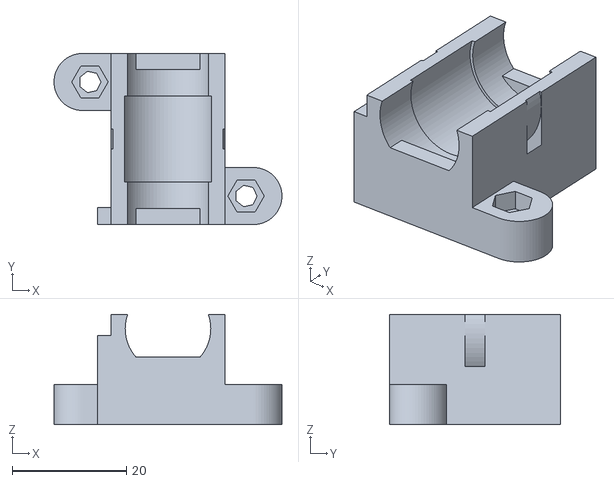
[picture p167: CAD file, 2012-12-09]
dibond/stls/y_bearing_mount_switch.stl
40.0 x 30.0 x 19.3
