zzorn/Mendel90/mendel/stls/printed/atx_brackets.stl

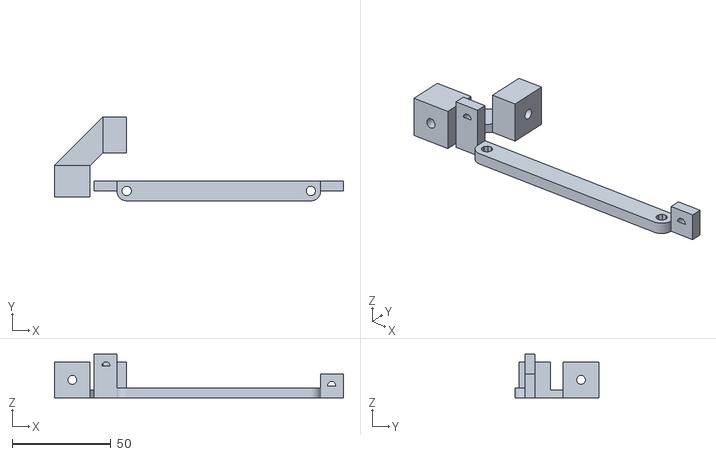
[picture p168: CAD file, 2012-12-09]
mendel/stls/printed/atx_brackets.stl
146.0 x 42.3 x 22.0
