zzorn/Mendel90/mendel/stls/ribbon_clamp_26_33N.stl

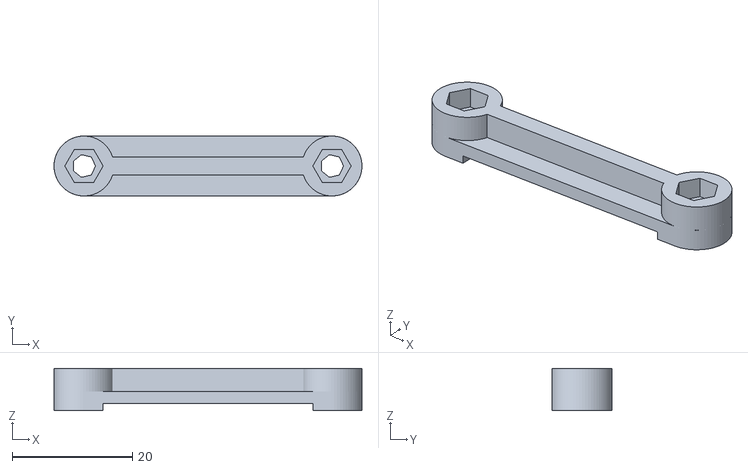
[picture p169: CAD file, 2012-12-09]
mendel/stls/ribbon_clamp_26_33N.stl
51.3 x 10.00 x 7.01
