zzorn/Mendel90/sturdy-a4/stls/wades_block.stl

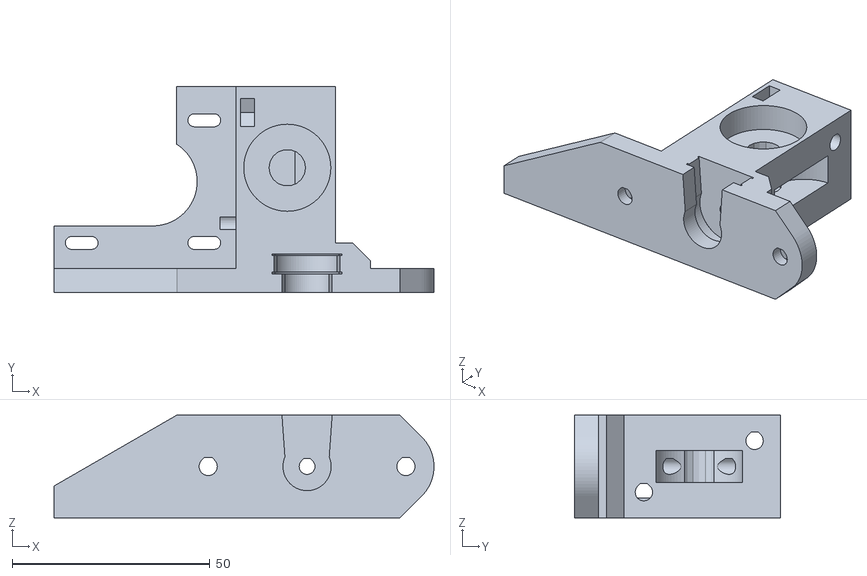
[picture p170: CAD file, 2012-12-09]
sturdy-a4/stls/wades_block.stl
96.1 x 52.0 x 26.0
