zzorn/Mendel90/dibond/stls/printed/bar_clamps.stl

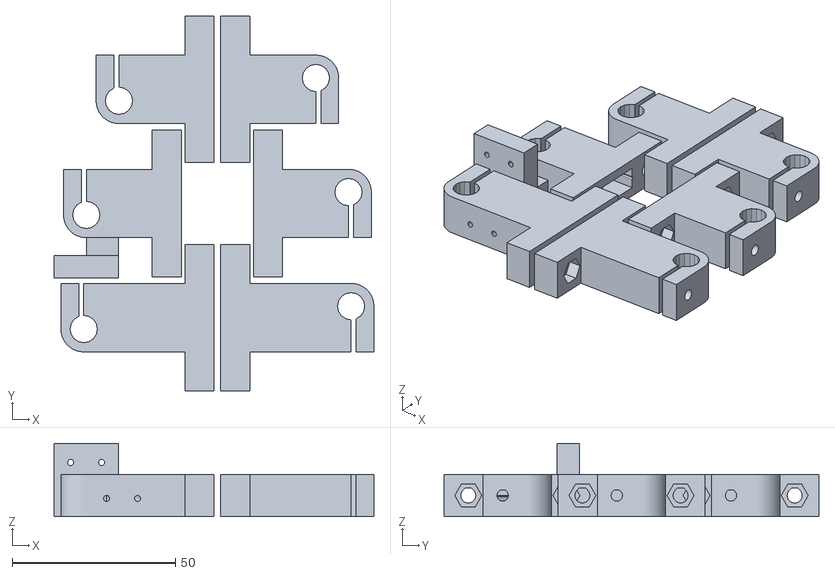
[picture p171: CAD file, 2012-12-09]
dibond/stls/printed/bar_clamps.stl
98.1 x 115.0 x 22.5
