zzorn/Mendel90/dibond/stls/wades_block.stl

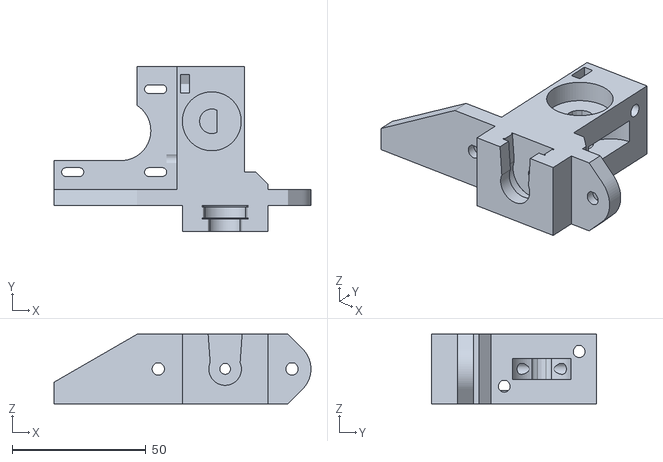
[picture p172: CAD file, 2012-12-09]
dibond/stls/wades_block.stl
96.1 x 61.7 x 26.0
