zzorn/Mendel90/sturdy/stls/d_motor_bracket.stl

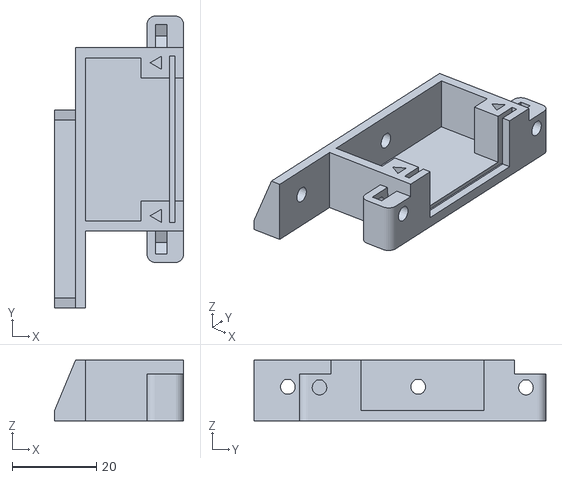
[picture p173: CAD file, 2012-12-09]
sturdy/stls/d_motor_bracket.stl
30.7 x 69.4 x 14.4
