zzorn/Mendel90/scad/conf/machine.scad

include <sturdy-a4_config.scad>
