zzorn/Mendel90/(list of files, cad)

Other CAD files:
sturdy/stls/printed/d_motor_brackets.stl
dibond/stls/printed/x_carriage_parts.stl
sturdy-a4/stls/feed_tube_connector.stl
sturdy-a4/stls/printed/x_motor_bracket.stl
sturdy-a4/stls/pcb_spacer.stl
sturdy-a4/stls/printed/d_motor_brackets.stl
sturdy/stls/printed/cal.stl
sturdy/stls/ribbon_clamp_20_40.stl
sturdy/stls/printed/fixing_blocks.stl
sturdy-a4/stls/printed/fan_guard.stl
sturdy/stls/y_bar_clamp.stl
mendel/stls/printed/cal.stl
sturdy-a4/stls/printed/pcb_spacer.stl
sturdy/stls/printed/z_coupling.stl
dibond/stls/ribbon_clamp_14_33NB.stl
sturdy-a4/stls/d_shell.stl
sturdy/stls/printed/y_bearing_mounts.stl
sturdy/stls/printed/bar_clamps.stl
sturdy-a4/stls/fan_guard.stl
sturdy-a4/stls/printed/x_carriage_fan_duct.stl
sturdy/stls/d_shell.stl
sturdy/stls/printed/x_idler_bracket.stl
mendel/stls/printed/wades_extruder.stl
mendel/stls/ribbon_clamp_26_33.stl
sturdy-a4/stls/printed/jhead_insertion_jig.stl
sturdy-a4/stls/ribbon_clamp_14_33.stl
scad/conf/huxley_config.scad
scad/conf/mendel_config.scad
scad/conf/sturdy_config.scad
dibond/sheets/frame_base_dxf.scad
dibond/sheets/frame_gantry_and_y_carriage_dxf.scad
dibond/sheets/frame_gantry_dxf.scad
dibond/sheets/frame_left_dxf.scad
dibond/sheets/frame_right_dxf.scad
dibond/sheets/y_carriage_dxf.scad
dibond/sheets/y_heatshield_dxf.scad
dibond/stls/atx_long_bracket.stl
dibond/stls/d_motor_bracket.stl
dibond/stls/d_motor_bracket_lid.stl
dibond/stls/d_shell.stl
dibond/stls/d_shell_lid.stl
dibond/stls/dust_filter.stl
dibond/stls/fan_guard.stl
dibond/stls/fixing_block.stl
dibond/stls/printed/cal.stl
dibond/stls/printed/fan_guard.stl
dibond/stls/printed/spool_holder_tall_brackets.stl
dibond/stls/printed/tube_jig.stl
dibond/stls/printed/wades_big_gear.stl
dibond/stls/printed/x_motor_bracket.stl
dibond/stls/printed/y_belt_anchors.stl
dibond/stls/printed/z_motor_brackets.stl
dibond/stls/printed/z_screw_pointer.stl
dibond/stls/ribbon_clamp_14_33.stl
dibond/stls/ribbon_clamp_20_33.stl
dibond/stls/ribbon_clamp_20_44N.stl
dibond/stls/ribbon_clamp_26_33N.stl
dibond/stls/ribbon_clamp_26_44N.stl
dibond/stls/tube_jig.stl
dibond/stls/wades_big_gear.stl
dibond/stls/wades_gear_spacer.stl
dibond/stls/wades_idler_block.stl
dibond/stls/x_belt_clamp.stl
dibond/stls/x_carriage.stl
dibond/stls/x_carriage_fan_bracket.stl
dibond/stls/x_motor_bracket.stl
dibond/stls/y_bar_clamp.stl
dibond/stls/y_bar_clamp_switch.stl
dibond/stls/y_belt_anchor.stl
dibond/stls/y_belt_anchor_toothed.stl
dibond/stls/y_belt_clip.stl
dibond/stls/y_belt_clip_toothed.stl
dibond/stls/z_bar_clamp.stl
dibond/stls/z_bar_clamp_switch.stl
dibond/stls/z_motor_bracket_lhs.stl
dibond/stls/z_screw_pointer.stl
mendel/stls/atx_long_bracket.stl
mendel/stls/d_motor_bracket.stl
mendel/stls/dust_filter.stl
mendel/stls/printed/bar_clamps.stl
mendel/stls/printed/d_motor_brackets.stl
mendel/stls/printed/spool_holder_tall_brackets.stl
mendel/stls/printed/x_carriage_fan_duct.stl
mendel/stls/printed/z_coupling.stl
mendel/stls/printed/z_screw_pointer.stl
mendel/stls/ribbon_clamp_20_33.stl
mendel/stls/spool_bracket_female.stl
mendel/stls/spool_bracket_male.stl
mendel/stls/wades_block.stl
mendel/stls/x_carriage.stl
mendel/stls/x_carriage_fan_duct.stl
mendel/stls/y_bar_clamp.stl
mendel/stls/y_bar_clamp_switch.stl
mendel/stls/y_bearing_mount.stl
mendel/stls/y_belt_clip.stl
mendel/stls/z_bar_clamp.stl
mendel/stls/z_bar_clamp_switch.stl
mendel/stls/z_coupling.stl
mendel/stls/z_motor_bracket_lhs.stl
mendel/stls/z_motor_bracket_rhs.stl
mendel/stls/z_screw_pointer.stl
scad/ATX_PSU_brackets.scad
scad/bar-clamp.scad
scad/cable_clip.scad
scad/conf/colors.scad
scad/conf/utils.scad
scad/conf/vitamins.scad
scad/d-motor_bracket.scad
scad/fixing-block.scad
scad/mains_inlet.scad
scad/pcb_spacer.scad
scad/positions.scad
scad/pulley.scad
scad/ribbon_clamp.scad
scad/small_bits.scad
scad/spool_holder.scad
scad/tube_cap.scad
scad/utils/cables.scad
scad/utils/shields.scad
scad/vitamins/bars.scad
scad/vitamins/belts.scad
scad/vitamins/cable_strip.scad
scad/vitamins/components.scad
scad/vitamins/d-connectors.scad
scad/vitamins/electronics.scad
scad/vitamins/fans.scad
scad/vitamins/hot_ends.scad
scad/vitamins/jhead_hot_end.scad
scad/vitamins/linear-bearings.scad
scad/vitamins/m90_hot_end.scad
scad/vitamins/nuts.scad
scad/vitamins/o_rings.scad
scad/vitamins/pillars.scad
scad/vitamins/pullies.scad
scad/vitamins/screws.scad
scad/vitamins/sheet.scad
scad/vitamins/spools.scad
scad/vitamins/springs.scad
scad/vitamins/stepper-motors.scad
scad/vitamins/stoffel_hot_end.scad
scad/vitamins/terminals.scad
scad/vitamins/tubing.scad
scad/vitamins/washers.scad
scad/vitamins/ziptie.scad
scad/wade.scad
scad/x-carriage.scad
scad/x-end.scad
scad/y-bearing-mount.scad
scad/y-belt-anchor.scad
scad/y-idler-bracket.scad
scad/y-motor-bracket.scad
scad/z-coupling.scad
scad/z-limit-switch-bracket.scad
scad/z-motor-bracket.scad
scad/z-screw_pointer.scad
sturdy-a4/sheets/frame_stays_dxf.scad
sturdy-a4/stls/atx_long_bracket.stl
sturdy-a4/stls/atx_short_bracket.stl
sturdy-a4/stls/cable_clip_AB.stl
sturdy-a4/stls/cable_clip_AD.stl
sturdy-a4/stls/cable_clip_CA.stl
sturdy-a4/stls/d_motor_bracket.stl
sturdy-a4/stls/d_motor_bracket_lid.stl
sturdy-a4/stls/d_shell_lid.stl
sturdy-a4/stls/dust_filter.stl
sturdy-a4/stls/fixing_block.stl
sturdy-a4/stls/jhead_insertion_jig.stl
sturdy-a4/stls/printed/atx_brackets.stl
sturdy-a4/stls/printed/cable_clips.stl
sturdy-a4/stls/printed/fixing_blocks.stl
sturdy-a4/stls/printed/wades_big_gear.stl
sturdy-a4/stls/printed/wades_small_gear.stl
sturdy-a4/stls/printed/x_carriage_parts.stl
sturdy-a4/stls/printed/y_belt_anchors.stl
sturdy-a4/stls/printed/y_idler_bracket.stl
sturdy-a4/stls/printed/y_motor_bracket.stl
sturdy-a4/stls/printed/z_motor_brackets.stl
sturdy-a4/stls/printed/z_screw_pointer.stl
sturdy-a4/stls/ribbon_clamp_14_33NB.stl
sturdy-a4/stls/ribbon_clamp_20_40.stl
sturdy-a4/stls/ribbon_clamp_26_40.stl
sturdy-a4/stls/ribbon_clamp_26_44.stl
sturdy-a4/stls/spool_bracket_female.stl
sturdy-a4/stls/spool_bracket_male.stl
sturdy-a4/stls/wades_big_gear.stl
sturdy-a4/stls/wades_gear_spacer.stl
sturdy-a4/stls/wades_idler_block.stl
sturdy-a4/stls/wades_small_gear.stl
sturdy-a4/stls/x_belt_clamp.stl
sturdy-a4/stls/x_belt_grip.stl
sturdy-a4/stls/x_belt_tensioner.stl
sturdy-a4/stls/x_carriage.stl
sturdy-a4/stls/x_carriage_fan_bracket.stl
sturdy-a4/stls/x_carriage_fan_duct.stl
sturdy-a4/stls/x_motor_bracket.stl
sturdy-a4/stls/y_bar_clamp_switch.stl
sturdy-a4/stls/y_belt_anchor.stl
sturdy-a4/stls/y_belt_anchor_toothed.stl
sturdy-a4/stls/y_belt_clip.stl
sturdy-a4/stls/y_belt_clip_toothed.stl
sturdy-a4/stls/y_idler_bracket.stl
sturdy-a4/stls/y_motor_bracket.stl
sturdy-a4/stls/z_bar_clamp.stl
sturdy-a4/stls/z_bar_clamp_switch.stl
sturdy-a4/stls/z_motor_bracket_lhs.stl
sturdy-a4/stls/z_screw_pointer.stl
sturdy/stls/d_motor_bracket_lid.stl
sturdy/stls/d_shell_lid.stl
sturdy/stls/dust_filter.stl
sturdy/stls/fan_guard.stl
sturdy/stls/fixing_block.stl
sturdy/stls/printed/fan_guard.stl
sturdy/stls/printed/ribbon_clamps.stl
sturdy/stls/printed/spool_holder_brackets.stl
sturdy/stls/printed/spool_holder_tall_brackets.stl
sturdy/stls/printed/wades_extruder.stl
sturdy/stls/printed/x_carriage_parts.stl
sturdy/stls/printed/z_screw_pointer.stl
sturdy/stls/ribbon_clamp_14_33NB.stl
sturdy/stls/ribbon_clamp_20_33.stl
sturdy/stls/ribbon_clamp_26_40.stl
sturdy/stls/ribbon_clamp_26_44.stl
sturdy/stls/ribbon_clamp_26_44N.stl
sturdy/stls/spool_bracket_female.stl
sturdy/stls/wades_block.stl
sturdy/stls/wades_gear_spacer.stl
sturdy/stls/x_carriage.stl
sturdy/stls/x_idler_bracket.stl
sturdy/stls/y_bar_clamp_switch.stl
sturdy/stls/y_bearing_mount.stl
sturdy/stls/y_bearing_mount_switch.stl
sturdy/stls/y_belt_anchor_toothed.stl
sturdy/stls/y_belt_clip.stl
sturdy/stls/z_bar_clamp.stl
sturdy/stls/z_bar_clamp_switch.stl
sturdy/stls/z_coupling.stl
sturdy/stls/z_motor_bracket_lhs.stl
sturdy/stls/z_motor_bracket_rhs.stl
sturdy/stls/z_screw_pointer.stl
views/extruder_motor_assembly.scad
views/frame_assembly.scad
views/front_page.scad
views/heatshield_assembly.scad
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
