zzorn/Mendel90/sturdy-a4/bom/frame_assembly.txt

frame_assembly:
Vitamins:
  2 MDF sheet 153mm x 435mm x 12mm
  1 MDF sheet 562mm x 419mm x 12mm
  1 MDF sheet 562mm x 435mm x 12mm
 39 No6 pan wood screw x 16mm
 39 Washer M4 x 9mm x 0.8mm
 39 Star washer M4 x 0.8mm

Printed:
  2 cable_clip_AB.stl
  2 cable_clip_AD.stl
  1 cable_clip_CA.stl
 10 fixing_block.stl
  1 ribbon_clamp_20_40.stl
  1 ribbon_clamp_26_40.stl
