zzorn/Mendel90/sturdy-a4/bom/y_carriage_assembly.txt

y_carriage_assembly:
Vitamins:
  8 M3 cap screw x 16mm
  6 M4 cap screw x 16mm
  2 M4 cap screw x 20mm
  1 Dibond sheet 297mm x 210mm x 3mm
  3 LM10UU linear bearing
  8 Nyloc nut M3
  8 Nyloc nut M4
  8 Washer M3 x 7mm x 0.5mm
 14 Washer M4 x 9mm x 0.8mm
  3 Ziptie 105mm min length

Printed:
  1 ribbon_clamp_26_44.stl
  1 ribbon_clamp_26_44N.stl
  2 y_bearing_mount.stl
  1 y_bearing_mount_switch.stl
  1 y_belt_anchor.stl
  1 y_belt_anchor_toothed.stl
  1 y_belt_clip.stl
  1 y_belt_clip_toothed.stl
