zzorn/Mendel90/dibond/bom/hot_end_assembly.txt

hot_end_assembly:
Vitamins:
  1 JHead MK5 hot end
  2 PTFE sleeving OD 1.2mm ID 0.71mm x 62mm
  2 Heatshrink sleeving ID 1.6mm x 15mm
  2 PTFE sleeving OD 2.6mm ID 2mm x 45mm
  2 Heatshrink sleeving ID 2.4mm x 15mm
  1 Heatshrink sleeving ID 6.4mm x 60mm
  2 Red wire 16/0.2 length 170mm
  1 Ziptie 100mm min length

Printed:
