zzorn/Mendel90/dibond/bom/psu_assembly.txt

psu_assembly:
Vitamins:
  1 THS15 Aluminium clad resistor 10R
  1 THS15 Aluminium clad resistor 4R7
  1 PSU e.g. ALPINE500
  4 M4 cap screw x 16mm
  1 IEC mains lead
  4 Nyloc nut M2.5
  4 Nyloc nut M4
  4 M2.5 pan screw x 12mm
  2 6-32 pan screw x 9.5mm
  1 Heatshrink sleeving ID 10mm x 15mm
  3 Heatshrink sleeving ID 2.4mm x 15mm
  5 Heatshrink sleeving ID 3.2mm x 15mm
  2 Heatshrink sleeving ID 6.4mm x 15mm
  4 Washer M2.5 x 5.9mm x 0.5mm
  6 Washer M4 x 9mm x 0.8mm
  2 Star washer M4 x 0.8mm
  2 Ziptie 100mm min length

Printed:
  1 atx_long_bracket.stl
  1 atx_short_bracket.stl
