zzorn/Mendel90/dibond/bom/x_idler_assembly.txt

x_idler_assembly:
Vitamins:
  2 Ball bearing 624 4mm x 13mm x 5mm
  1 M4 cap screw x 45mm
  2 M3 hex screw x 16mm
  2 LM8UU linear bearing
  2 Nyloc nut M3
  1 Nyloc nut M4
  2 Washer M3 x 7mm x 0.5mm
  2 Washer M4 x 9mm x 0.8mm
  2 Washer M5 x 20mm x 1.4mm

Printed:
  1 x_idler_bracket.stl
