zzorn/Mendel90/dibond/bom/y_axis_assembly.txt

y_axis_assembly:
Vitamins:
  1 Belt T5 x 6mm x 670mm (PU & Kevlar)
  4 M3 cap screw x 16mm
  8 M4 cap screw x 16mm
  4 Nyloc nut M3
  8 Nyloc nut M4
  2 No2 pan wood screw x 13mm
  1 Smooth rod 8mm x 270mm
  1 Smooth rod 8mm x 417mm
  1 Microswitch
  2 Washer M2.5 x 5.9mm x 0.5mm
  4 Washer M3 x 7mm x 0.5mm
  8 Washer M4 x 9mm x 0.8mm

Printed:
  3 y_bar_clamp.stl
  1 y_bar_clamp_switch.stl

Sub-assemblies:
  1 print_bed_assembly
  1 y_idler_assembly
  1 y_motor_assembly
