zzorn/Mendel90/dibond/bom/y_carriage_assembly.txt

y_carriage_assembly:
Vitamins:
 14 M3 cap screw x 16mm
  2 M3 cap screw x 20mm
  1 Dibond sheet 216mm x 216mm x 3mm
  3 LM8UU linear bearing
 16 Nyloc nut M3
 16 Washer M3 x 7mm x 0.5mm
  3 Ziptie 100mm min length

Printed:
  1 ribbon_clamp_26_33.stl
  1 ribbon_clamp_26_33N.stl
  2 y_bearing_mount.stl
  1 y_bearing_mount_switch.stl
  1 y_belt_anchor.stl
  1 y_belt_anchor_toothed.stl
  1 y_belt_clip.stl
  1 y_belt_clip_toothed.stl
