zzorn/Mendel90/dibond/bom/y_motor_assembly.txt

y_motor_assembly:
Vitamins:
  4 M4 cap screw x 16mm
  1 M3 grub screw x 3mm
  1 NEMA17 x 47.5mm stepper motor
  4 Nyloc nut M4
  4 M3 pan screw x 8mm
  1 T5 pulley 10 teeth
  4 Washer M3 x 7mm x 0.5mm
  4 Washer M4 x 9mm x 0.8mm
  4 Star washer M3 x 0.5mm

Printed:
  1 y_motor_bracket.stl
