zzorn/Mendel90/mendel/bom/frame_assembly.txt

frame_assembly:
Vitamins:
  1 Acrylic sheet 471mm x 422mm x 10mm
  2 Acrylic sheet 165mm x 389mm x 6mm
  1 Acrylic sheet 471mm x 389mm x 6mm
 28 M4 pan screw x 12mm
 11 M4 pan screw x 16mm
 39 Washer M4 x 9mm x 0.8mm
 39 Star washer M4 x 0.8mm

Printed:
  2 cable_clip_AB.stl
  2 cable_clip_AD.stl
  1 cable_clip_CA.stl
 10 fixing_block.stl
  1 ribbon_clamp_20_44.stl
  1 ribbon_clamp_26_44.stl
