zzorn/Mendel90/mendel/bom/x_axis_assembly.txt

x_axis_assembly:
Vitamins:
  1 Belt T5 x 6mm x 870mm (PU & Kevlar)
  2 Smooth rod 8mm x 385mm
  2 Wingnut M4

Printed:

Sub-assemblies:
  1 extruder_assembly
  1 x_carriage_assembly
  1 x_carriage_fan_assembly
