zzorn/Mendel90/mendel/bom/y_carriage_assembly.txt

y_carriage_assembly:
Vitamins:
  1 Acrylic sheet 217mm x 217mm x 6mm
 14 M3 cap screw x 16mm
  2 M3 cap screw x 20mm
  3 LM8UU linear bearing
 16 Nyloc nut M3
 22 Washer M3 x 7mm x 0.5mm
  3 Ziptie 100mm min length

Printed:
  1 ribbon_clamp_26_33.stl
  1 ribbon_clamp_26_33N.stl
  2 y_bearing_mount.stl
  1 y_bearing_mount_switch.stl
  1 y_belt_anchor.stl
  1 y_belt_anchor_toothed.stl
  1 y_belt_clip.stl
  1 y_belt_clip_toothed.stl
