zzorn/Mendel90/mendel/bom/y_idler_assembly.txt

y_idler_assembly:
Vitamins:
  2 Ball bearing 624 4mm x 13mm x 5mm
  1 M4 cap screw x 30mm
  1 Nyloc nut M4
  1 M4 pan screw x 16mm
  5 Washer M4 x 9mm x 0.8mm
  2 Washer M5 x 20mm x 1.4mm
  1 Star washer M4 x 0.8mm

Printed:
  1 y_idler_bracket.stl
