zzorn/Mendel90/mendel/bom/y_motor_assembly.txt

y_motor_assembly:
Vitamins:
  1 M3 grub screw x 6mm
  1 NEMA17 x 47.5mm stepper motor
  1 Nut M3
  4 M3 pan screw x 8mm
  4 M4 pan screw x 16mm
  4 Washer M3 x 7mm x 0.5mm
  4 Washer M4 x 9mm x 0.8mm
  4 Star washer M3 x 0.5mm
  4 Star washer M4 x 0.8mm

Printed:
  1 pulley.stl
  1 y_motor_bracket.stl
