zzorn/Mendel90/sturdy-a4/bom/bed_fan_assembly.txt

bed_fan_assembly:
Vitamins:
  4 M4 cap screw x 25mm
  4 Nyloc nut M4
  4 Washer M4 x 9mm x 0.8mm

Printed:
  1 fan_guard.stl
