zzorn/Mendel90/sturdy-a4/bom/extruder_connection_pcb_assembly.txt

extruder_connection_pcb_assembly:
Vitamins:
  1 Extruder connection PCB
  4 3 way terminal block

Printed:
