zzorn/Mendel90/sturdy-a4/bom/x_idler_assembly.txt

x_idler_assembly:
Vitamins:
  2 Ball bearing 624 4mm x 13mm x 5mm
  1 M4 cap screw x 45mm
  2 M4 hex screw x 16mm
  2 LM10UU linear bearing
  3 Nyloc nut M4
  4 Washer M4 x 9mm x 0.8mm
  2 Washer M5 x 20mm x 1.4mm

Printed:
  1 x_idler_bracket.stl
