zzorn/Mendel90/sturdy/bom/mains_inlet_assembly.txt

mains_inlet_assembly:
Vitamins:
  3 No6 pan wood screw x 16mm
  3 Washer M4 x 9mm x 0.8mm
  3 Star washer M4 x 0.8mm

Printed:
  1 mains_inlet.stl
