zzorn/Mendel90/sturdy/bom/psu_assembly.txt

psu_assembly:
Vitamins:
  4 M3 cap screw x 16mm
  1 PSU e.g. KY240W12L
  4 Washer M3 x 7mm x 0.5mm
  4 Star washer M3 x 0.5mm

Printed:

Sub-assemblies:
  1 mains_inlet_assembly
