zzorn/Mendel90/sturdy/bom/x_axis_assembly.txt

x_axis_assembly:
Vitamins:
  1 Belt T5 x 6mm x 905mm (PU & Kevlar)
  2 Smooth rod 10mm x 403mm
  2 Wingnut M4

Printed:

Sub-assemblies:
  1 extruder_assembly
  1 x_carriage_assembly
  1 x_carriage_fan_assembly
