zzorn/Mendel90/dibond/manual/android.JPG

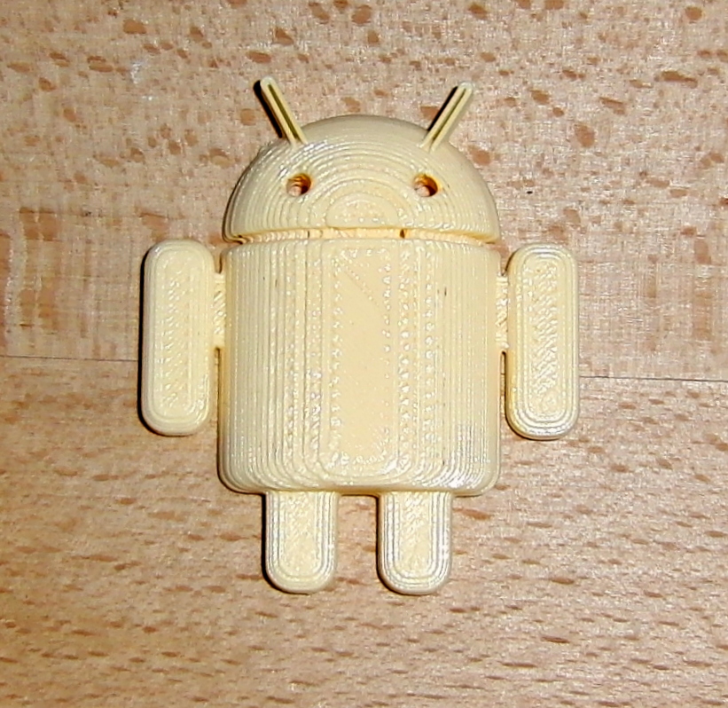
dibond/manual/android.JPG
