zzorn/Mendel90/dibond/manual/bed_assembly.png

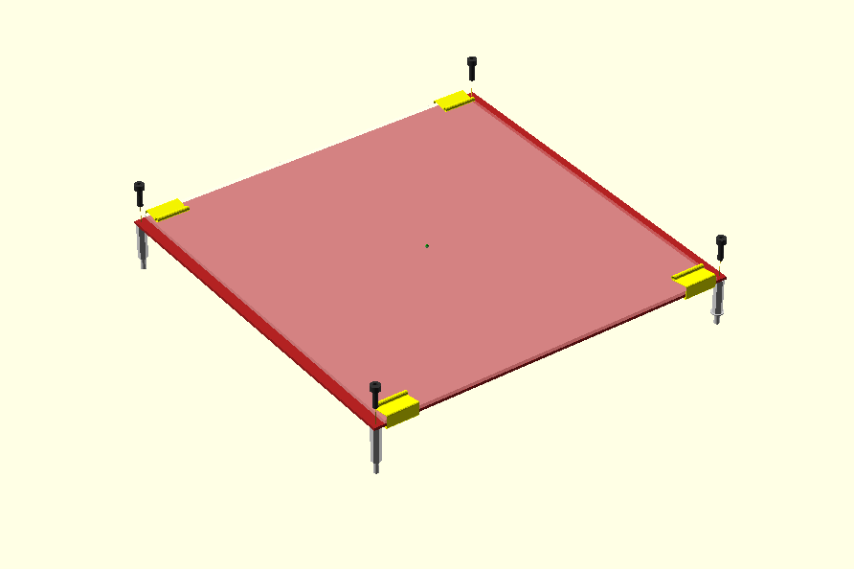
dibond/manual/bed_assembly.png
