zzorn/Mendel90/dibond/manual/bed_fan_assembly.png

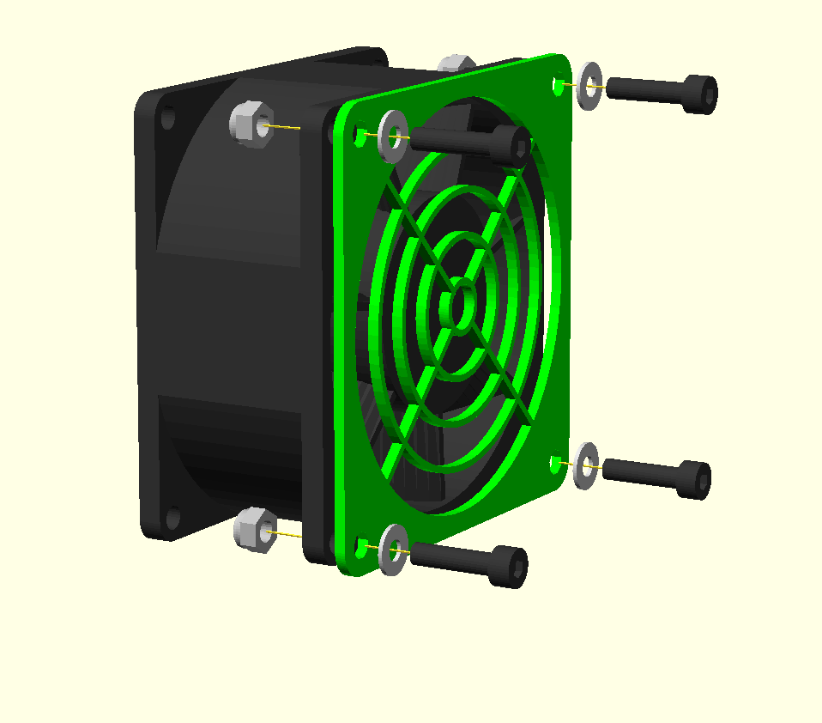
dibond/manual/bed_fan_assembly.png
