zzorn/Mendel90/dibond/manual/bed_wiring.JPG

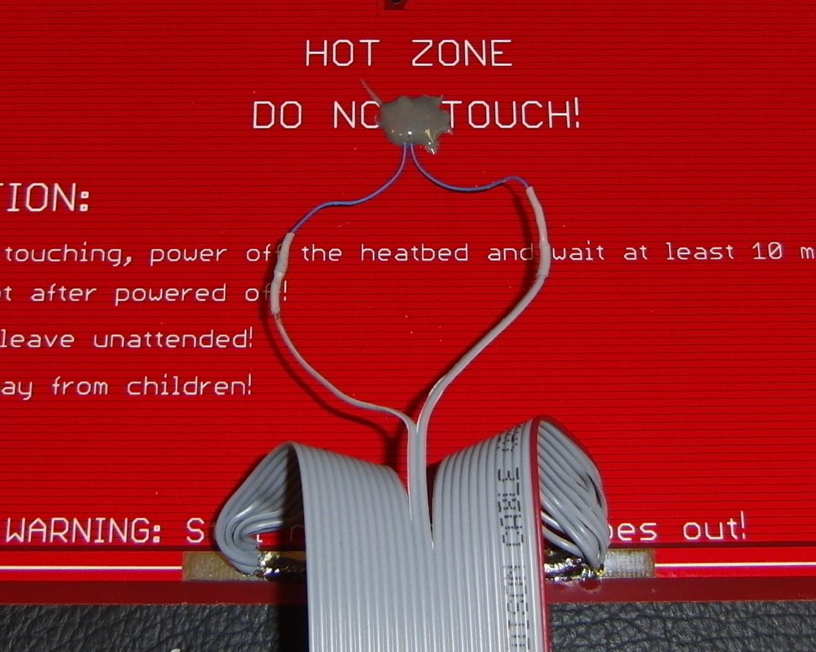
dibond/manual/bed_wiring.JPG
