zzorn/Mendel90/dibond/manual/bed_wiring_junction.JPG

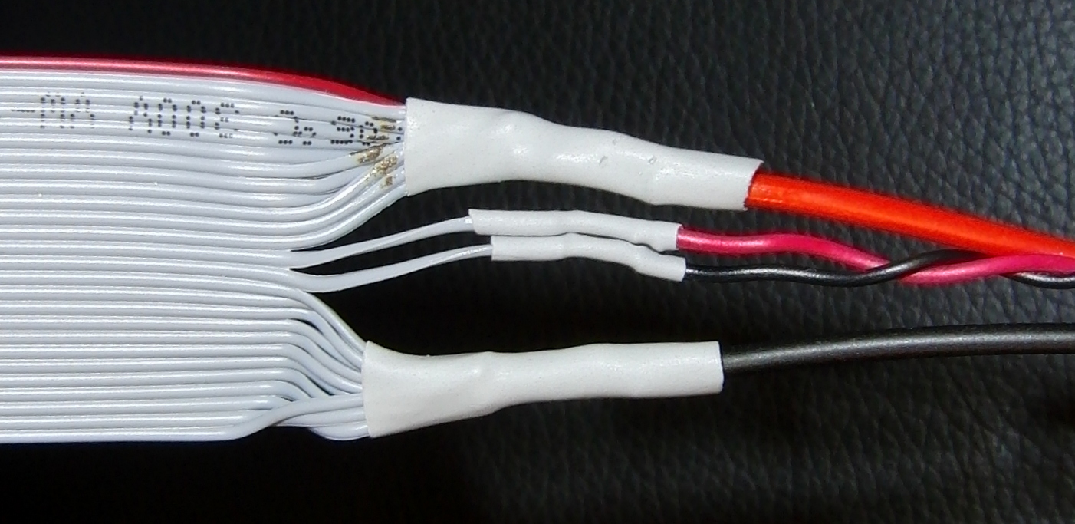
dibond/manual/bed_wiring_junction.JPG
