zzorn/Mendel90/dibond/manual/carriage_dial_gauge.JPG

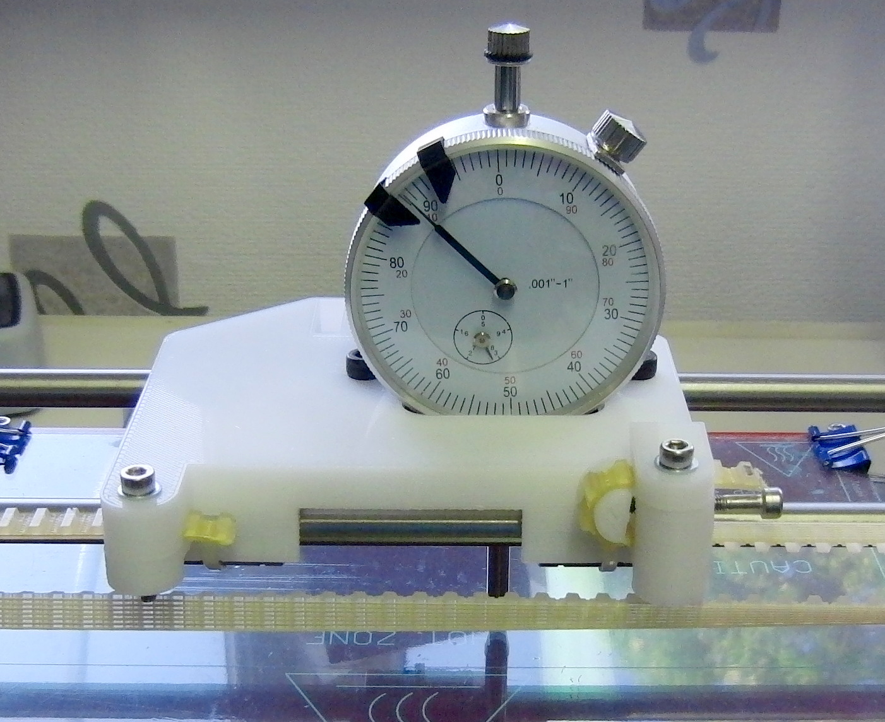
dibond/manual/carriage_dial_gauge.JPG
