zzorn/Mendel90/dibond/manual/D_connector_assembly.png

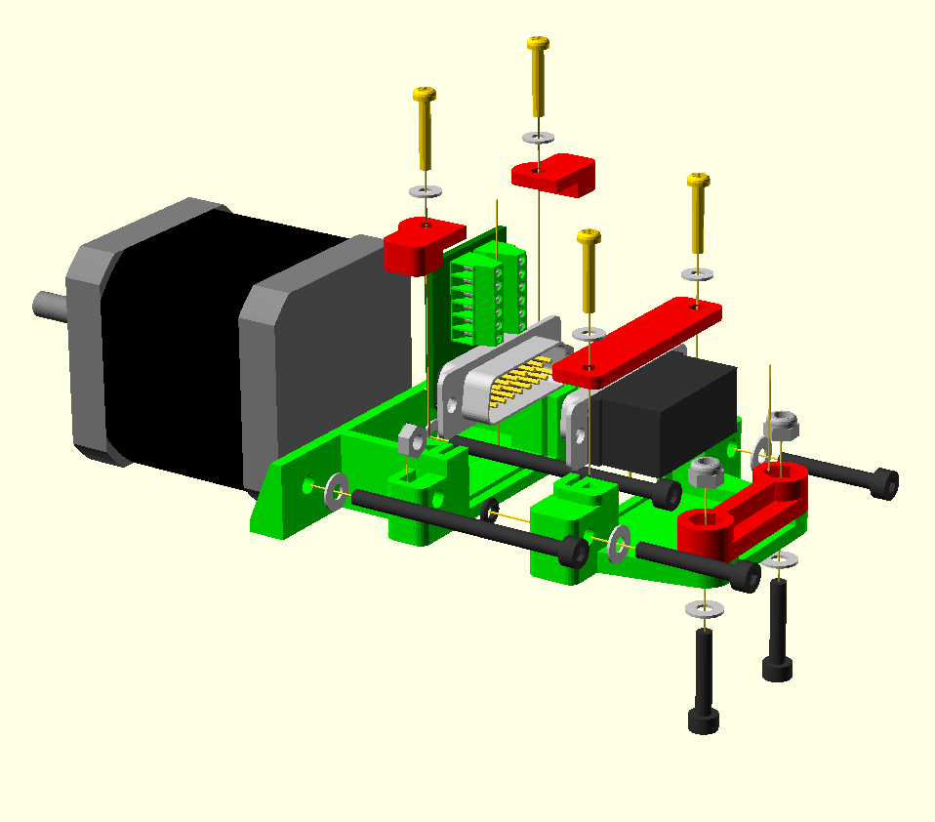
dibond/manual/D_connector_assembly.png
