zzorn/Mendel90/dibond/manual/d_connector_in_shell.JPG

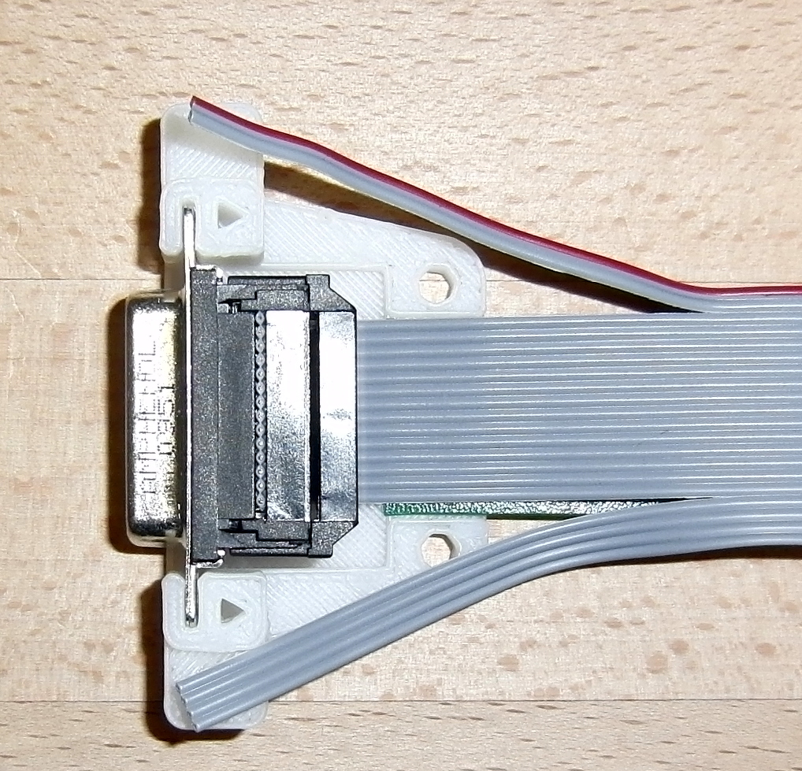
dibond/manual/d_connector_in_shell.JPG
