zzorn/Mendel90/dibond/manual/d_socket.JPG

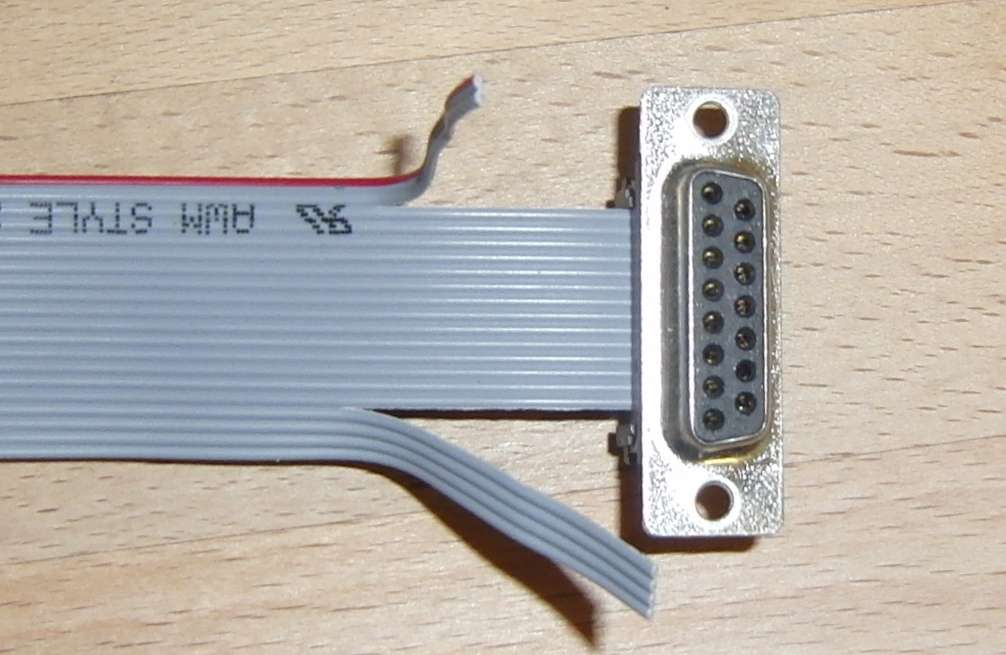
dibond/manual/d_socket.JPG
