zzorn/Mendel90/dibond/manual/electronics_assembly.png

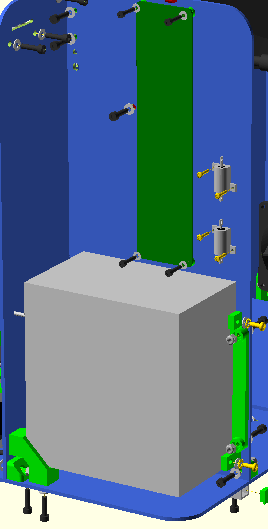
dibond/manual/electronics_assembly.png
