zzorn/Mendel90/dibond/manual/extruder_assembled.png

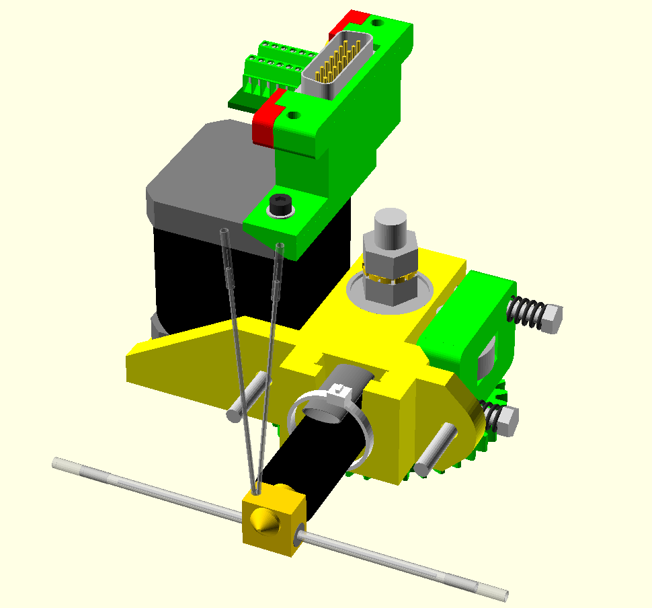
dibond/manual/extruder_assembled.png
