zzorn/Mendel90/dibond/manual/extruder_assembly.png

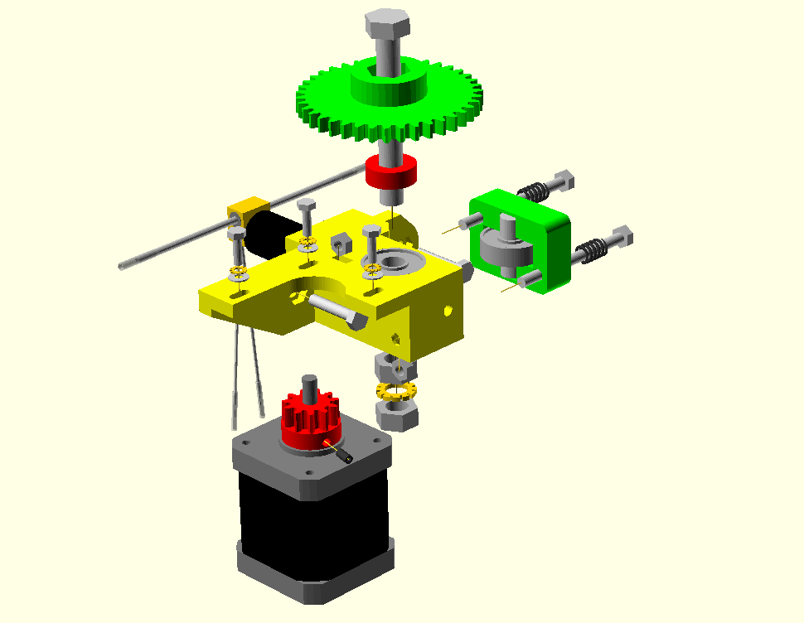
dibond/manual/extruder_assembly.png
