zzorn/Mendel90/dibond/manual/extruder_motor_assembled.png

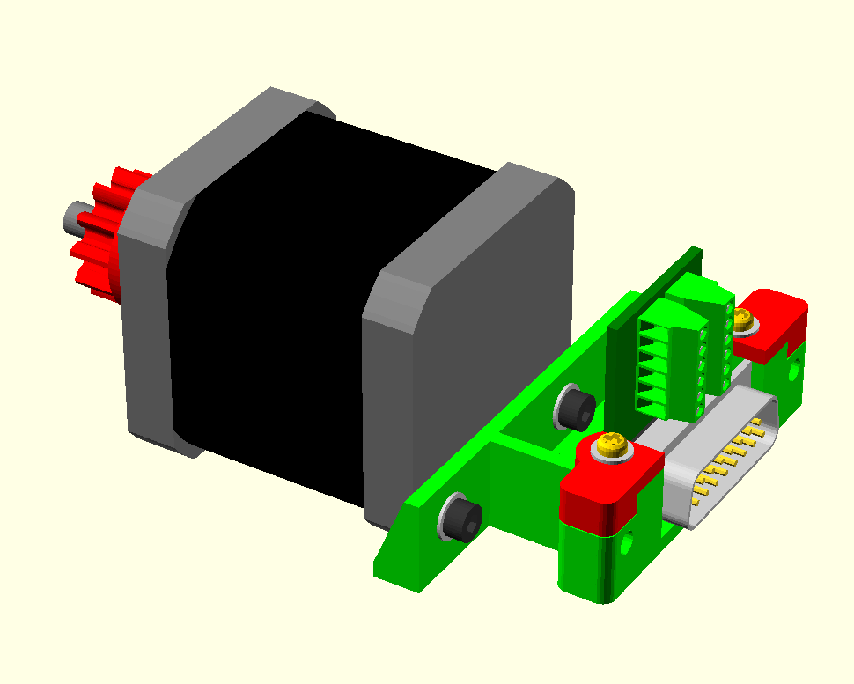
dibond/manual/extruder_motor_assembled.png
