zzorn/Mendel90/dibond/manual/extruder_motor_assembly.png

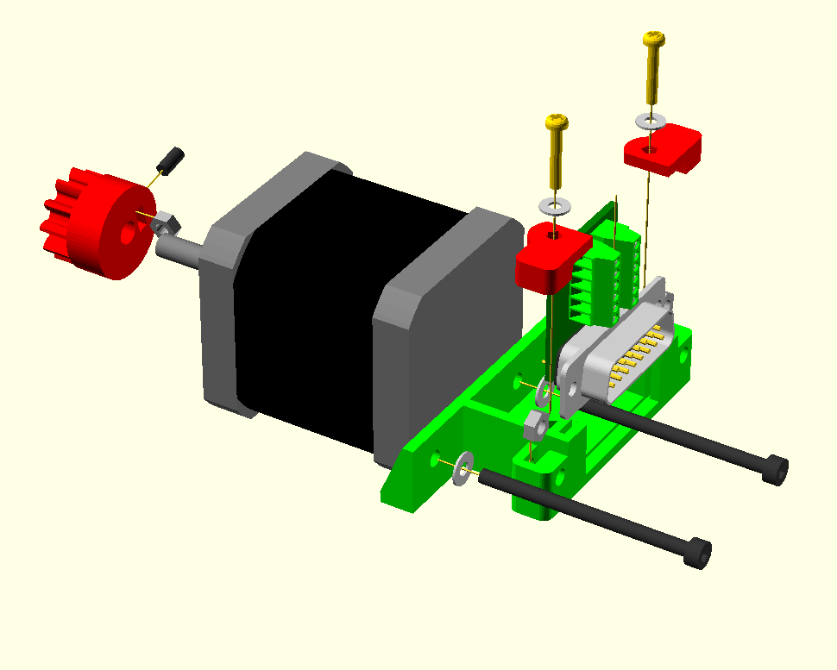
dibond/manual/extruder_motor_assembly.png
