zzorn/Mendel90/dibond/manual/frame_assembly.png

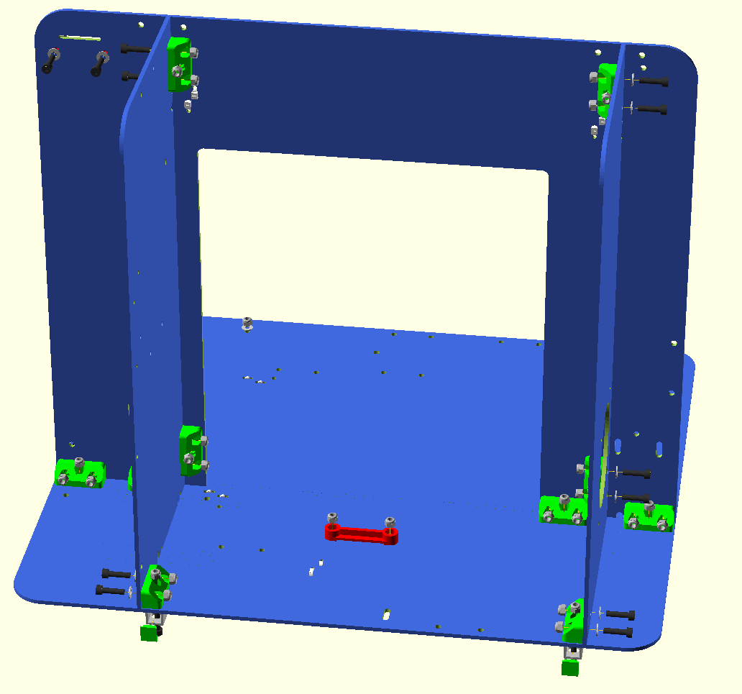
dibond/manual/frame_assembly.png
