zzorn/Mendel90/dibond/manual/frame_assembly_bar_front.png

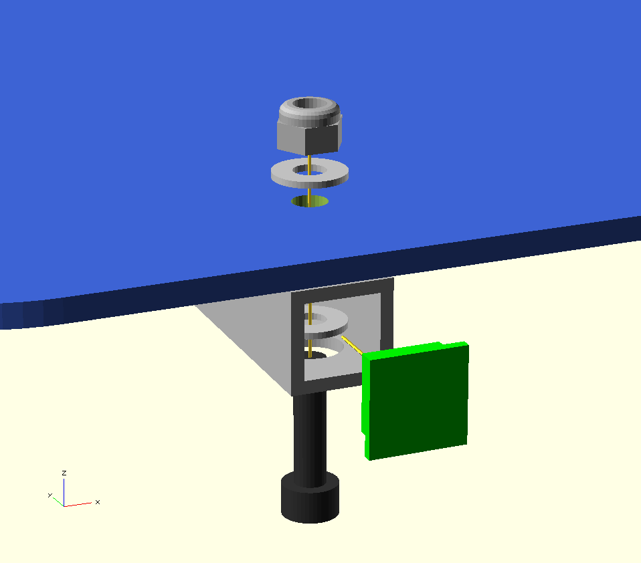
dibond/manual/frame_assembly_bar_front.png
