zzorn/Mendel90/dibond/manual/frame_assembly_front.png

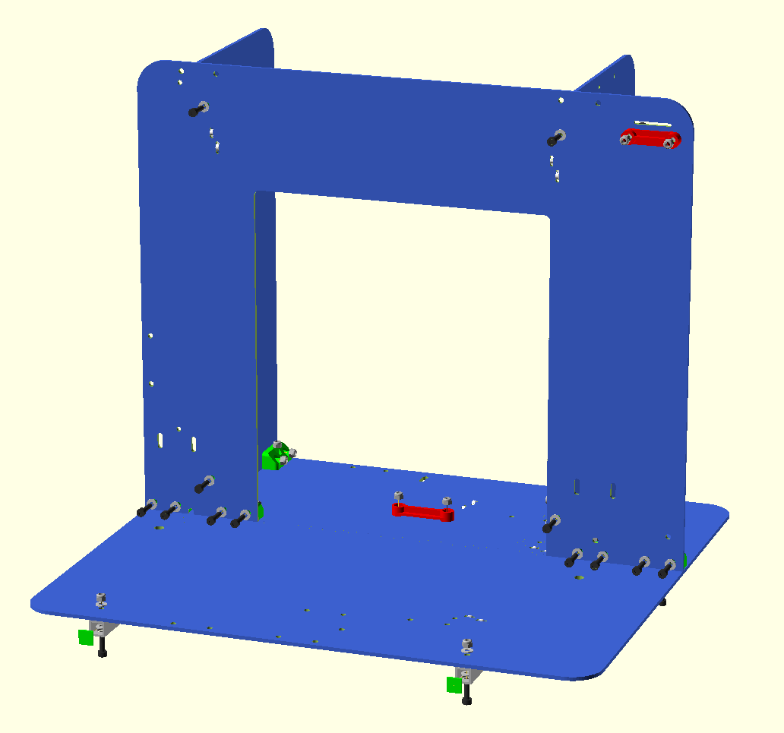
dibond/manual/frame_assembly_front.png
