zzorn/Mendel90/dibond/manual/front_page.png

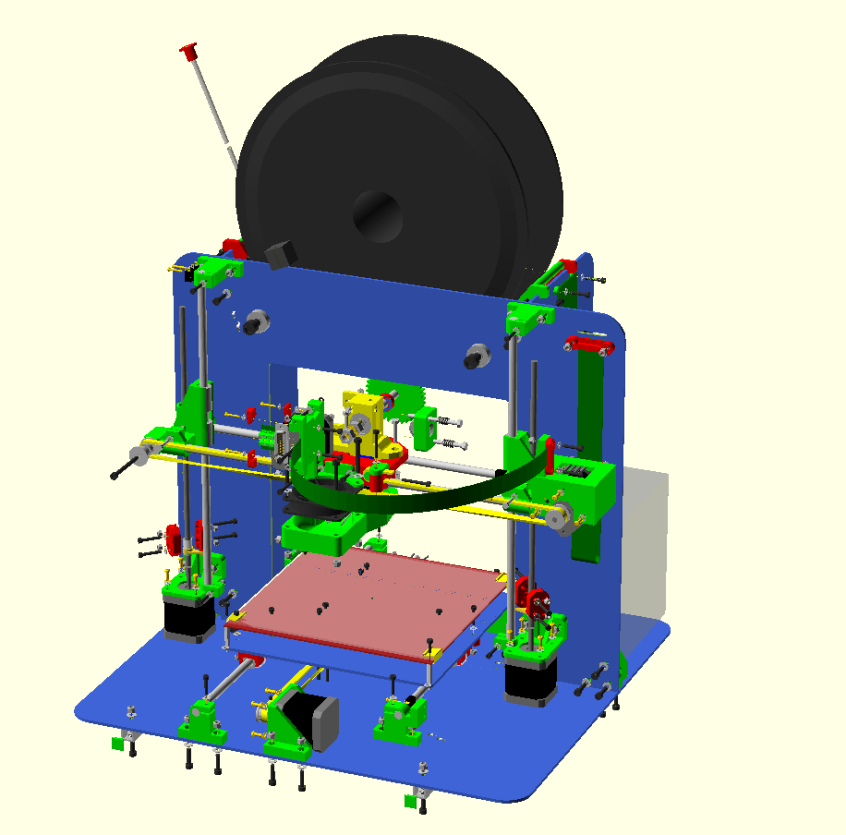
dibond/manual/front_page.png
