zzorn/Mendel90/dibond/manual/head_sheild_tape.JPG

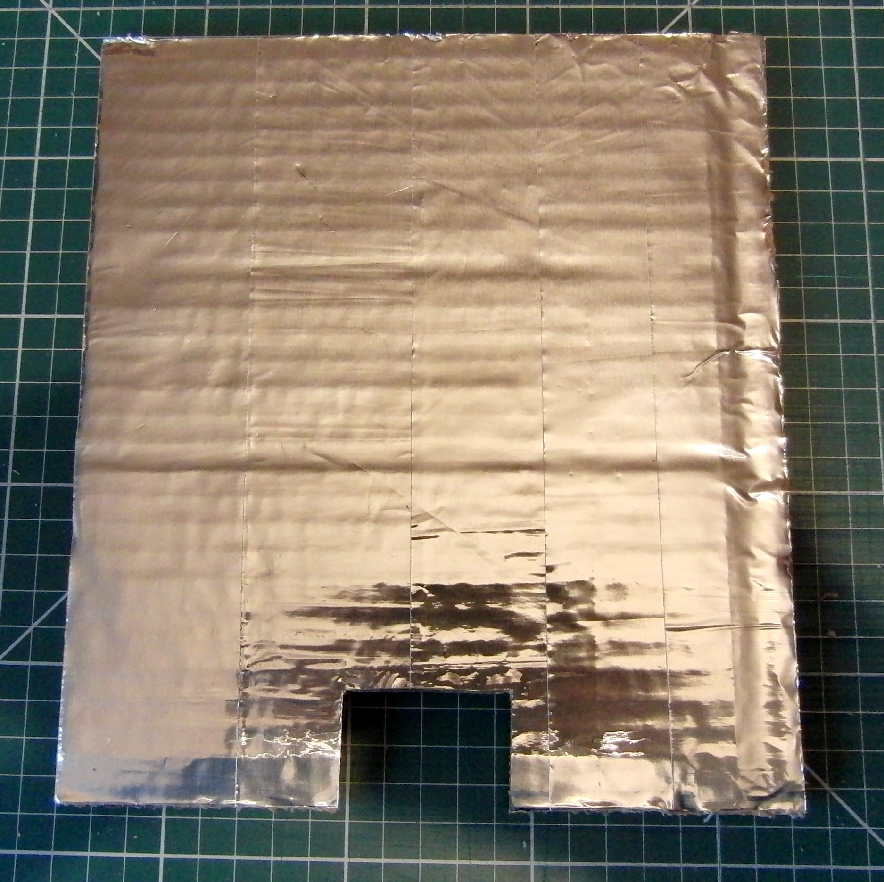
dibond/manual/head_sheild_tape.JPG
