zzorn/Mendel90/dibond/manual/heat_sheild_cut.JPG

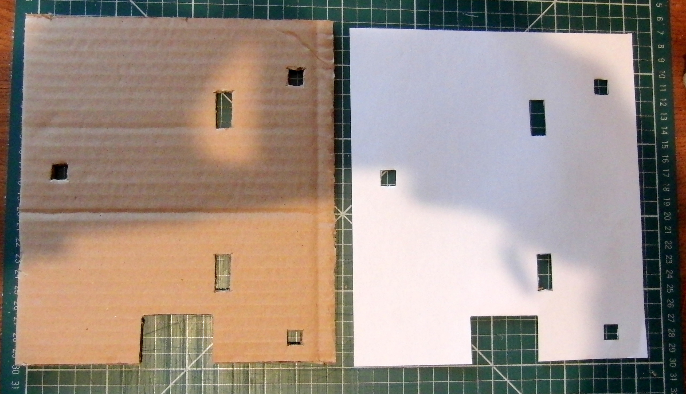
dibond/manual/heat_sheild_cut.JPG
