zzorn/Mendel90/dibond/manual/hot_end.JPG

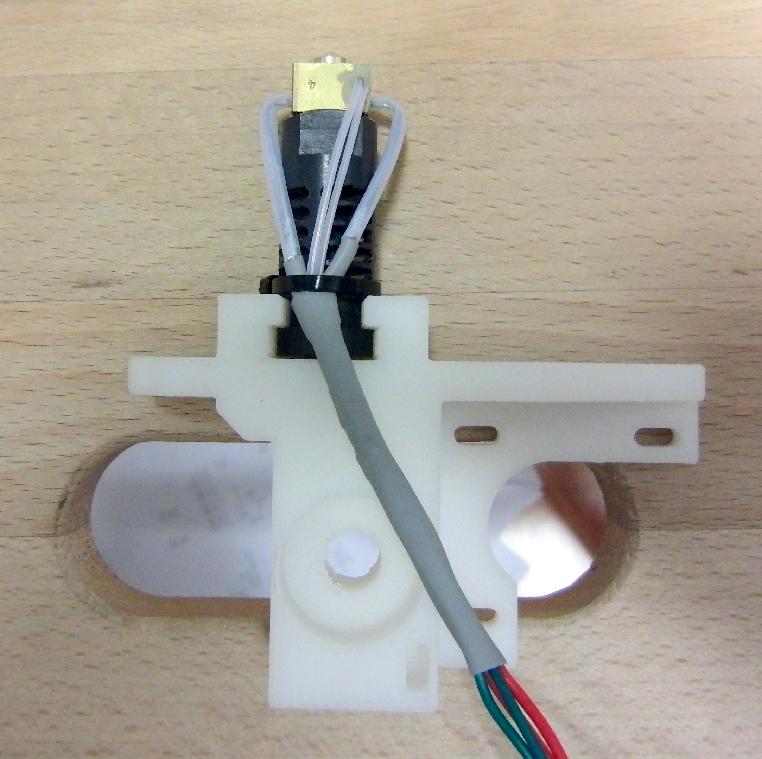
dibond/manual/hot_end.JPG
