zzorn/Mendel90/dibond/manual/hot_end_assembly.png

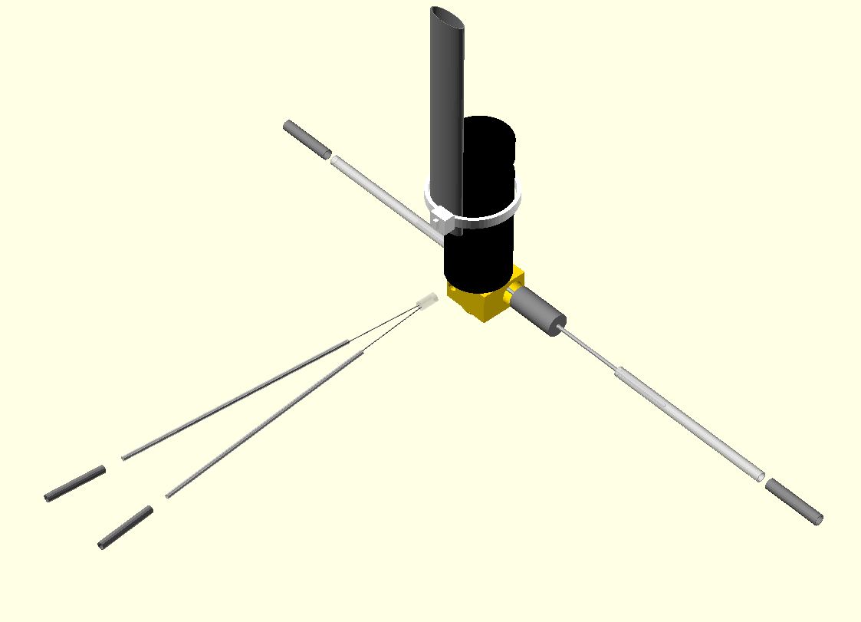
dibond/manual/hot_end_assembly.png
