zzorn/Mendel90/dibond/manual/machine_assembly.png

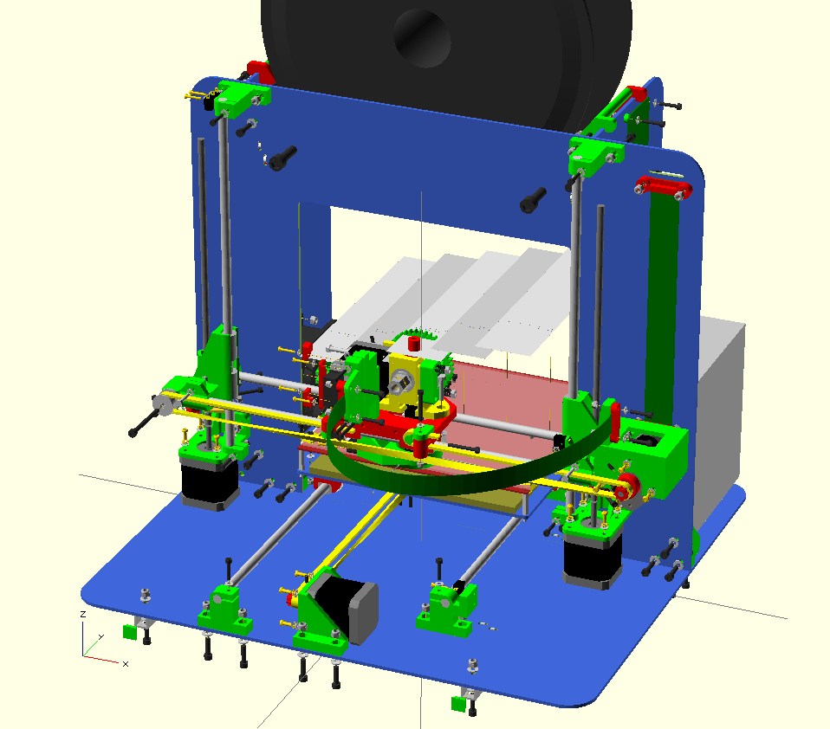
dibond/manual/machine_assembly.png
