zzorn/Mendel90/dibond/manual/melzi.JPG

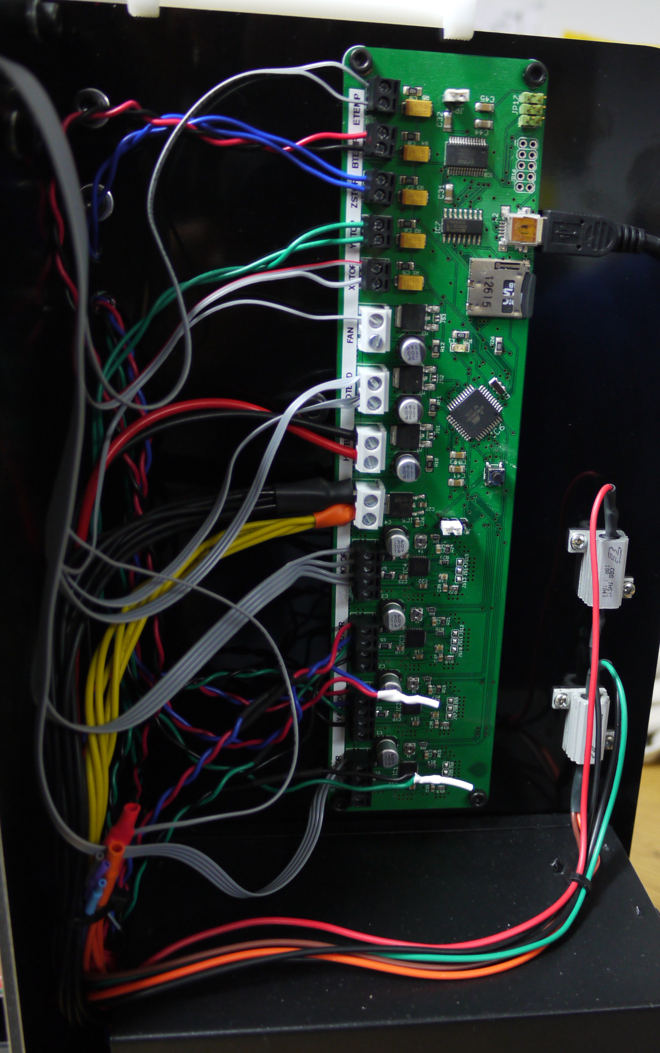
dibond/manual/melzi.JPG
