zzorn/Mendel90/dibond/manual/melzi_wires.jpg

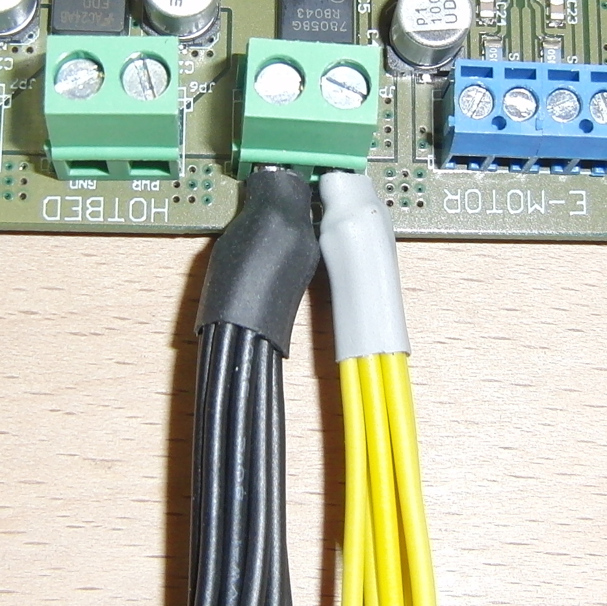
dibond/manual/melzi_wires.jpg
