zzorn/Mendel90/dibond/manual/print_bed_assembly.png

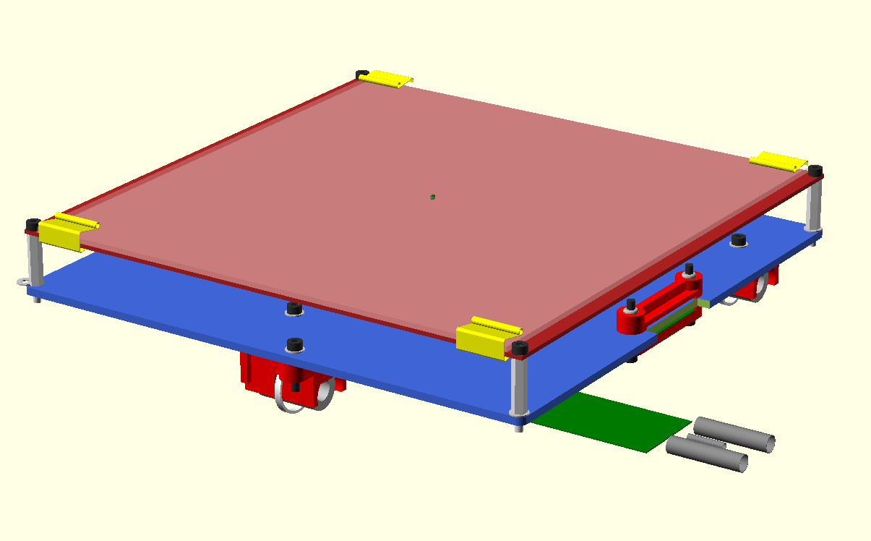
dibond/manual/print_bed_assembly.png
