zzorn/Mendel90/dibond/manual/PSU.JPG

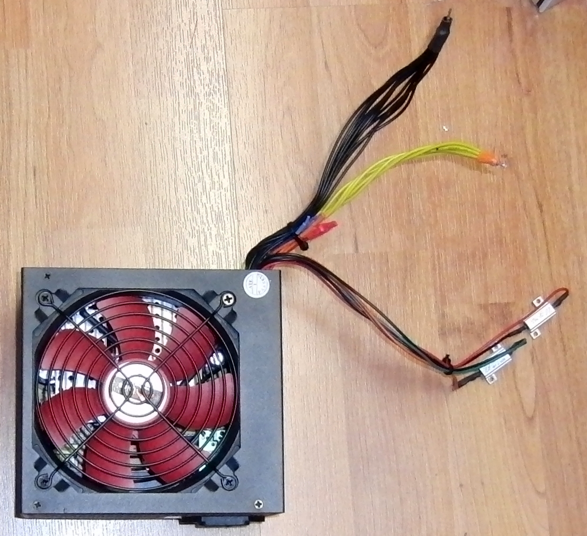
dibond/manual/PSU.JPG
