zzorn/Mendel90/dibond/manual/psu_assembly.png

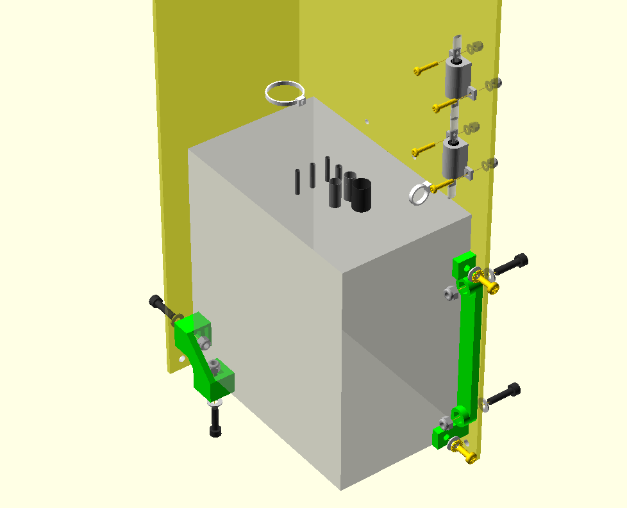
dibond/manual/psu_assembly.png
