zzorn/Mendel90/dibond/manual/sleeved_wires.JPG

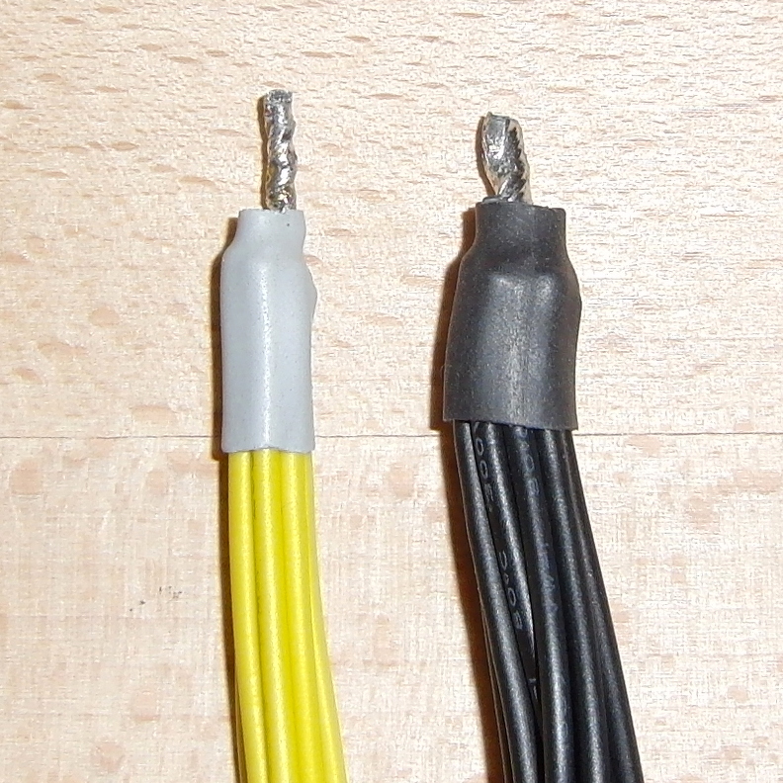
dibond/manual/sleeved_wires.JPG
