zzorn/Mendel90/dibond/manual/spool_holder_assembly.png

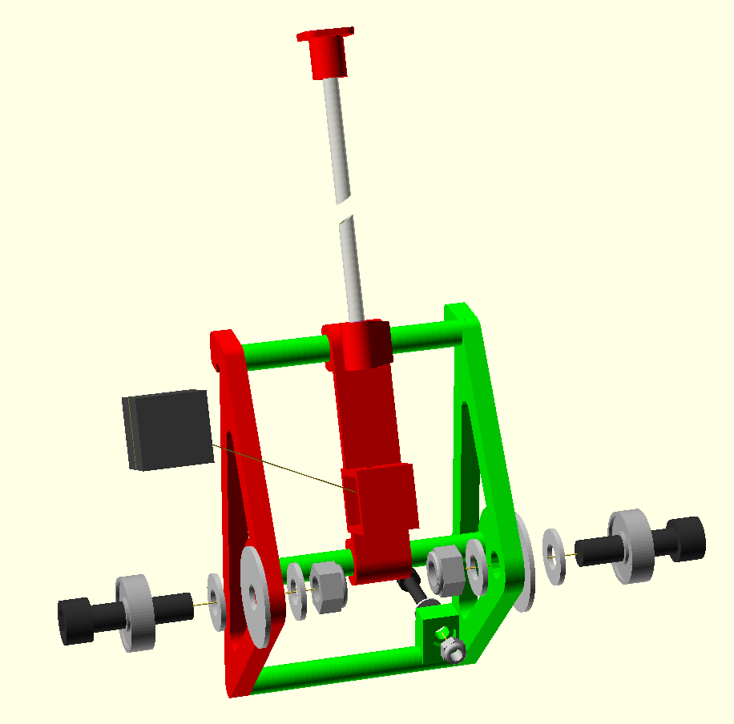
dibond/manual/spool_holder_assembly.png
