zzorn/Mendel90/dibond/manual/tinned_wires.JPG

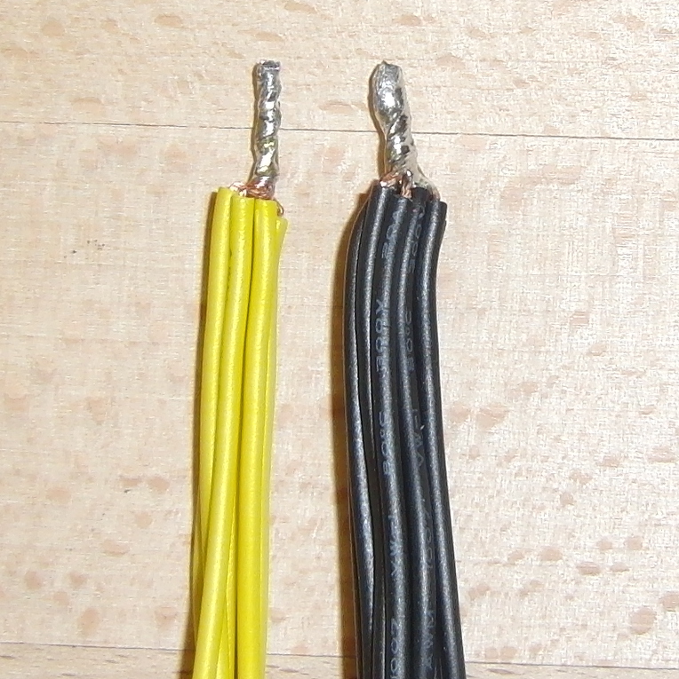
dibond/manual/tinned_wires.JPG
