zzorn/Mendel90/dibond/manual/x_axis_assembly.png

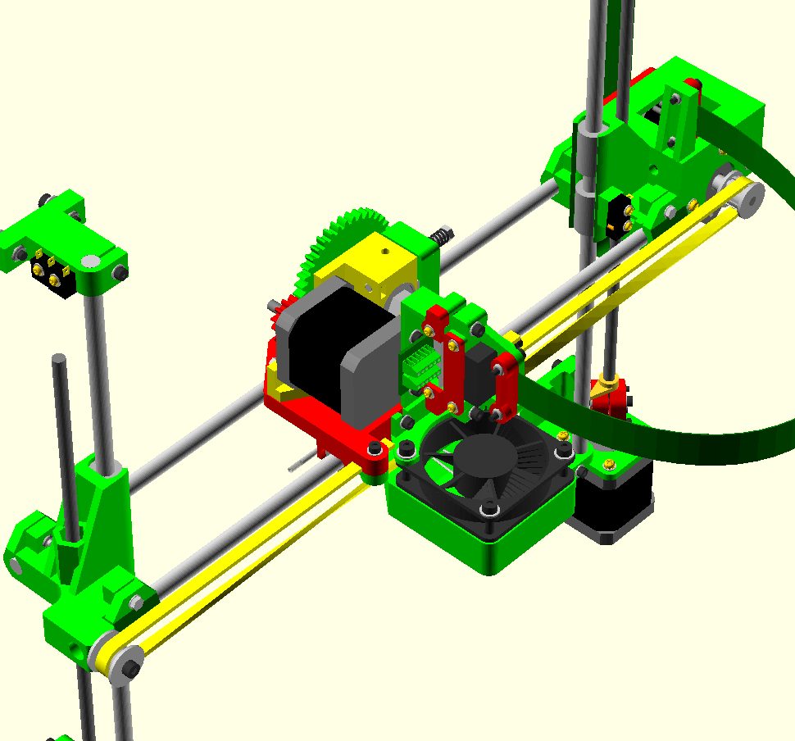
dibond/manual/x_axis_assembly.png
