zzorn/Mendel90/dibond/manual/x_carriage_assembled.png

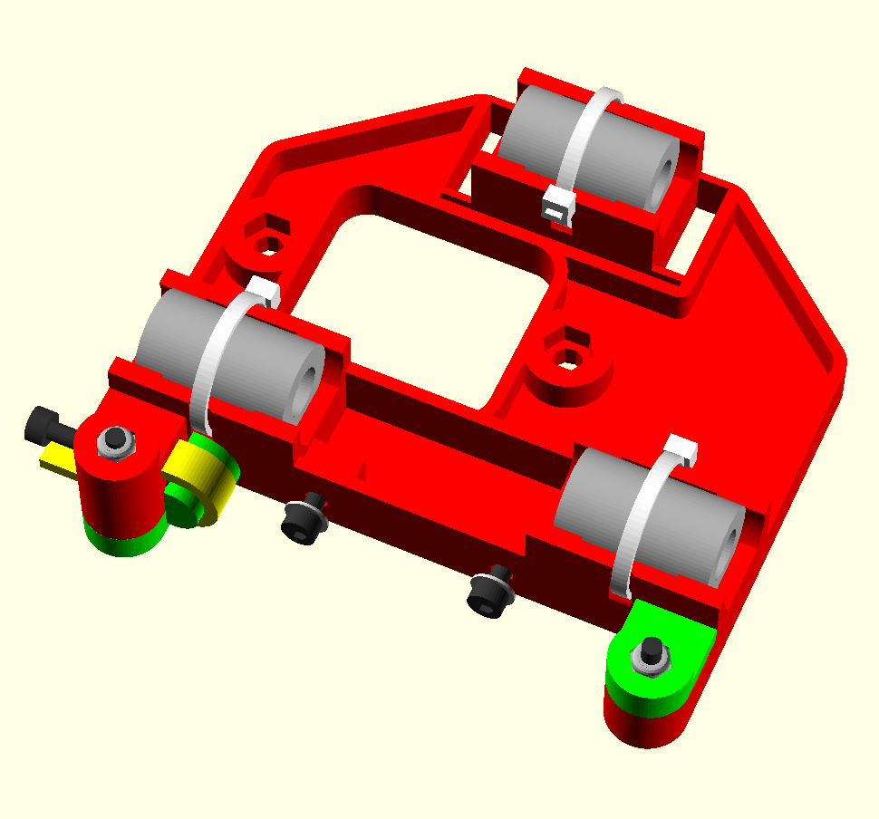
dibond/manual/x_carriage_assembled.png
