zzorn/Mendel90/dibond/manual/x_carriage_assembly.png

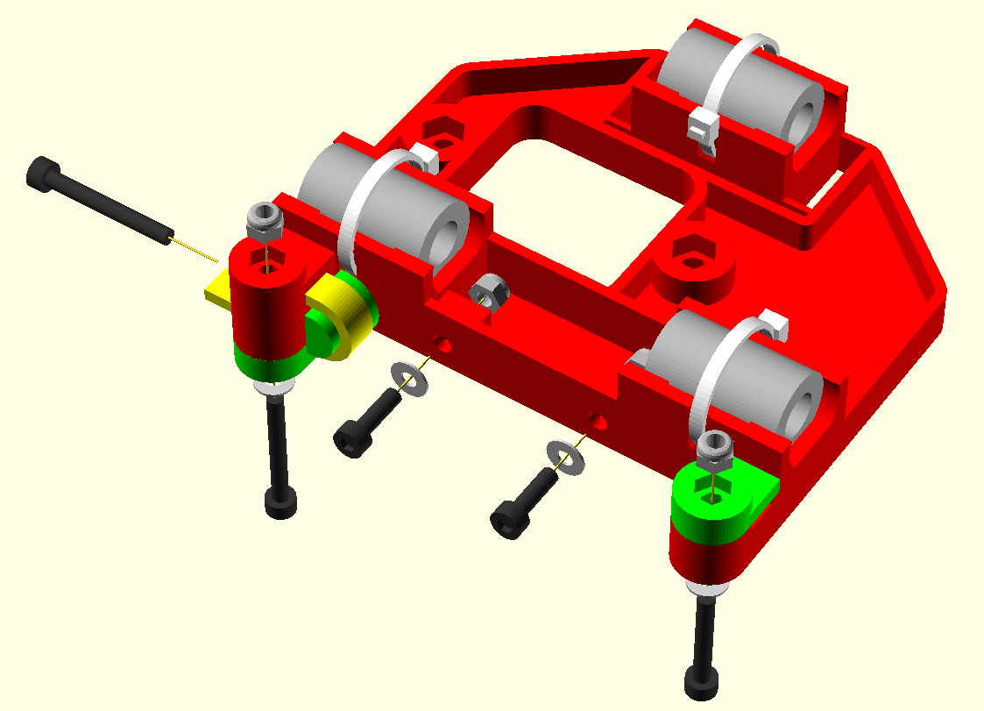
dibond/manual/x_carriage_assembly.png
