zzorn/Mendel90/dibond/manual/x_carriage_fan_assembled.png

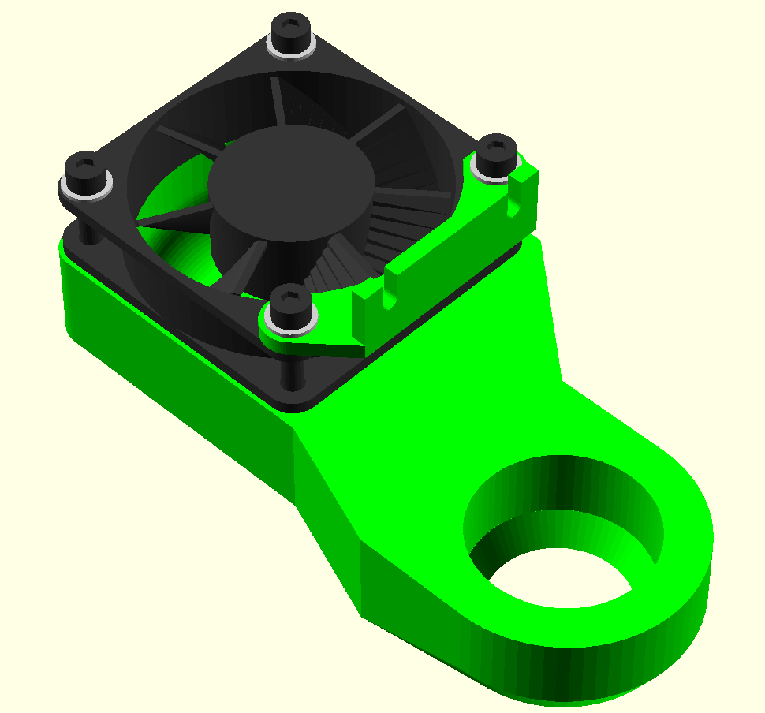
dibond/manual/x_carriage_fan_assembled.png
