zzorn/Mendel90/dibond/manual/x_carriage_fan_assembly.png

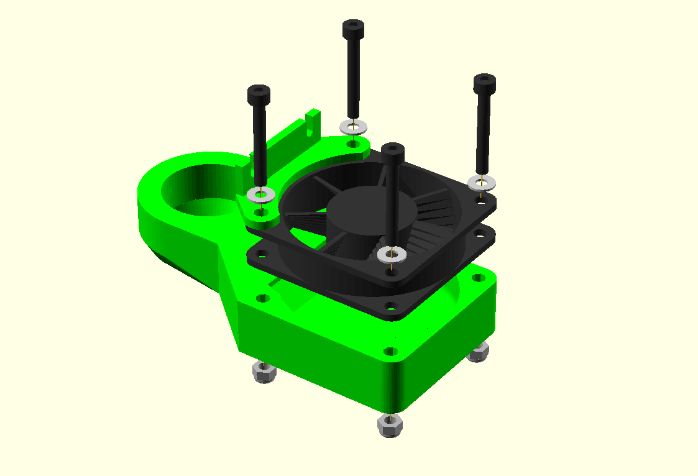
dibond/manual/x_carriage_fan_assembly.png
