zzorn/Mendel90/dibond/manual/x_end_wiring.JPG

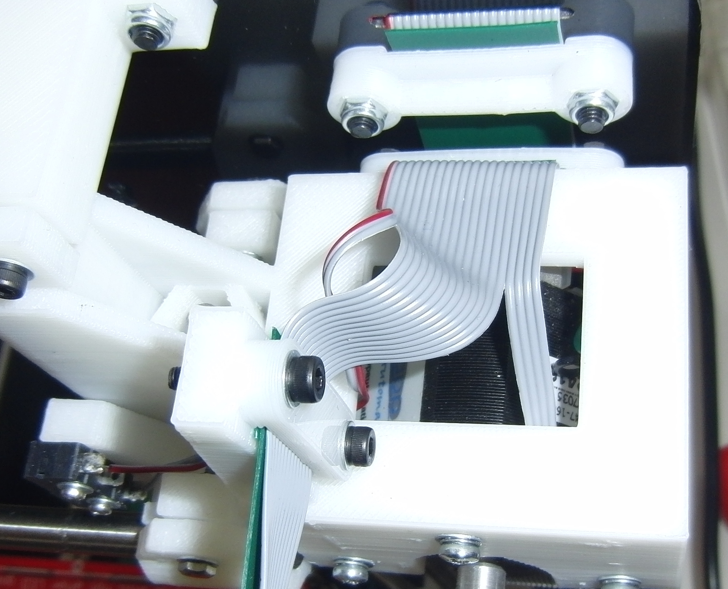
dibond/manual/x_end_wiring.JPG
