zzorn/Mendel90/dibond/manual/x_idler_assembly.png

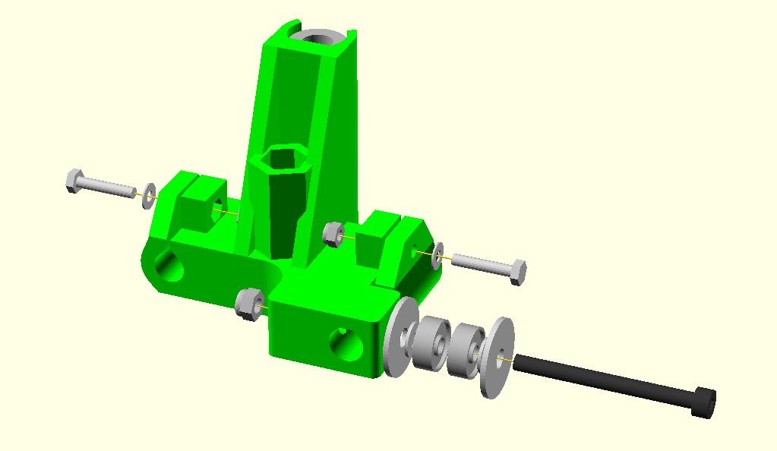
dibond/manual/x_idler_assembly.png
