zzorn/Mendel90/dibond/manual/x_motor_assembled.png

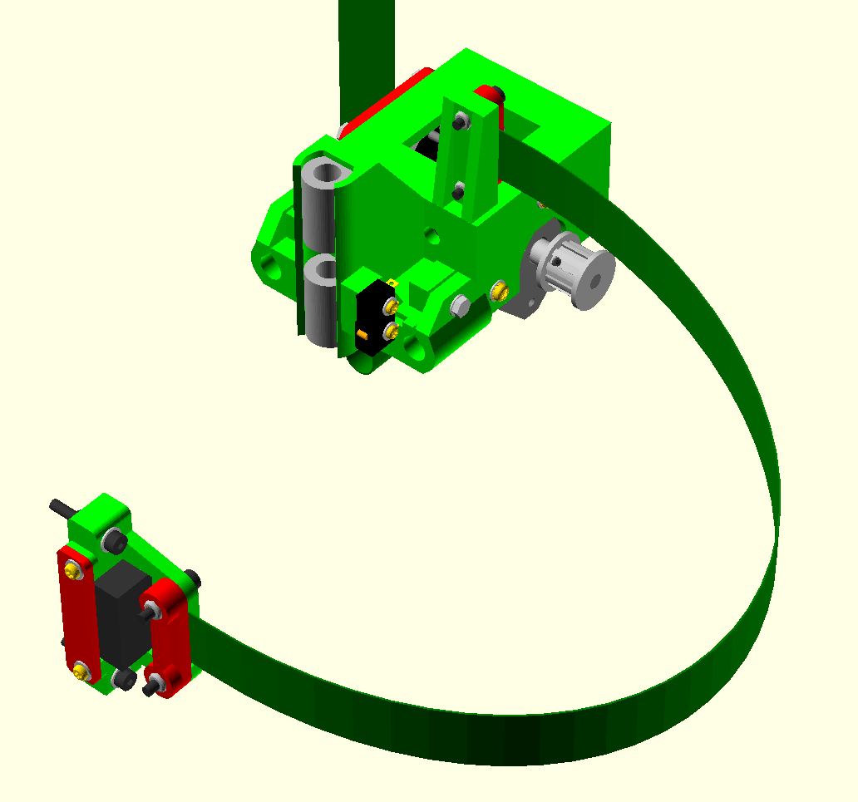
dibond/manual/x_motor_assembled.png
