zzorn/Mendel90/dibond/manual/x_motor_assembly.png

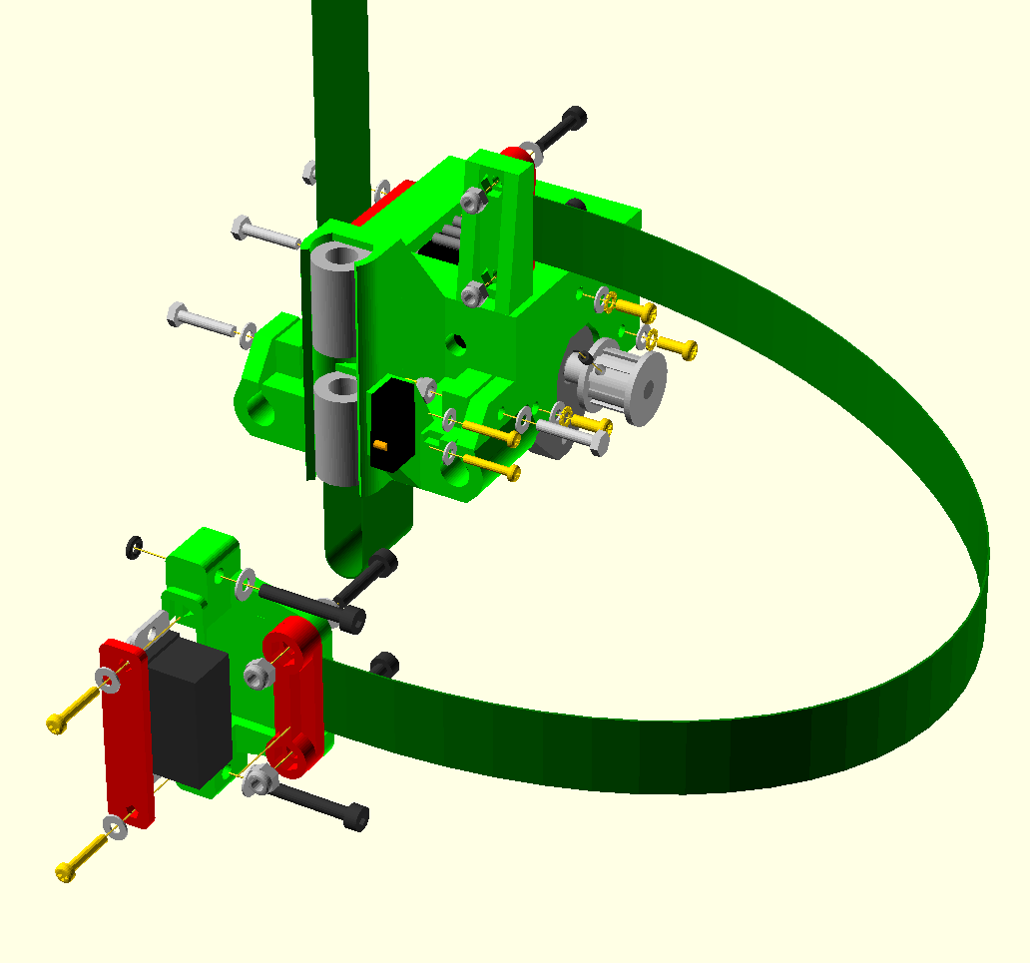
dibond/manual/x_motor_assembly.png
