zzorn/Mendel90/dibond/manual/y_axis_assembly.png

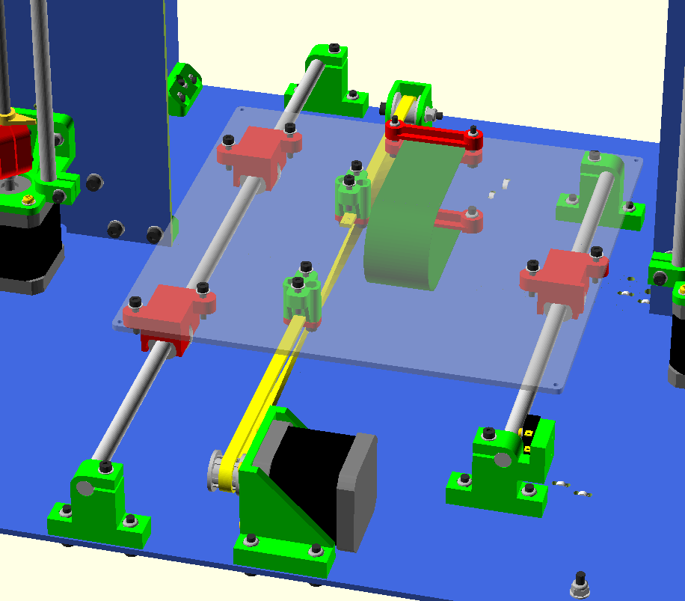
dibond/manual/y_axis_assembly.png
