zzorn/Mendel90/dibond/manual/y_carriage_assembled.png

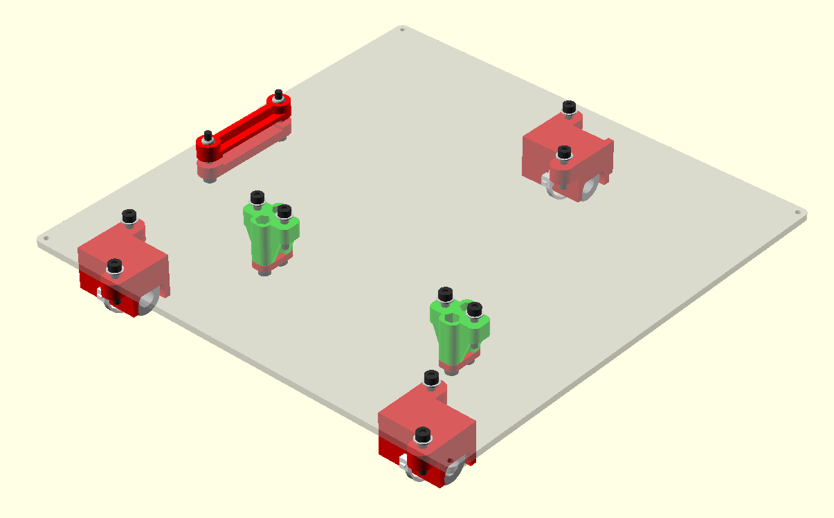
dibond/manual/y_carriage_assembled.png
