zzorn/Mendel90/dibond/manual/y_carriage_assembly.png

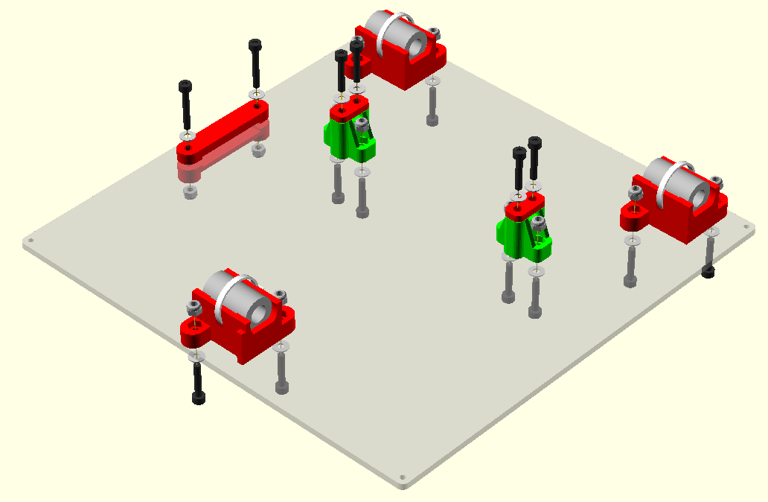
dibond/manual/y_carriage_assembly.png
