zzorn/Mendel90/dibond/manual/y_heatshield_assembly.png

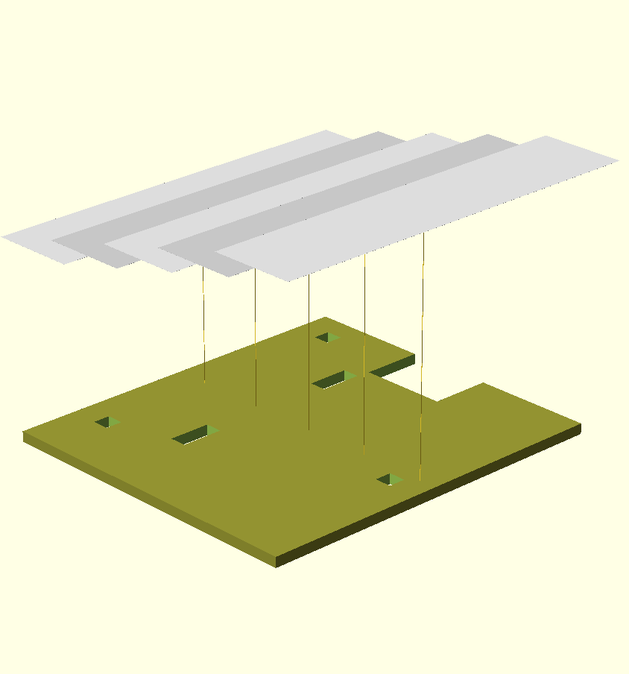
dibond/manual/y_heatshield_assembly.png
