zzorn/Mendel90/dibond/manual/y_idler_assembled.png

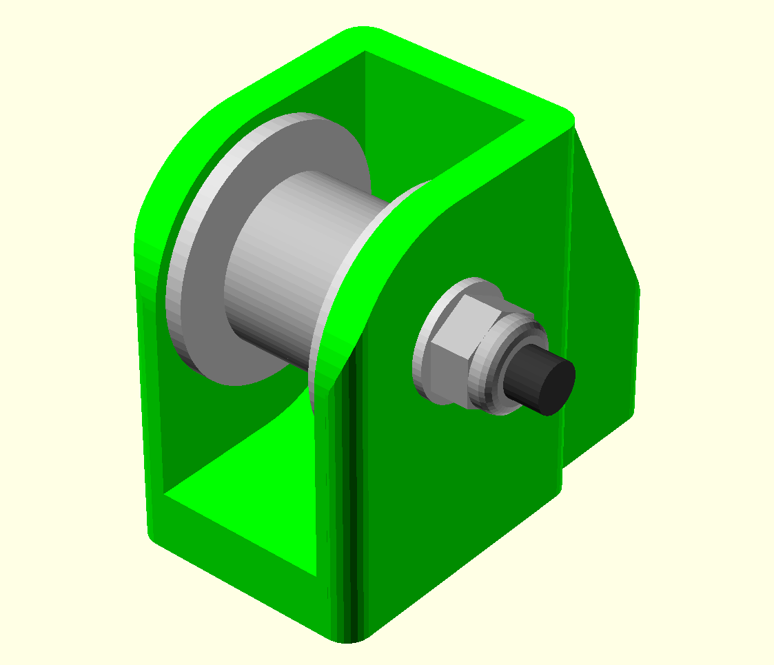
dibond/manual/y_idler_assembled.png
