zzorn/Mendel90/dibond/manual/y_idler_assembly.png

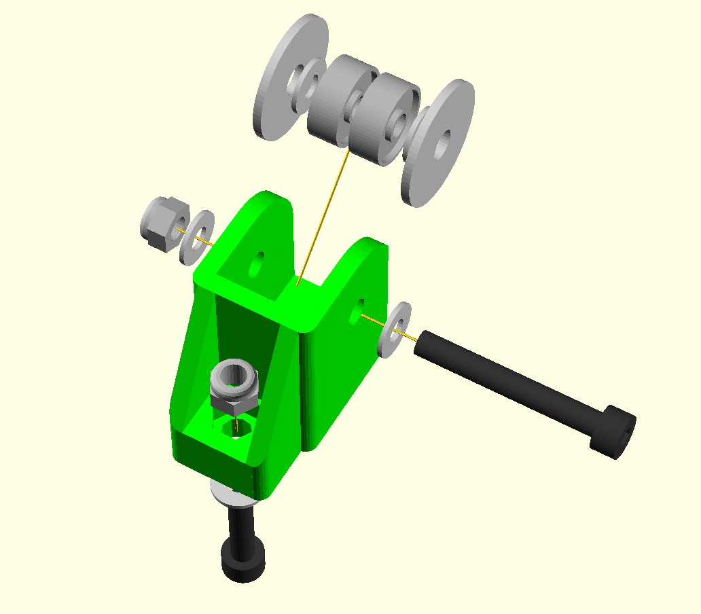
dibond/manual/y_idler_assembly.png
