zzorn/Mendel90/dibond/manual/y_motor_assembled.png

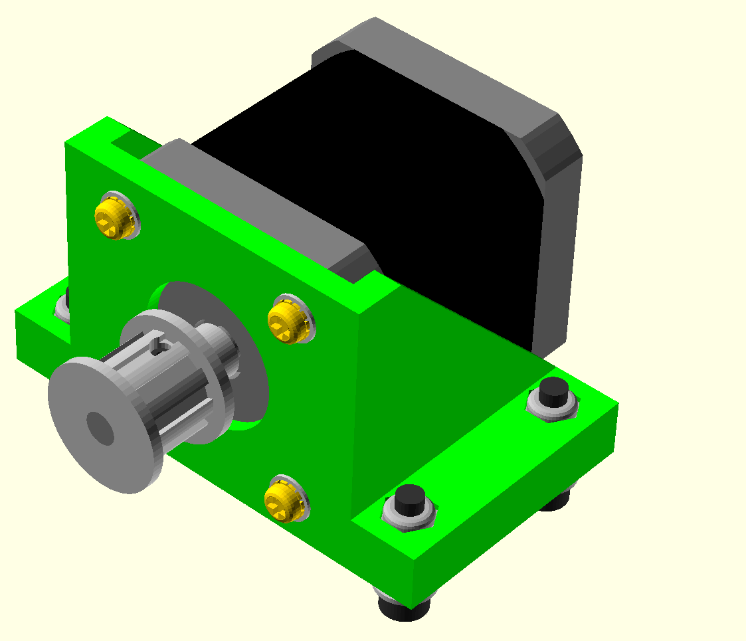
dibond/manual/y_motor_assembled.png
