zzorn/Mendel90/dibond/manual/y_motor_assembly.png

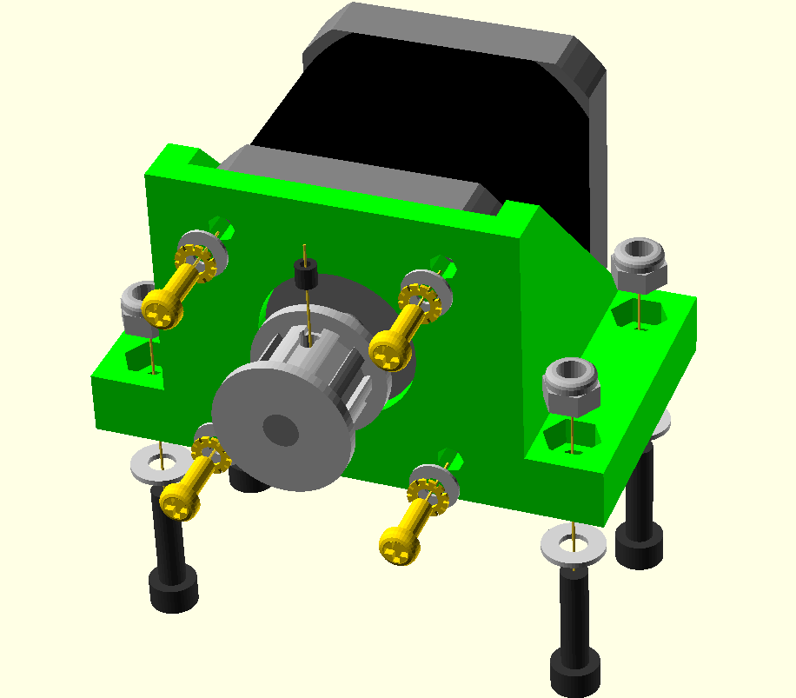
dibond/manual/y_motor_assembly.png
