zzorn/Mendel90/dibond/manual/z_axis_assembly.png

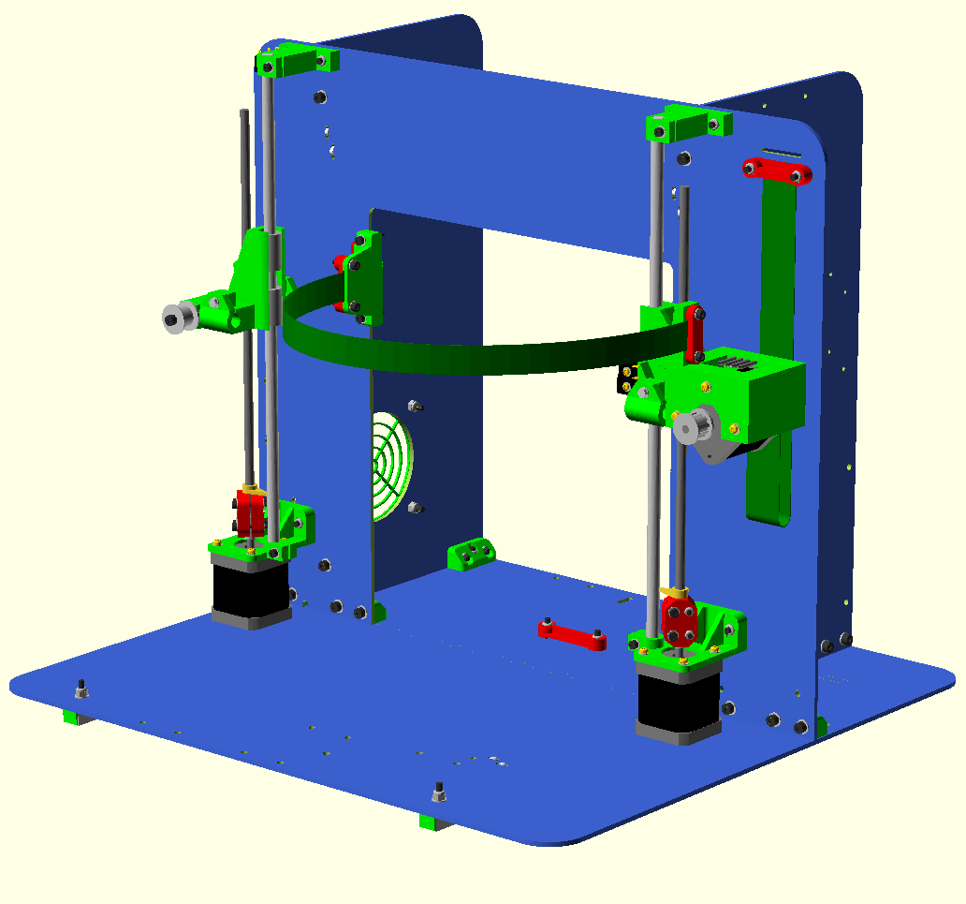
dibond/manual/z_axis_assembly.png
