zzorn/Mendel90/dibond/manual/z_motor_assembled.png

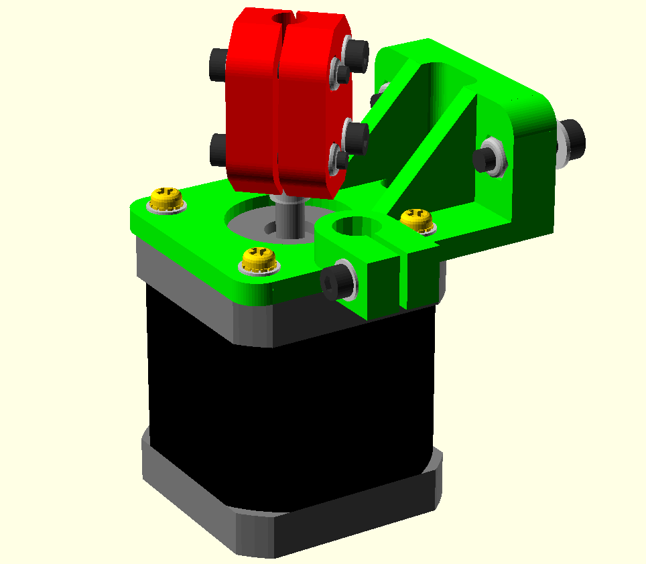
dibond/manual/z_motor_assembled.png
