zzorn/Mendel90/dibond/manual/z_motor_assembly.png

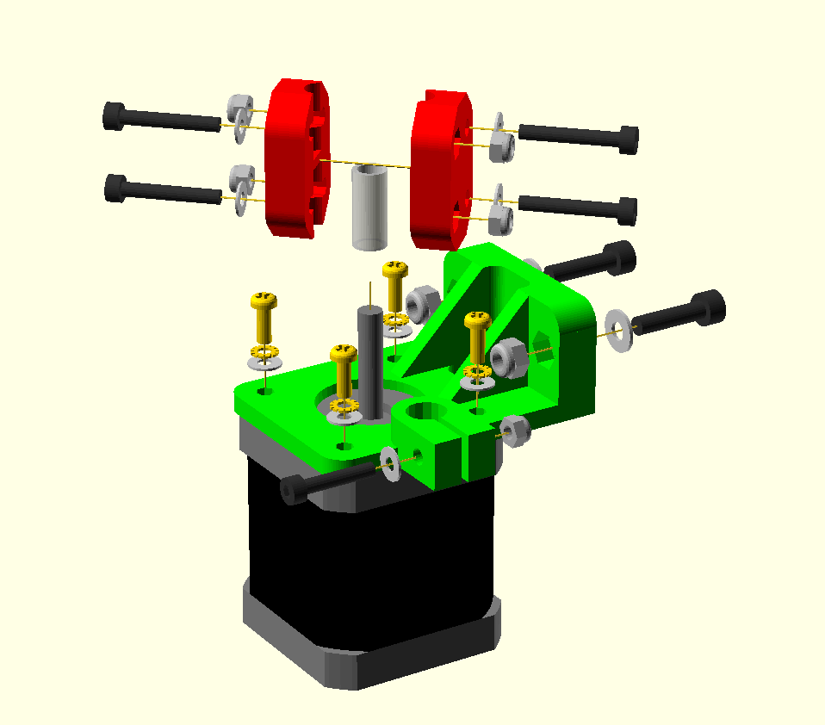
dibond/manual/z_motor_assembly.png
