zzorn/Mendel90/dibond/render/printed/atx_brackets.png

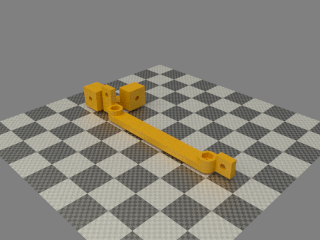
dibond/render/printed/atx_brackets.png
