zzorn/Mendel90/dibond/render/printed/bar_clamps.png

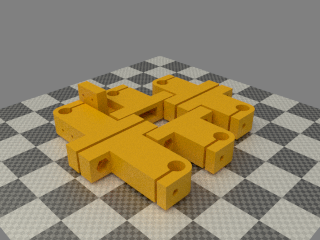
dibond/render/printed/bar_clamps.png
