zzorn/Mendel90/dibond/render/printed/cal.png

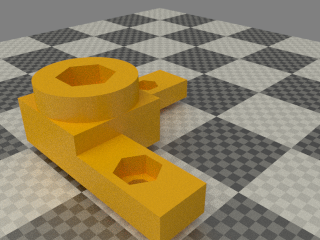
dibond/render/printed/cal.png
