zzorn/Mendel90/dibond/render/printed/d_motor_brackets.png

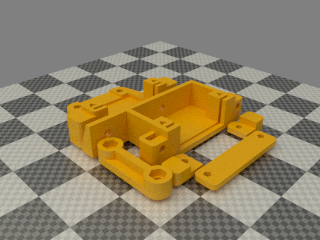
dibond/render/printed/d_motor_brackets.png
