zzorn/Mendel90/dibond/render/printed/fixing_blocks.png

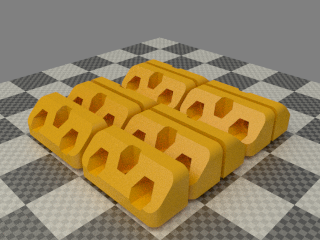
dibond/render/printed/fixing_blocks.png
