zzorn/Mendel90/dibond/render/printed/ribbon_clamps.png

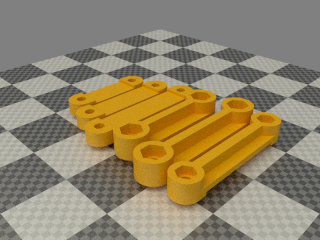
dibond/render/printed/ribbon_clamps.png
