zzorn/Mendel90/dibond/render/printed/spool_holder_tall_brackets.png

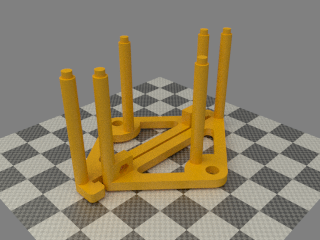
dibond/render/printed/spool_holder_tall_brackets.png
