zzorn/Mendel90/dibond/render/printed/y_bearing_mounts.png

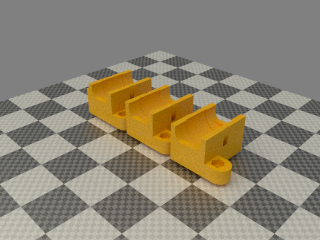
dibond/render/printed/y_bearing_mounts.png
