zzorn/Mendel90/dibond/render/printed/y_belt_anchors.png

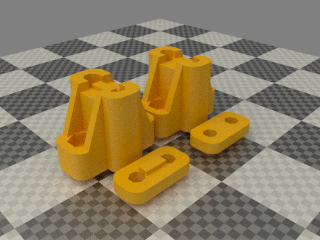
dibond/render/printed/y_belt_anchors.png
