zzorn/Mendel90/dibond/render/printed/z_motor_brackets.png

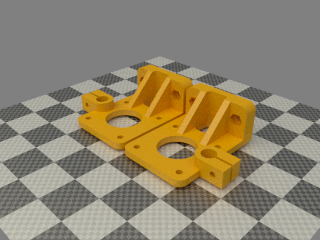
dibond/render/printed/z_motor_brackets.png
