zzorn/Mendel90/mendel/render/printed/fixing_blocks.png

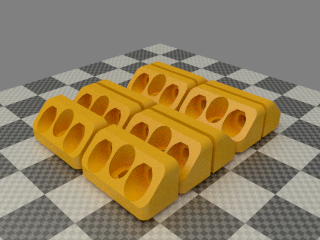
mendel/render/printed/fixing_blocks.png
