zzorn/Mendel90/mendel/render/printed/ribbon_clamps.png

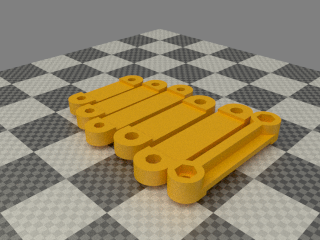
mendel/render/printed/ribbon_clamps.png
