zzorn/Mendel90/mendel/render/printed/spool_holder_tall_brackets.png

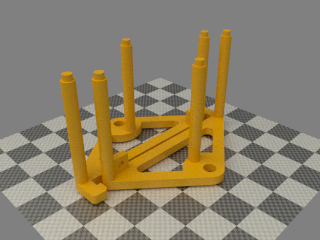
mendel/render/printed/spool_holder_tall_brackets.png
