zzorn/Mendel90/mendel/render/printed/y_bearing_mounts.png

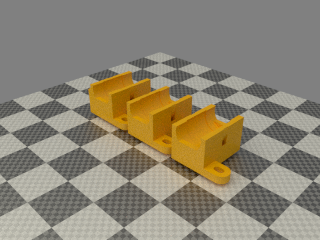
mendel/render/printed/y_bearing_mounts.png
