zzorn/Mendel90/sturdy/render/printed/atx_brackets.png

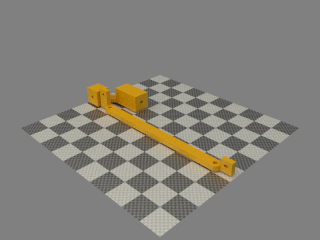
sturdy/render/printed/atx_brackets.png
