zzorn/Mendel90/sturdy/render/printed/bar_clamps.png

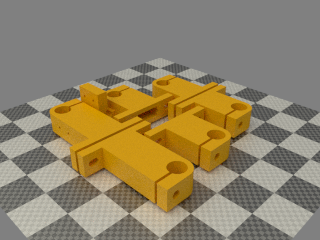
sturdy/render/printed/bar_clamps.png
