zzorn/Mendel90/sturdy/render/printed/y_bearing_mounts.png

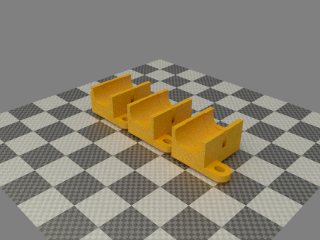
sturdy/render/printed/y_bearing_mounts.png
