zzorn/Mendel90/sturdy/render/printed/z_motor_brackets.png

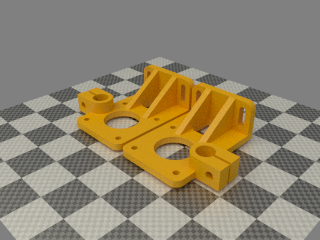
sturdy/render/printed/z_motor_brackets.png
