zzorn/Mendel90/sturdy-a4/sheets/frame_base.pdf

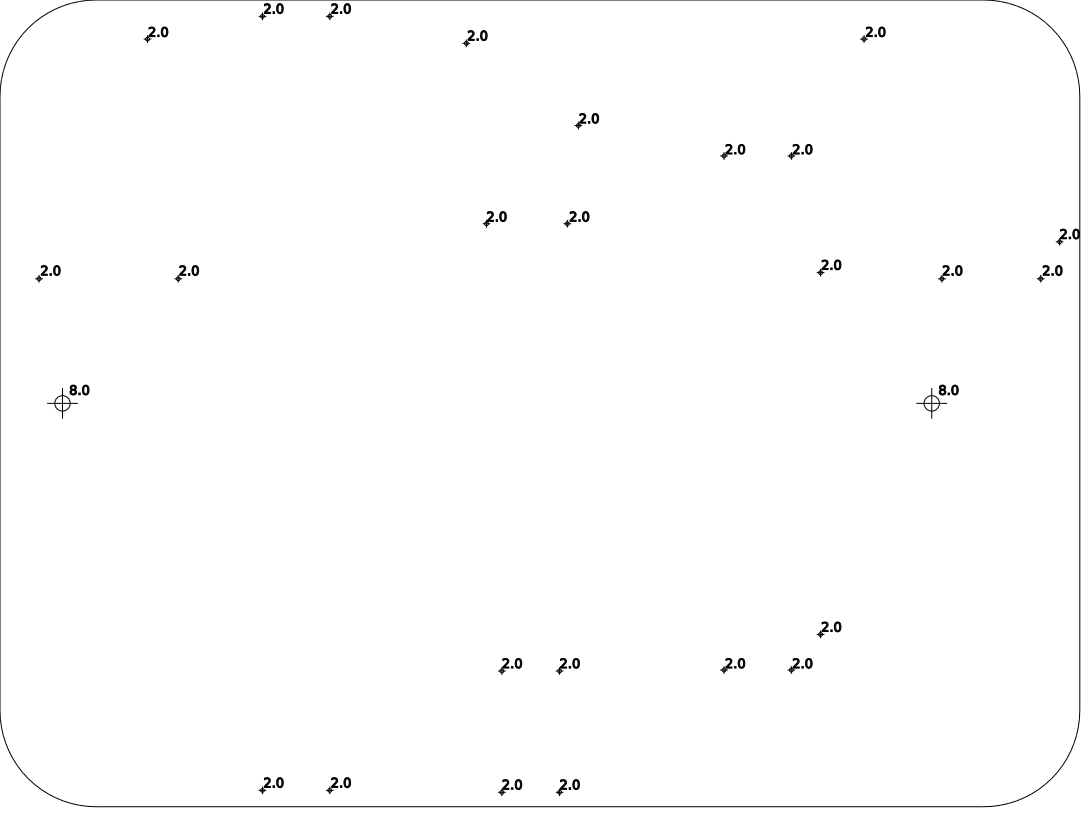
[picture p244: page 1]
