zzorn/Mendel90/sturdy-a4/sheets/frame_gantry.pdf

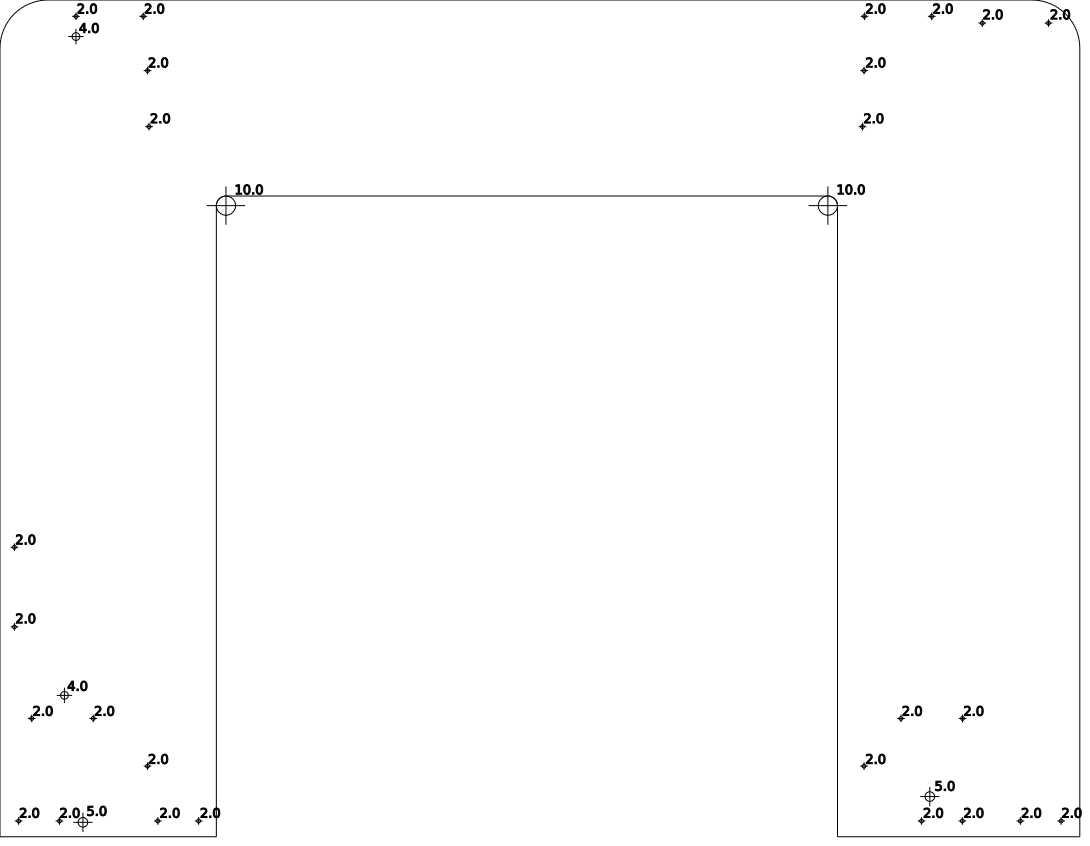
[picture p245: page 1]
