zzorn/Mendel90/sturdy-a4/sheets/frame_gantry_and_y_carriage.pdf

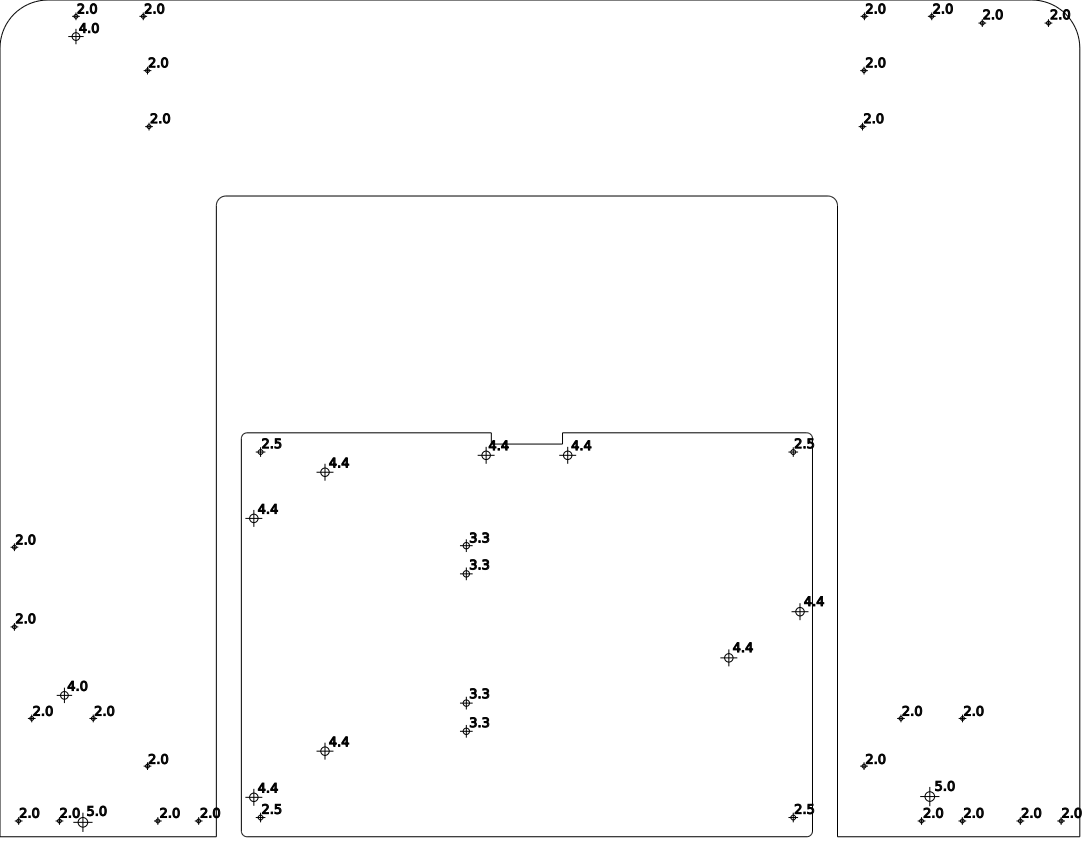
[picture p246: page 1]
