zzorn/Mendel90/sturdy-a4/sheets/frame_left.pdf

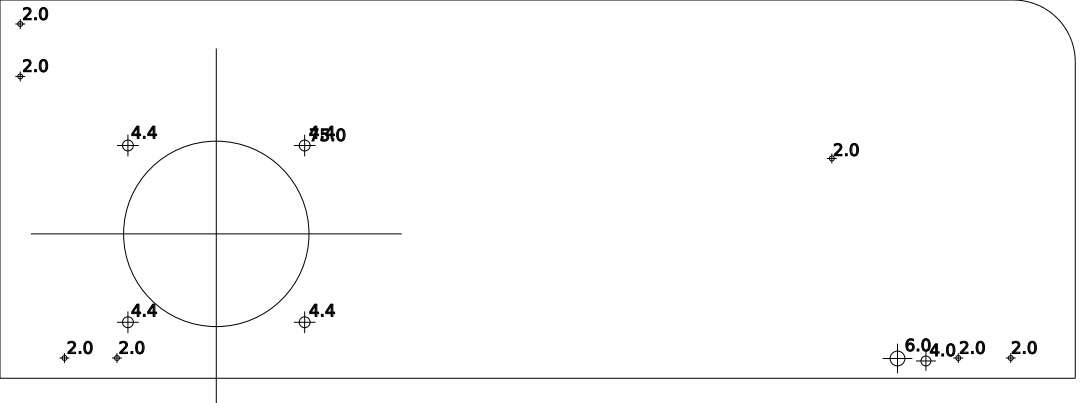
[picture p247: page 1]
