zzorn/Mendel90/sturdy-a4/sheets/frame_right.pdf

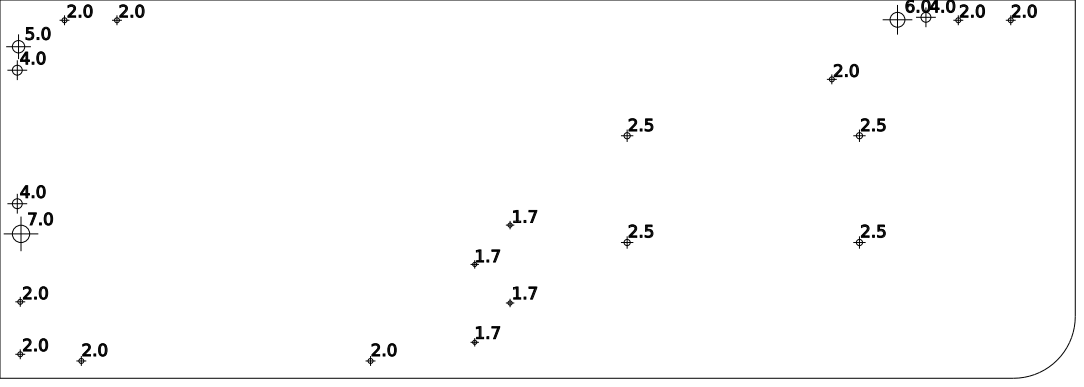
[picture p248: page 1]
