zzorn/Mendel90/sturdy-a4/sheets/frame_stays.pdf

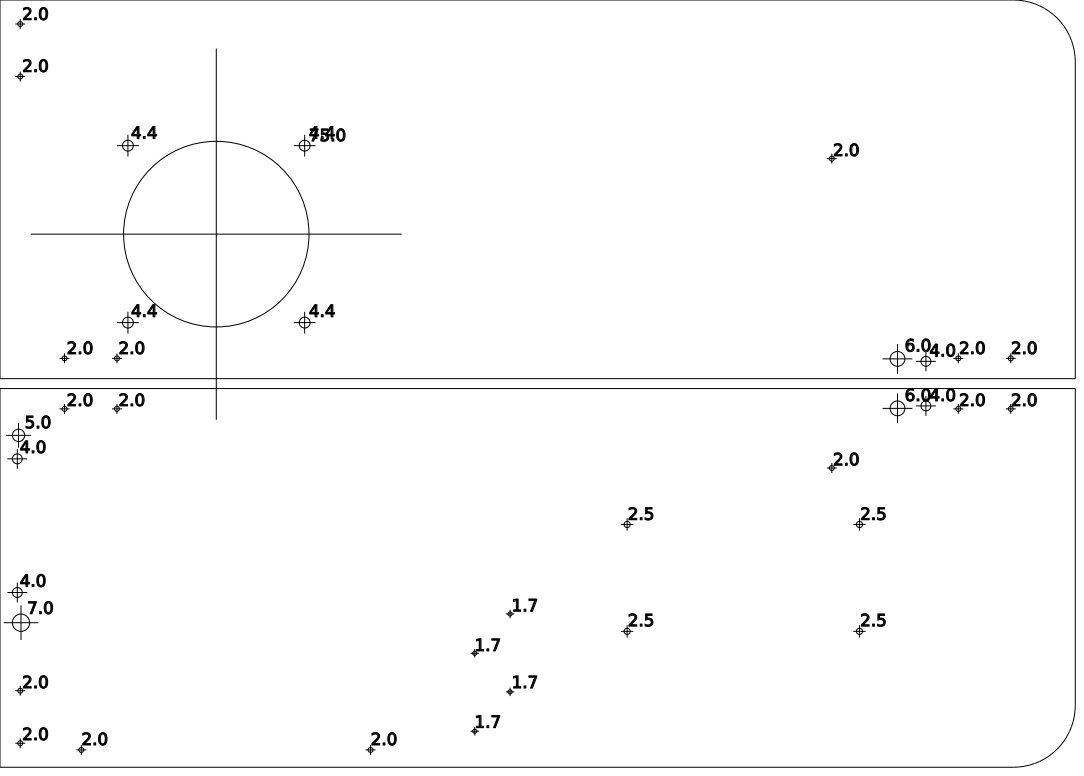
[picture p249: page 1]
