zzorn/Mendel90/sturdy-a4/sheets/y_carriage.pdf

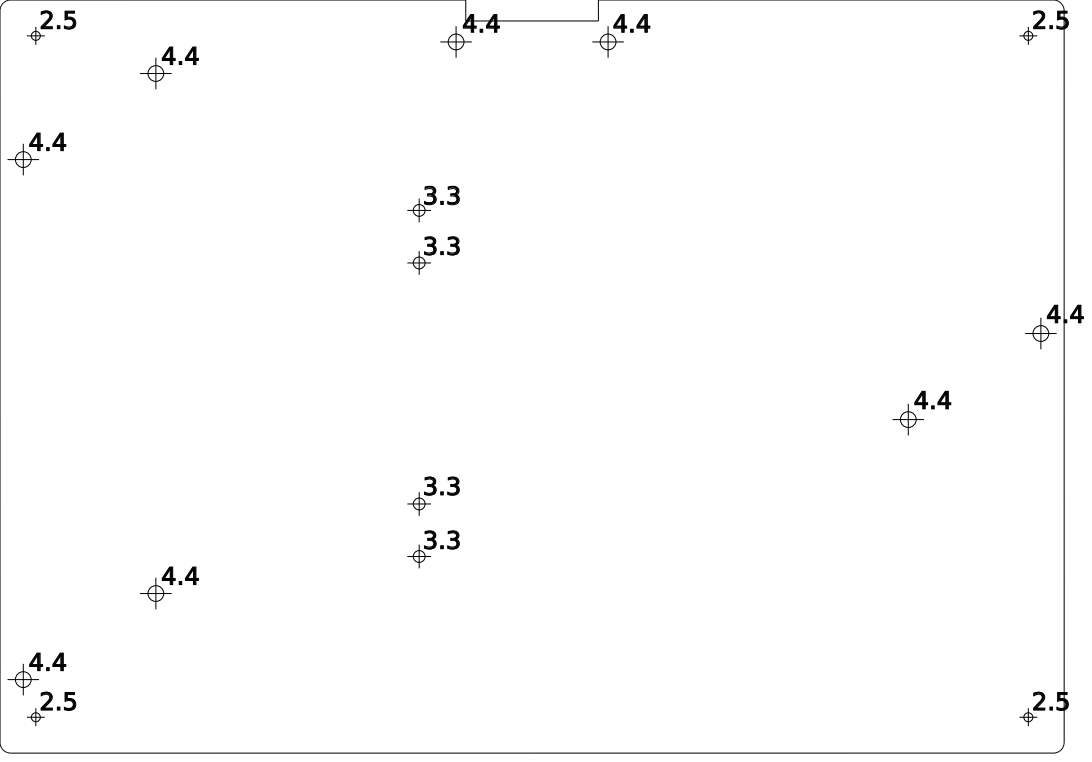
[picture p250: page 1]
