zzorn/Mendel90/(commit log)

2012-09-26 Added custom config for nema23 steppers, and a conf for the printer I'm building for the lab. Also added the nema23 stepper configuration, the radius parameters are just guesses, others looked up.
    [stepper-motors.scad, sturdy-hacklab_config.scad, sturdy-zz_config.scad]
2012-10-01 Working on A4 sized printbed version.
    [sturdy-zz_config.scad]
2012-10-01 Chnaged bed to support non-rectangular heated bed.
    [bed.scad]
2012-10-01 Added configuration for machine with A4 build area.
    [sturdy-a4_config.scad]
2012-10-03 Added generated files for reference.
    [bar_clamps.stl, cable_clip_AB.stl, cable_clip_AD.stl, cable_clip_CA.stl, cable_clips.stl, cal.stl, d_motor_bracket.stl, d_motor_bracket_lid.stl]
2012-12-09 Tuned machine.
    [config.scad, machine.scad]
2012-12-09 Fixed import file case issue.
    [main.scad]
2012-12-09 Changed power supply to atx style, generated files.
    [atx_brackets.stl, atx_long_bracket.stl, atx_short_bracket.stl, bar_clamps.stl, cal.stl, d_motor_bracket.stl, d_motor_bracket_lid.stl, d_motor_brackets.stl]
